Thommie0208/TURTLE/README.md

# TURTLE

The TURTLE, Transportable Universal Research Tool for Live Examination, seeks to allow imagining in the field. This will allow scientists to take it outside and immediately image a sample found there.
