Thommie0208/TURTLE/TURTLE Defense.pdf

# TURTLE

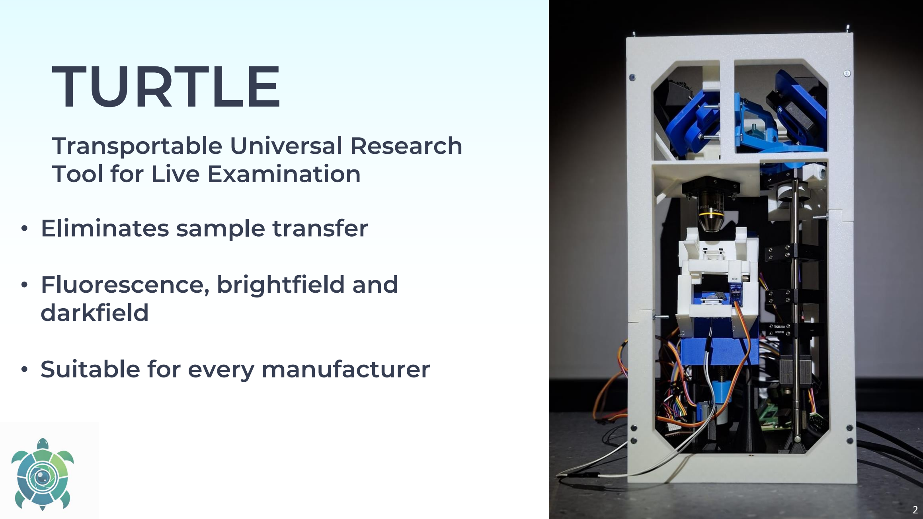
[picture p1: page 1]

# Transportable Universal Research Tool for Live Examination

# - Eliminates sample transfer

# - Fluorescence, brightfield and darkfield

# - Suitable for every manufacturer

# General Information

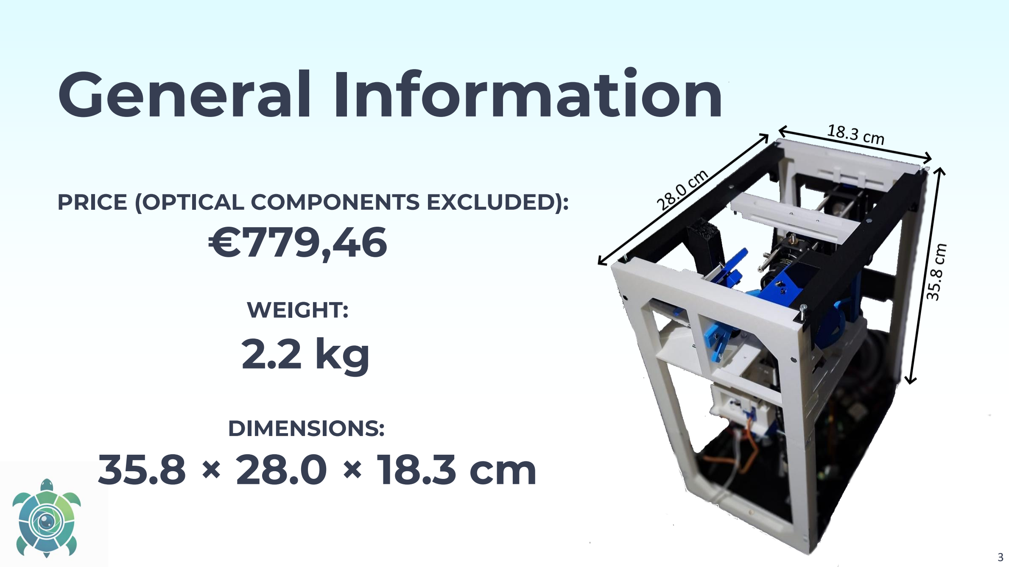
[picture p2: page 2]

## WEIGHT:

# 2.2 kg

## DIMENSIONS:

## PRICE (OPTICAL COMPONENTS EXCLUDED):

35.8 × 28.0 × 18.3 cm

€779,46

# Optical path

## THEORETHICAL MAGNIFICATION:

## RAYLEIGH’S CRITERION:

8.33x

1.057 μm

## CAMERA RESOLUTION:

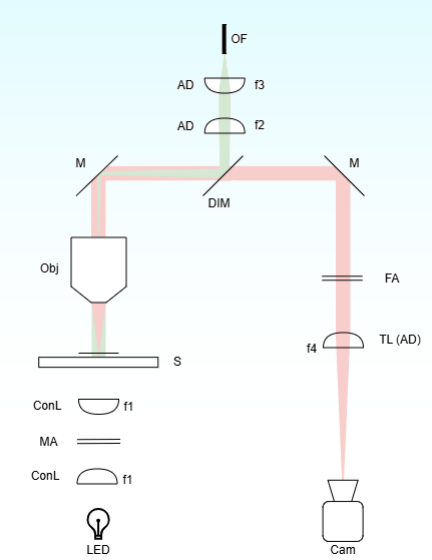
[picture p3: figure]

0.414 μm | Legend: OF = optical fiber, M = mirror, DIM = dichroic mirror,

Obj = objective lens, S = sample, ConL = condensor lens, MA = mask array, FA = filter array, TL = tube lens, AD = achromatic doublet, Cam = camera

f1 = 12 mm, f2 = 150 mm, f3 = 75 mm, f4 = 150 mm | 4

# Optical path

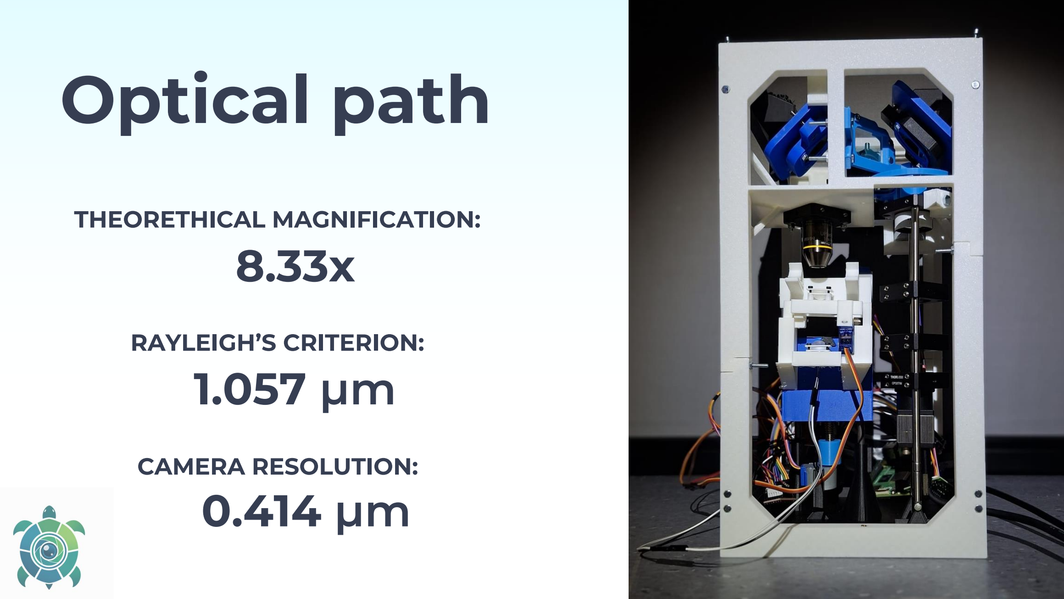
[picture p4: page 4]

## THEORETHICAL MAGNIFICATION:

## RAYLEIGH’S CRITERION:

8.33x

1.057 μm

## CAMERA RESOLUTION:

0.414 μm

# 0.37°/rev

±5°

## ADJUSTEMENT RESOLUTION:

## RANGE:

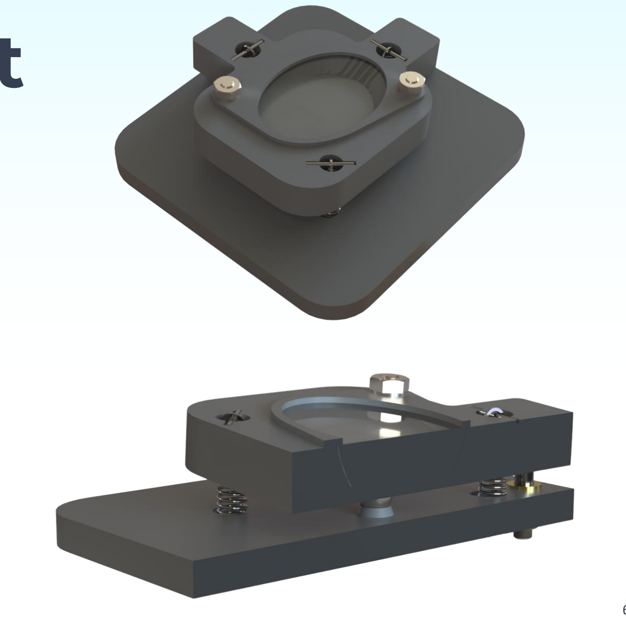
[picture p5: figure]

# Mirror Mount

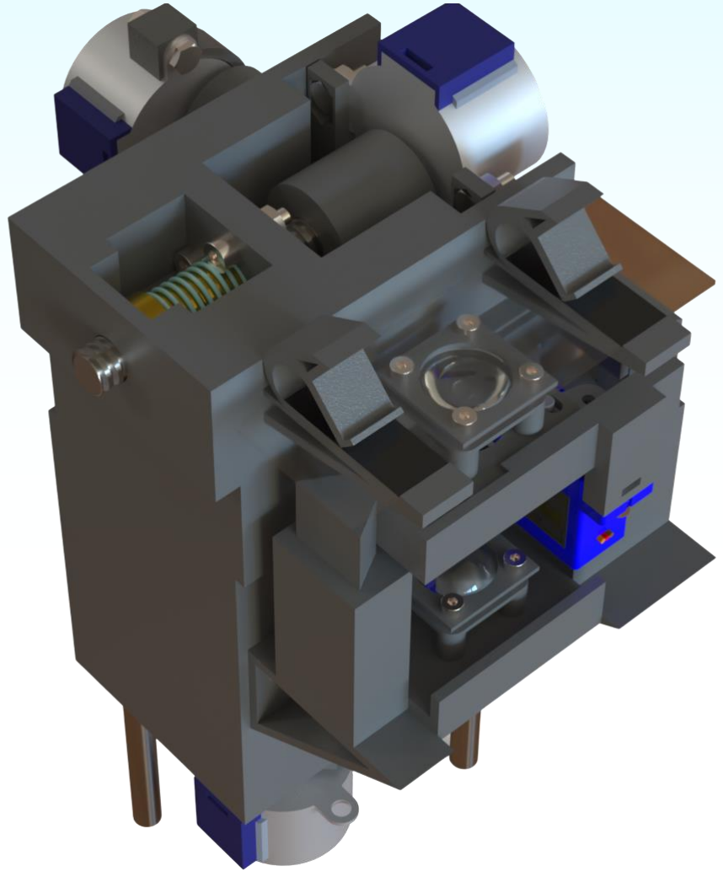
[picture p6: figure]

# Stage

# - Adjustment accuracy: 0.48 μm/step • Range of: • Y: 10mm • X: 8mm • Z: 35mm • Vibrations

# USAF PS75P

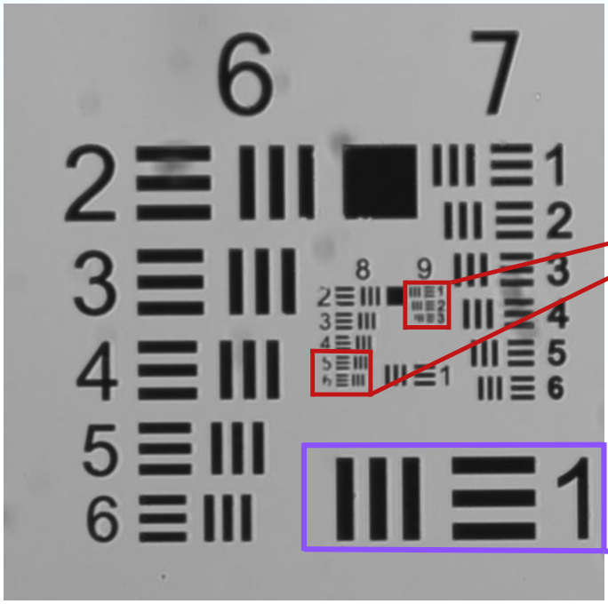
[picture p7: figure]

# Estimated Magnification

# Resolution

# USAF Resolution

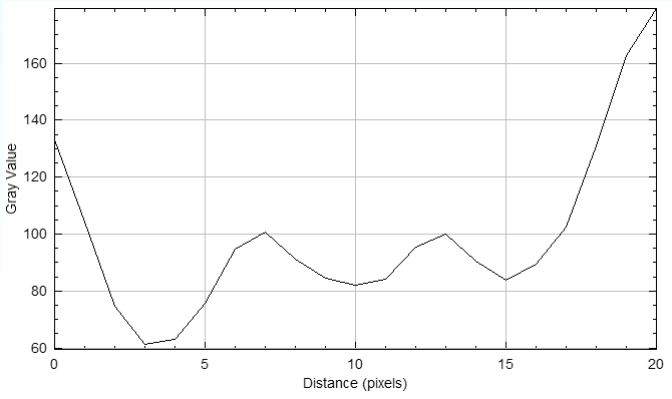
[picture p8: figure]
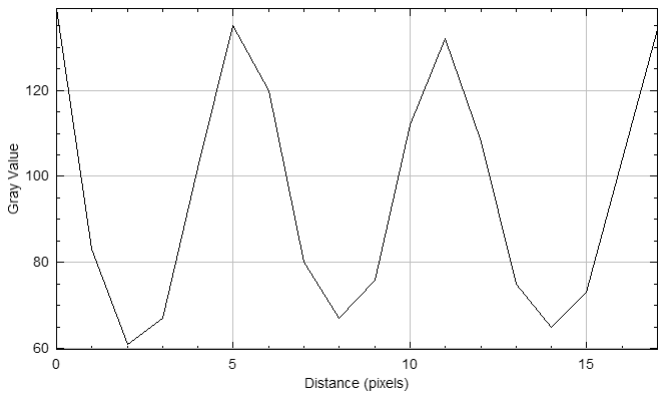
[picture p9: figure]

The intensity curve of group 8 element 5 of sample 4 (measured horizontally)

# - Theoretical values: 1.057 μm - 5 Samples - Required dip of 26.3% - Analysed interspacings: 1.2 μm to 0.78 μm

# 1.2 μm

# Result:

The intensity curve of group 8 element 5 of sample 4 (measured vertically)

# Estimated Magnification

# - Theoretical values: 8.33 - 5 Samples - USAF PS75P: Group 6, element 1 - Full width at half maximum

8.45 ± 0.08

# Result:

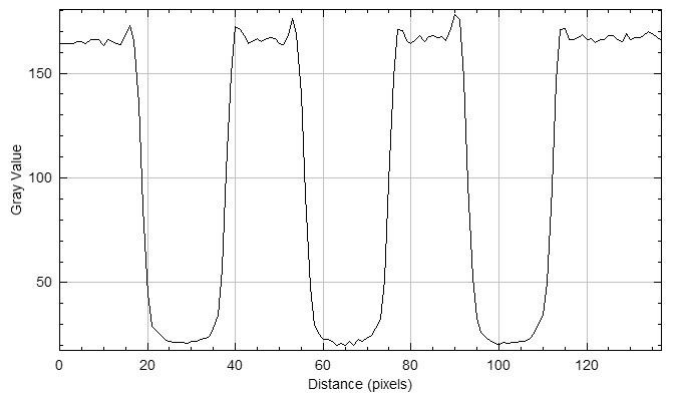
[picture p10: figure]

The intensity curve of group 6 element 1 of sample 1 (measured horizontally)

# Point Spread Function

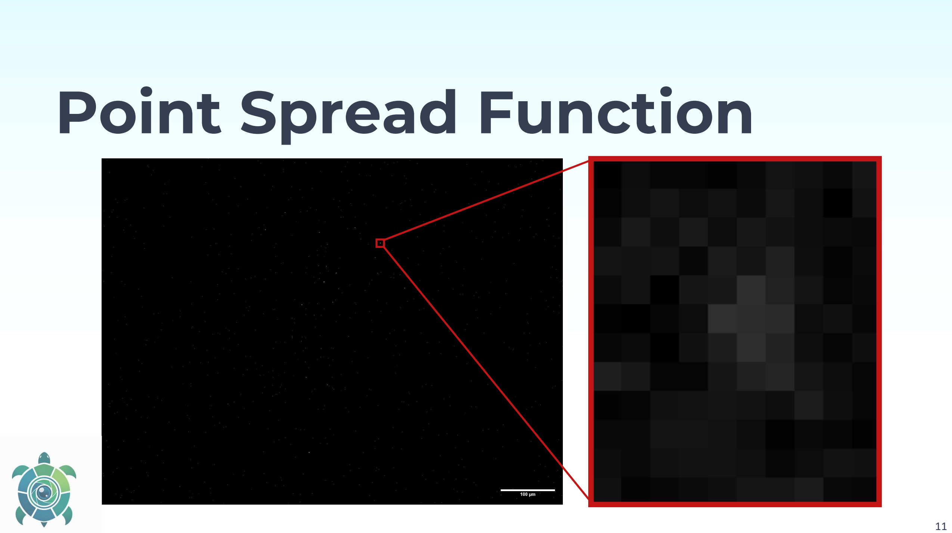
[picture p11: page 10]

# Point Spread Function

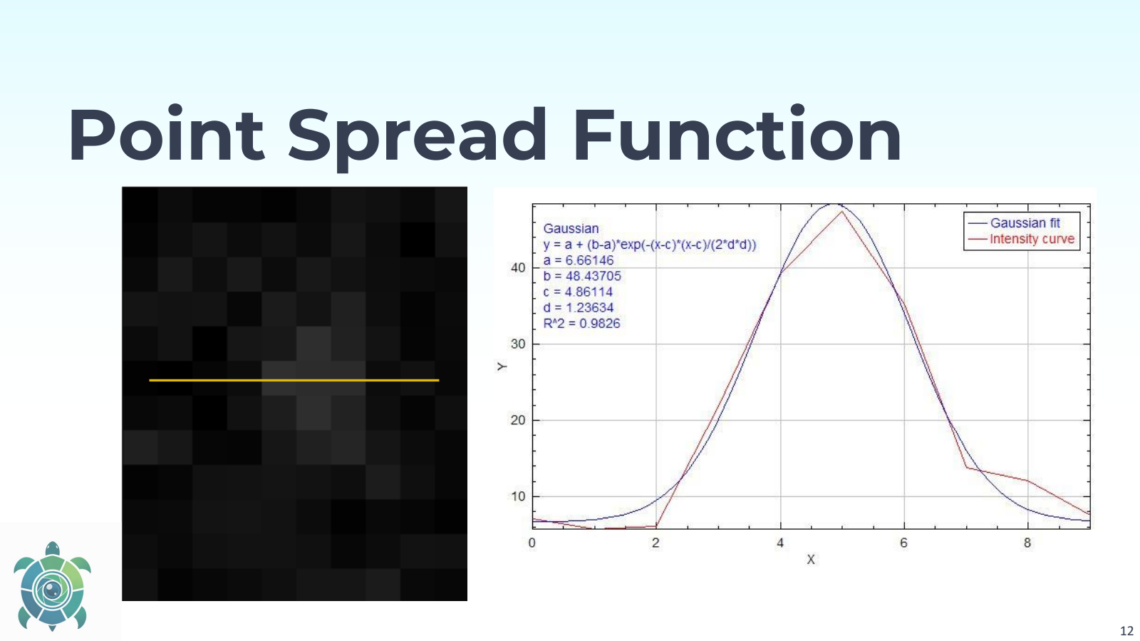
[picture p12: page 11]

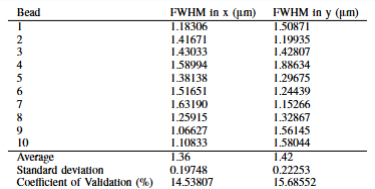
[picture p13: figure]

# 1 μm

## SIMULATED FWHM:

## MEASURED FWHM:

1.39 ± 0.01 μm

# Point Spread Function

# Images

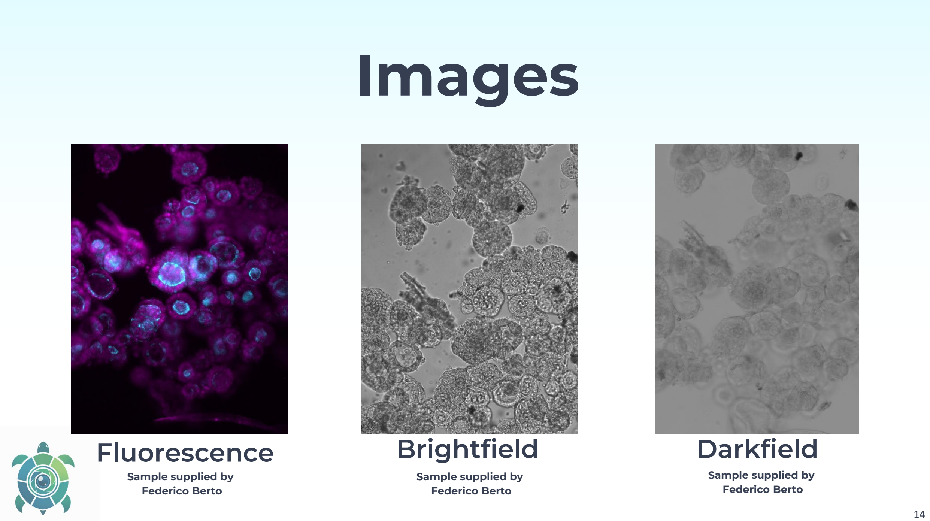
[picture p14: page 13]

Fluorescence | Brightfield | Darkfield
Sample supplied by Federico Berto | Sample supplied by Federico Berto | Sample supplied by Federico Berto

# TURTLE

## To eliminate sample transfer

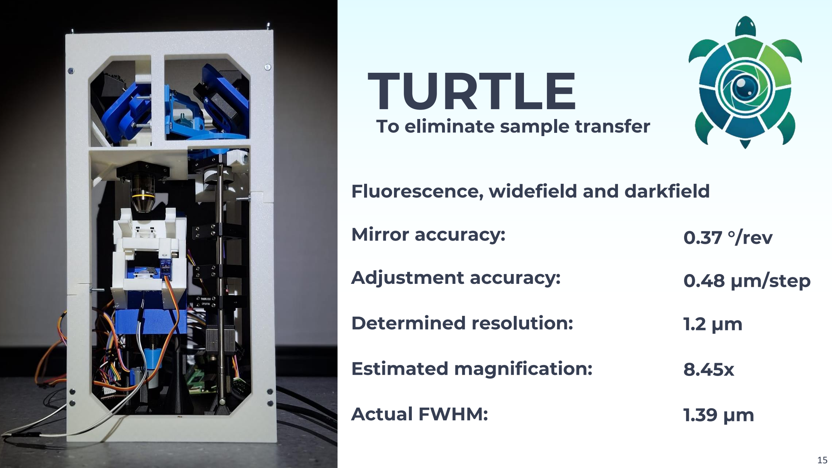
[picture p15: page 14]

## 0.37 °/rev

Determined resolution: | 1.2 μm

## Mirror accuracy:

## Fluorescence, widefield and darkfield

Estimated magnification: | 8.45x
Adjustment accuracy: | 0.48 μm/step
Actual FWHM: | 1.39 μm

# Questions Table of Content

## - TURTLE BILL OF MATERIAL - BALL JOINT BILL OF MATERIAL - GIMBAL BILL OF MATERIAL - 1'' MIRRORS COMPARISON - ELLIPTICAL MIRRORS COMPARISON - Stage - MIRROR DRIFT TEST - LASER MODULE - IMAGE STITCHING - Z-STACK - ELECTRONICS LAYOUT

## - INTERFACE - General Formulas - PSF Formulas - Estimated Magnification - Uncertainty Formulas - OpenUC2 - OpenFlexure - USAF PS75P - PSF Measurements - MORE IMAGES

# TURTLE Bill of Material

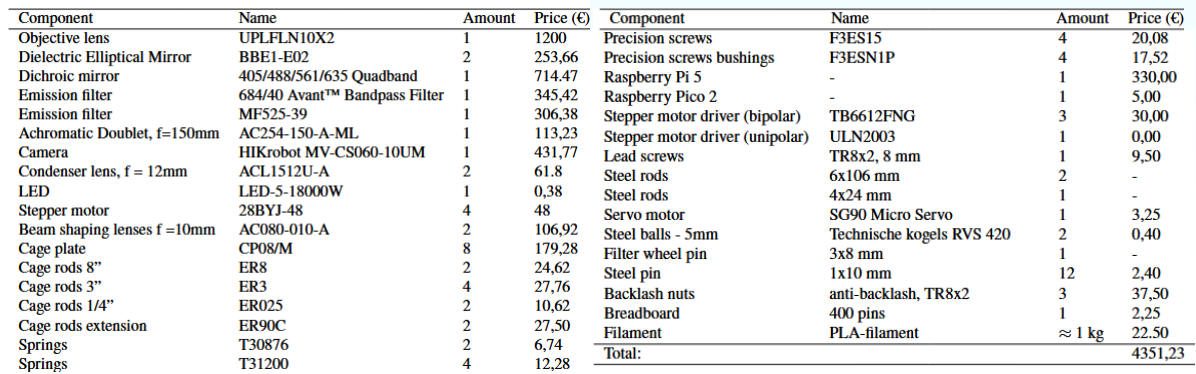
[picture p16: figure]

# Ball Joint Bill of Material

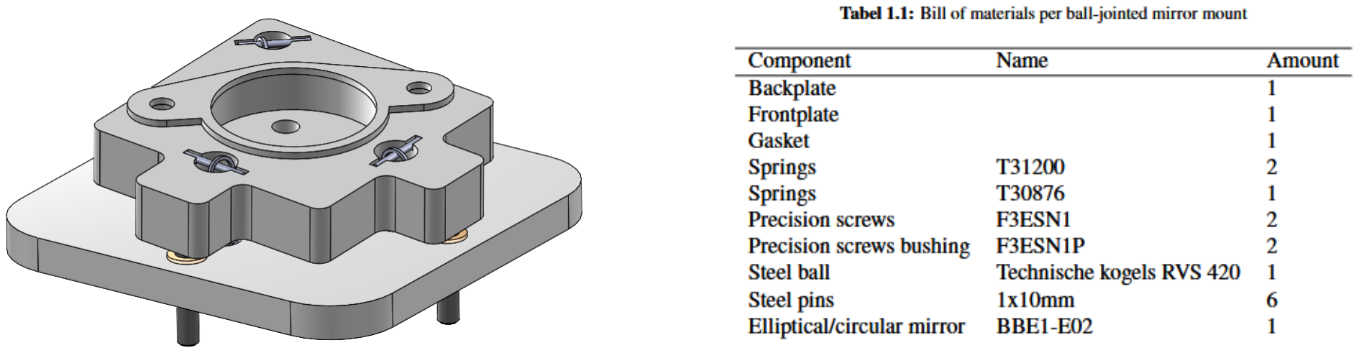
[picture p17: figure]

# Gimbal Bill of Material

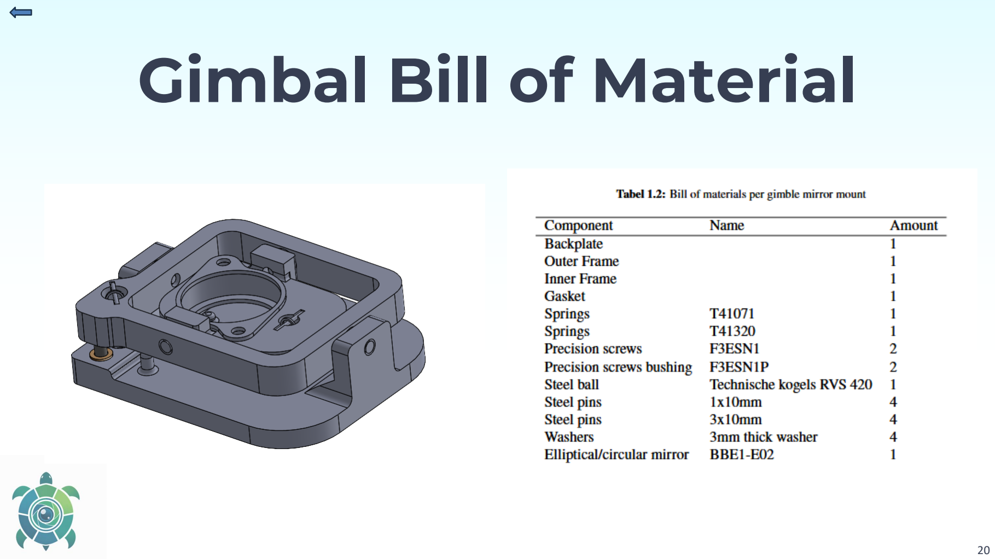
[picture p18: page 19]

# 1" mirrors comparison

| Ball-joint | Gimbal | Thor stand | Thor Gimbal
Resolution (°/rev) | 0.47 | 0.47 | 0.46 | 1.00
Range (°) | ±5 | ±5 | ±4 | ±15
Induced Translation (Dist: Surf – Cen (mm)) | Yes (9.5) | No (0) | Yes (26.6) | No (0)
Dimension (mm) | 53 × 53 × 22 | 70 × 57 × 23 | 50 x 50 x 25 | 54 x 54 x 28
Price (€) | 32.17 | 32.00 | 40.71 | 316.58

# Elliptical mirrors comparison

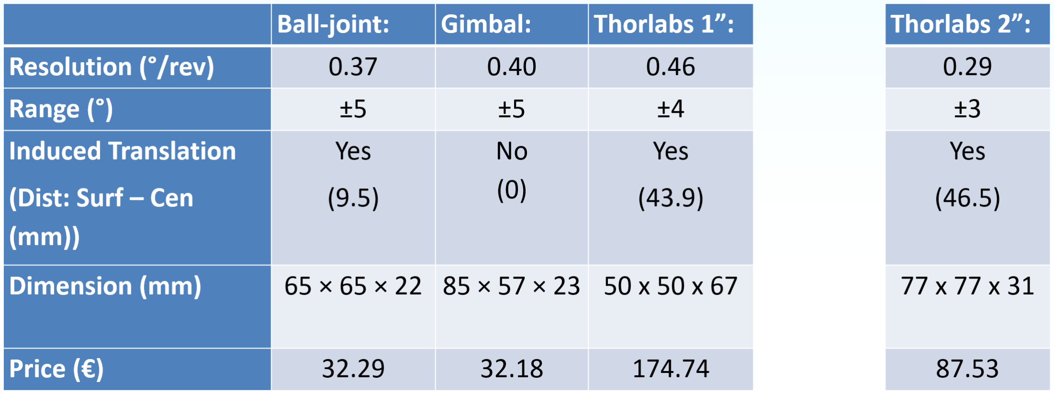
[picture p19: figure]

# Mirror Drift Test

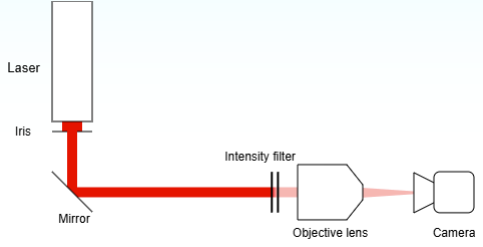
[picture p20: figure]

# Laser module

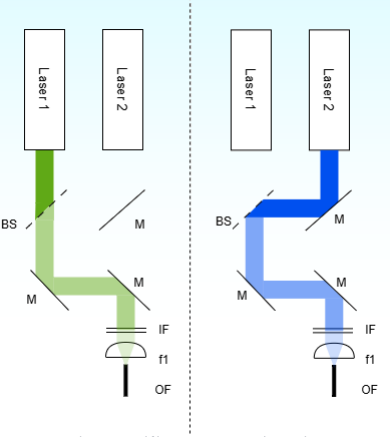
[picture p21: figure]

Legend: OF = optical fiber, M = mirror, BS = beamsplitter, IF = intensity filter

f1 = 10 mm

# - Extendable design

# - Beamsplitter instead of dichroic

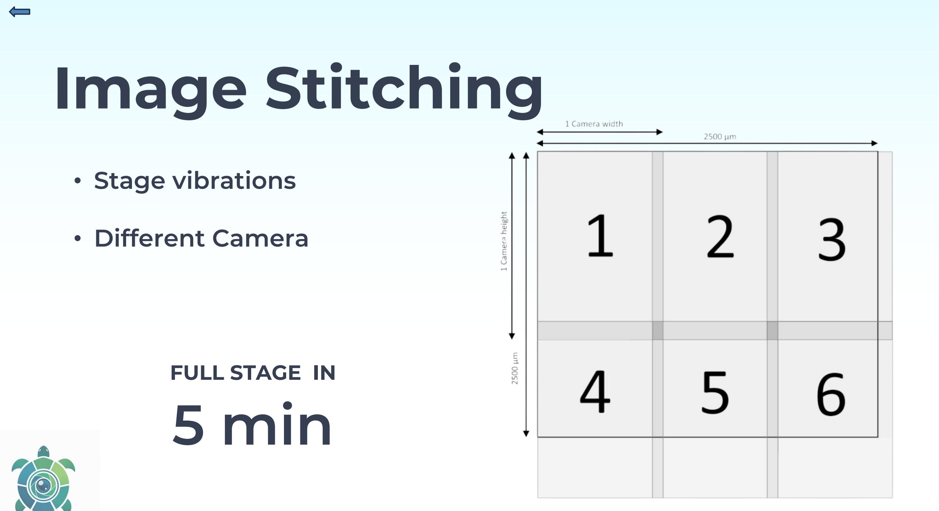
[picture p22: figure]
Image Stitching; 5 min; FULL STAGE IN; • Stage vibrations; • Different Camera

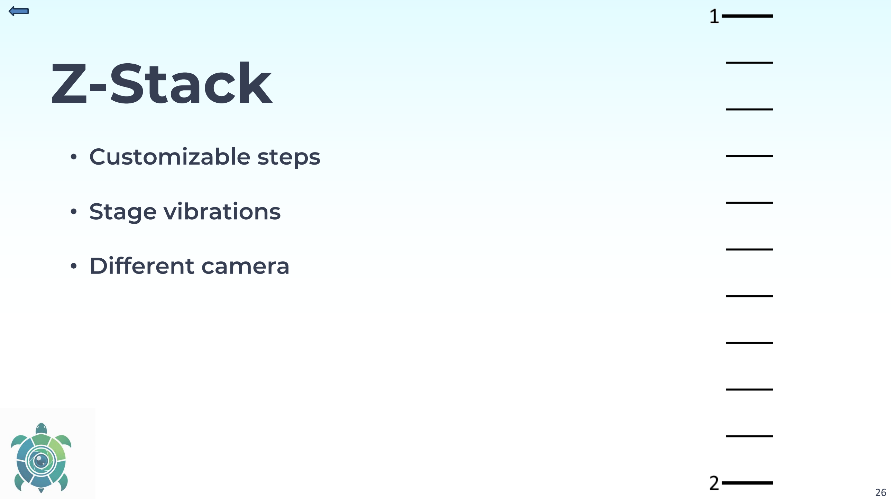
[picture p23: figure]
Z-Stack; • Customizable steps; • Stage vibrations; • Different camera

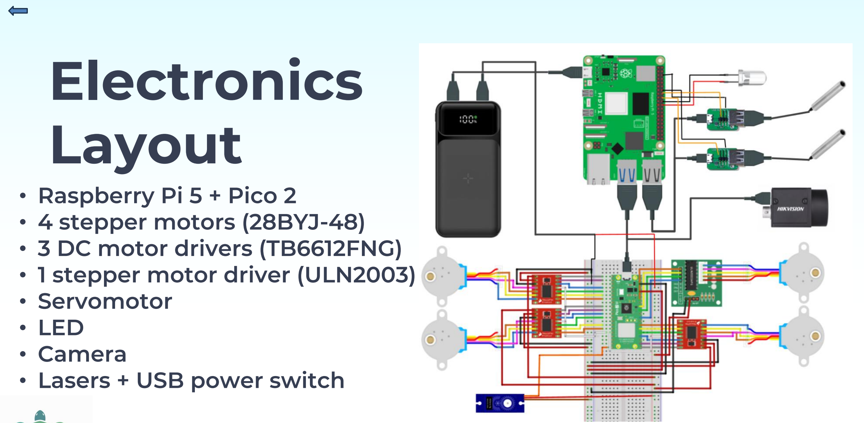
[picture p24: figure]
Electronics Layout

# - Raspberry Pi 5 + Pico 2 • 4 stepper motors (28BYJ

- 3 DC motor drivers (TB6612FNG) • 1 stepper motor driver (ULN2003) • Servomotor • LED • Camera • Lasers + USB power switch

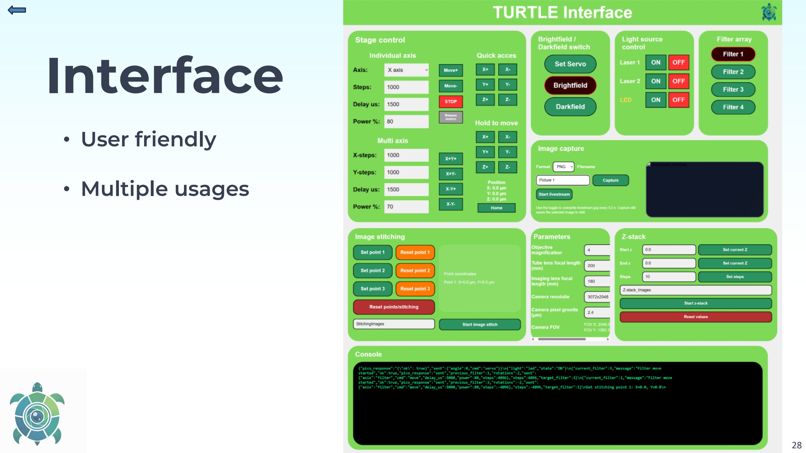
[picture p25: figure]
Interface; • User friendly; • Multiple usages

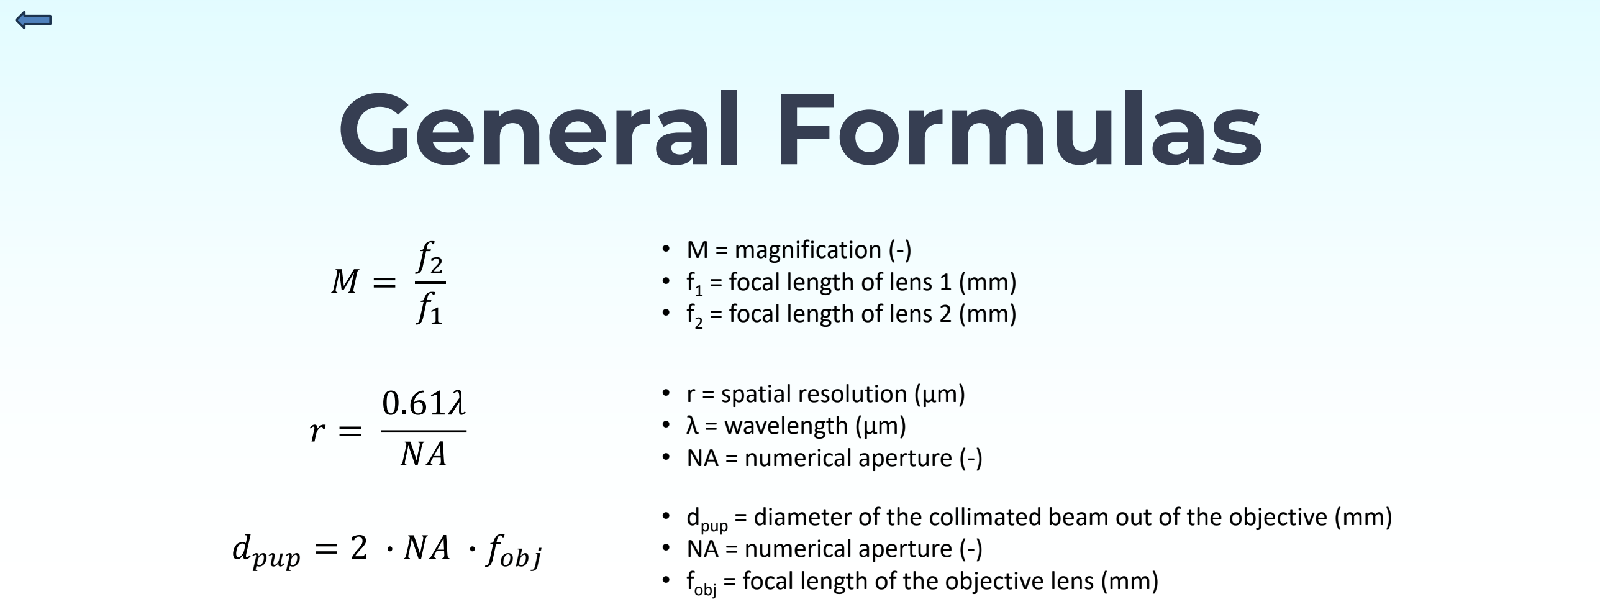
[picture p26: figure]
General Formulas; dpup = 2 ∙ NA ∙ fobj; • M = magnification (-) • f1 = focal length of lens 1 (mm) • f2 = focal length of lens 2 (mm); • r = spatial resolution (μm) • λ = wavelength (μm) • NA = numerical aperture (-); • NA = numerical aperture (-)

Lmax =

ftube(dtube − dpup)

dimage sensor

- dpup = diameter of the collimated beam out of the objective (mm)
- fobj = focal length of the objective lens (mm)
- Lmax = maximum length between the objective and tube lens (mm)
- f

tube = focal length of the tube lens (mm)
- dtube = diameter of the tube lens (mm)
- dpup = diameter of the collimated beam out of the objective (mm)
- dimage sensor = diameter of the image sensor (mm)

# PSF Formulas

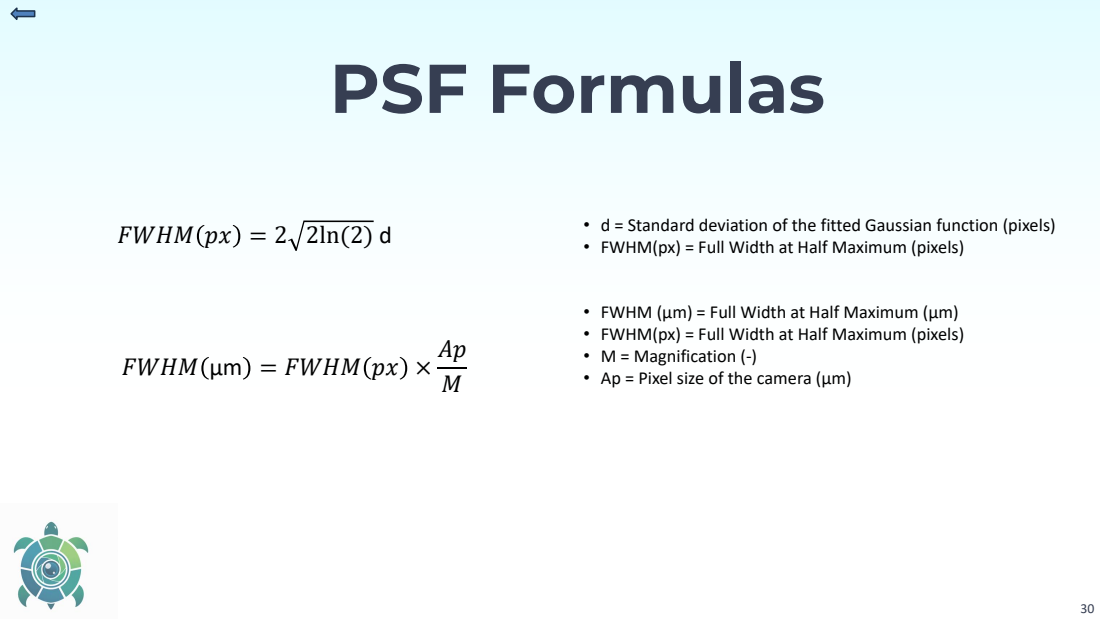
[picture p27: page 29]
FWHM px = 2 2ln(2) d

• d = Standard deviation of the fitted Gaussian function (pixels)
• FWHM(px) = Full Width at Half Maximum (pixels)

• FWHM (μm) = Full Width at Half Maximum (μm)
• M = Magnification (-)
• Ap = Pixel size of the camera (μm)

FWHM μm = FWHM px ×

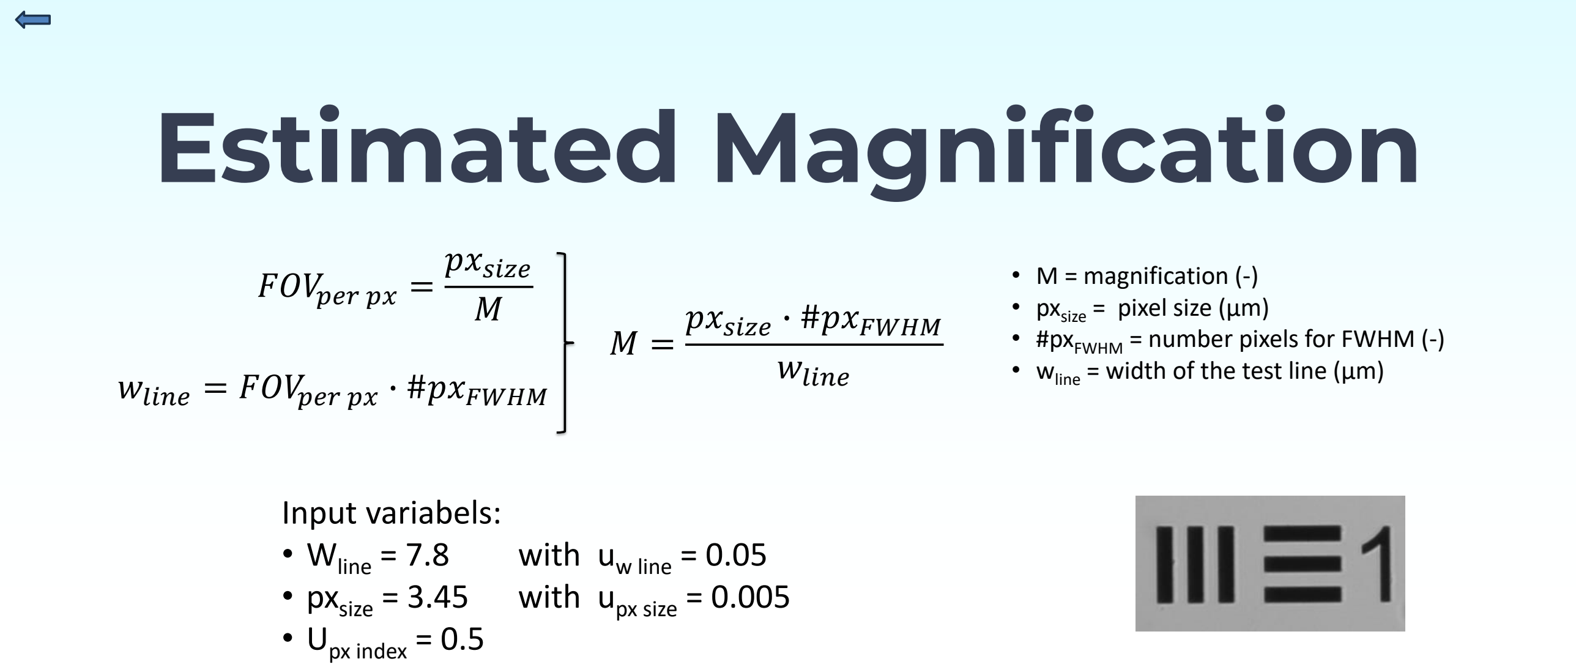
[picture p28: figure]
Estimated Magnification; FOVper px =; pxsize M; wline = FOVper px; ∙ #pxFWHM; pxsize ∙ #pxFWHM; wline; • M = magnification (-) • pxsize = pixel size (μm) • #pxFWHM = number pixels for FWHM (-) • wline = width of the test line (μm); Input variabels:; • Wline = 7.8; with uw line = 0.05; • pxsize = 3.45; with upx size = 0.005; • Upx index = 0.5

## Magnification vertical:

8,4 ± 0,1

## Magnification horizontal:

8,5 ± 0,1

## Magnification estimate:

8,45 ± 0,08

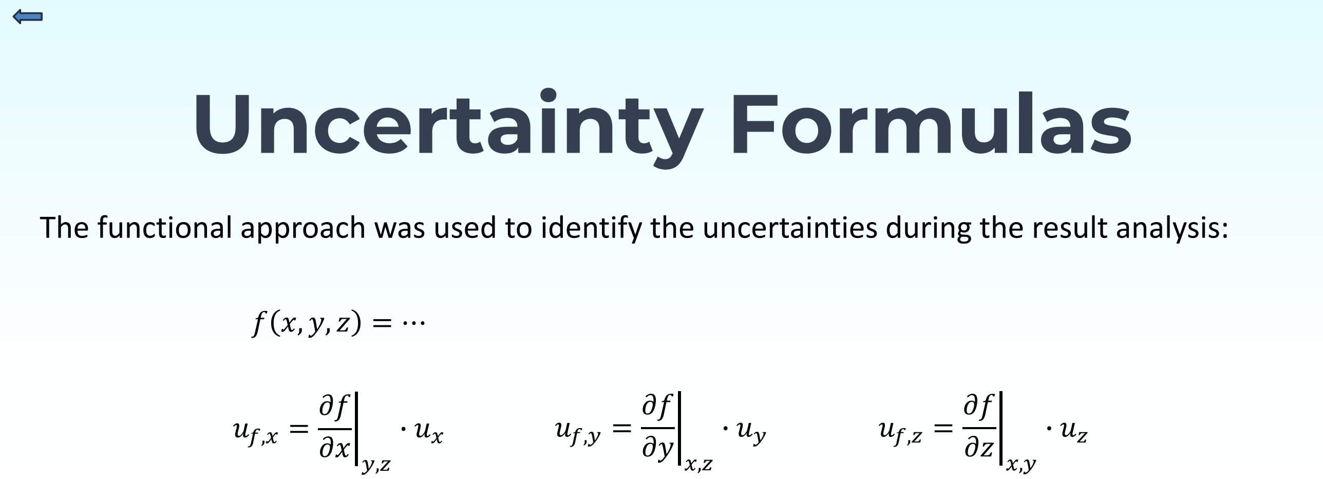
[picture p29: figure]
Uncertainty Formulas

The functional approach was used to identify the uncertainties during the result analysis:

uf = uf,x

2 + uf,y

2 + uf,z

2

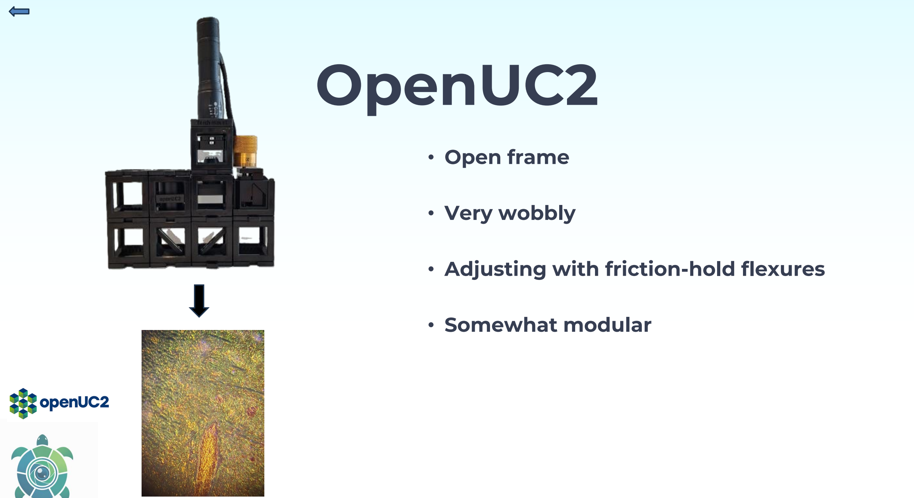
[picture p30: figure]
OpenUC2; • Open frame; • Very wobbly; • Adjusting with friction-hold flexures; • Somewhat modular

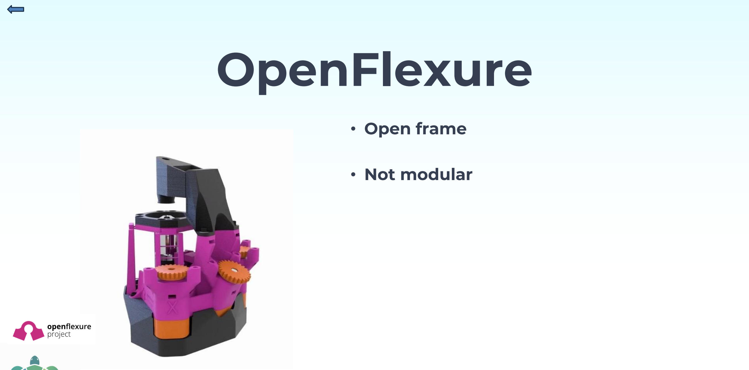
[picture p31: figure]
OpenFlexure; • Open frame; • Not modular

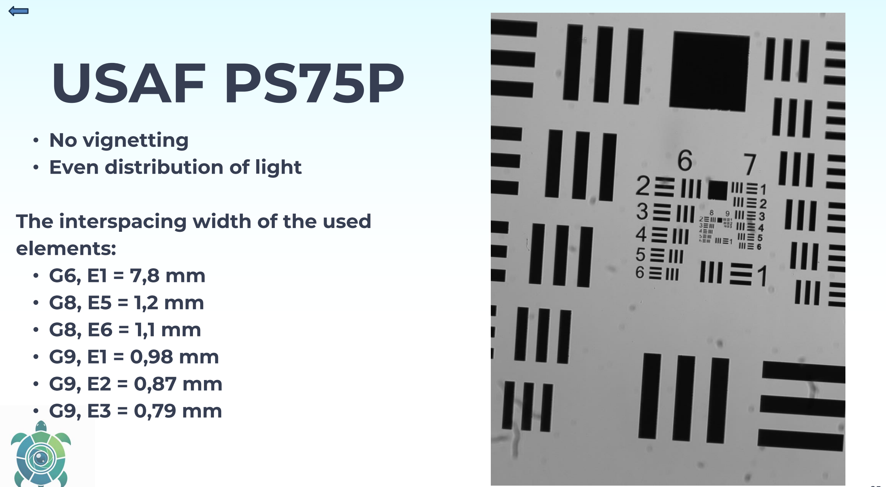
[picture p32: figure]
USAF PS75P; The interspacing width of the used

## - No vignetting • Even distribution of light

elements: • G6, E1 = 7,8 mm • G8, E5 = 1,2 mm • G8, E6 = 1,1 mm • G9, E1 = 0,98 mm • G9, E2 = 0,87 mm • G9, E3 = 0,79 mm

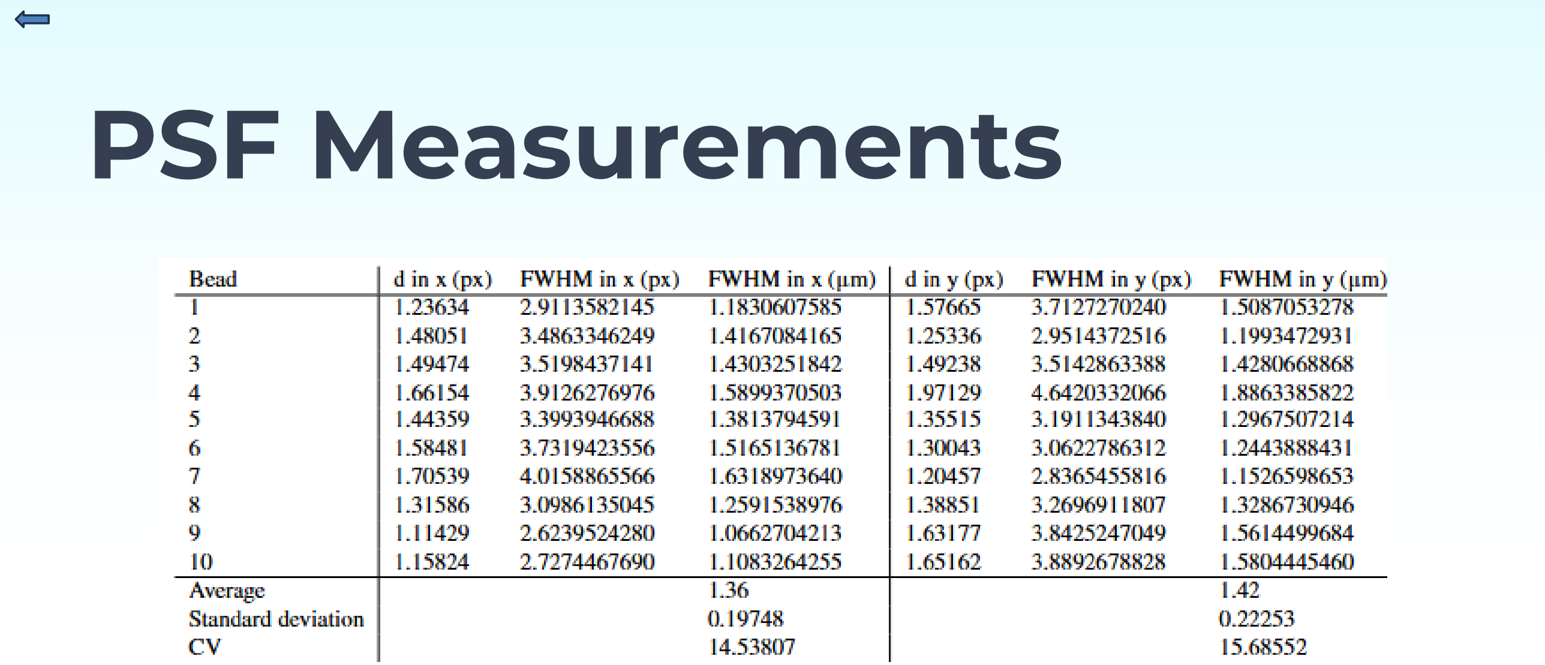
[picture p33: figure]
PSF Measurements

# More images

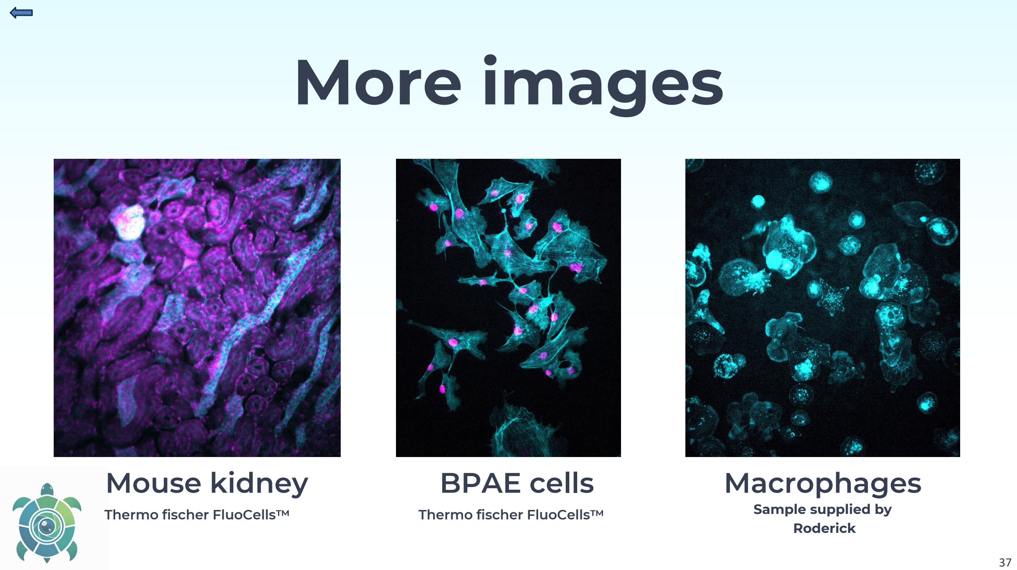
[picture p34: page 36]

Mouse kidney | BPAE cells | Macrophages
Thermo fischer FluoCells | Thermo fischer FluoCells | Sample supplied by Roderick

# More images

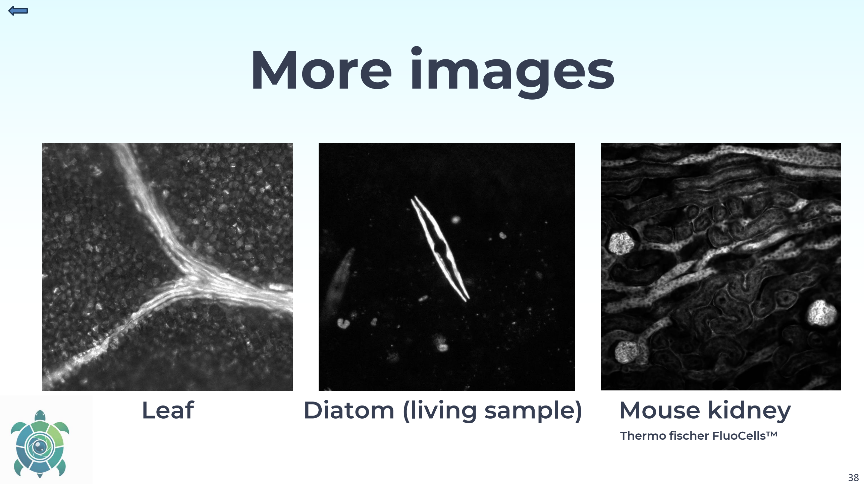
[picture p35: page 37]

Leaf | Diatom (living sample) | Mouse kidney Thermo fischer FluoCells

# Stage

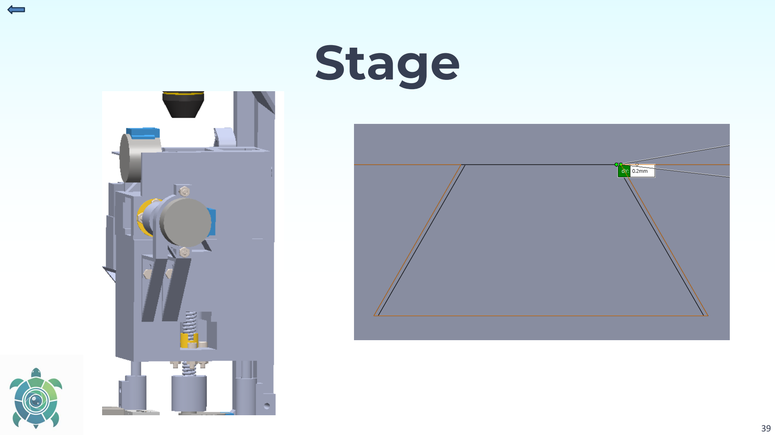
[picture p36: page 38]
