Thommie0208/TURTLE/Calculations/Calculations for TURTLE design/Diagram_Ball-Joint_Mirror_Mount_.png

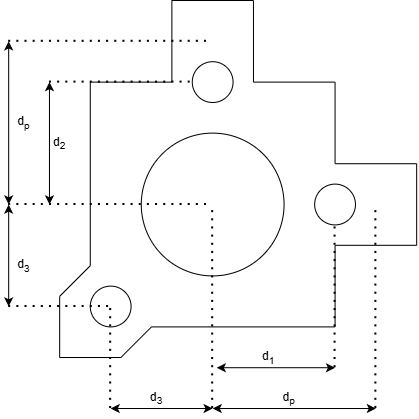
Calculations/Calculations for TURTLE design/Diagram_Ball-Joint_Mirror_Mount_.png
