Thommie0208/TURTLE/Calculations/Calculations for TURTLE design/Diagram_Optical_Axis_Shift.png

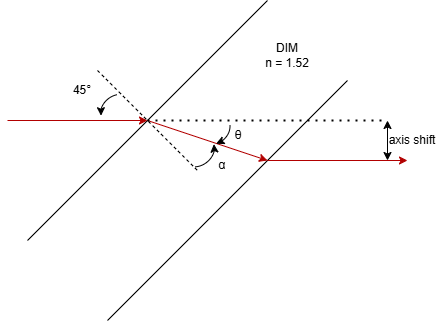
Calculations/Calculations for TURTLE design/Diagram_Optical_Axis_Shift.png
