Thommie0208/TURTLE/Calculations/Calculations for TURTLE design/Length_overview_code.png

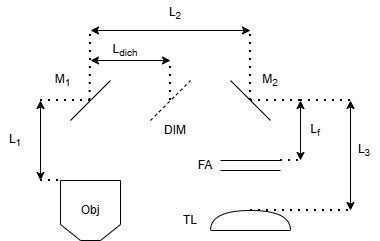
Calculations/Calculations for TURTLE design/Length_overview_code.png
