Thommie0208/TURTLE/TURTLE Software/Images/capture.jpg

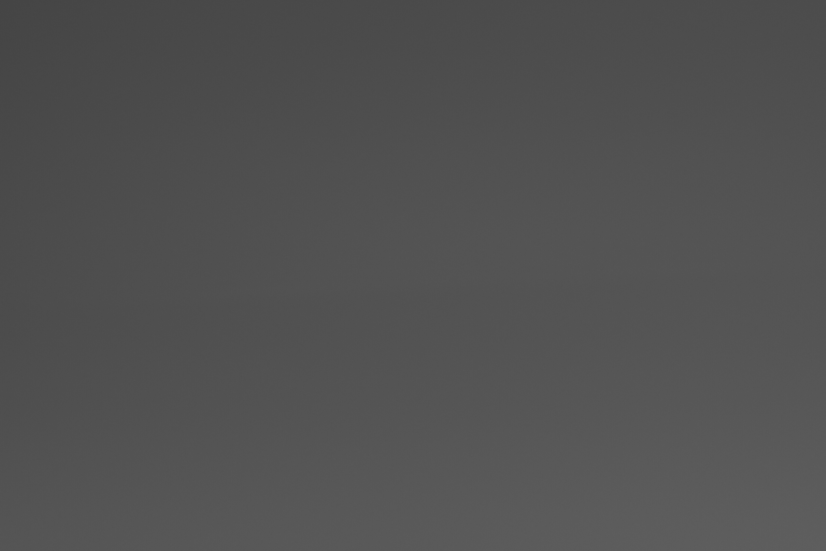
TURTLE Software/Images/capture.jpg
