Thommie0208/TURTLE/CAD/Turtle/Full Sampleholder/Servo/SG90 - Micro Servo 9g - Tower Pro.SLDASM

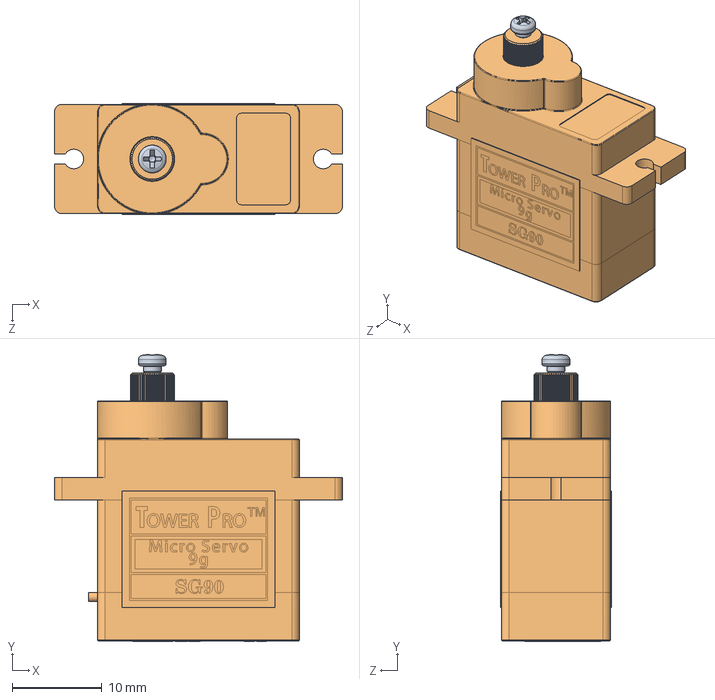
[picture p41: CAD file, 2026-06-19]
CAD/Turtle/Full Sampleholder/Servo/SG90 - Micro Servo 9g - Tower Pro.SLDASM
32.1 x 32.0 x 12.4 mm
SG90 - Micro Servo 9g - Tower Pro.1
SG90 - Micro Servo 9g - Tower Pro.6
