Thommie0208/TURTLE/CAD/Turtle/Eliptical Mirror Mount - Ball Joint 2.SLDASM

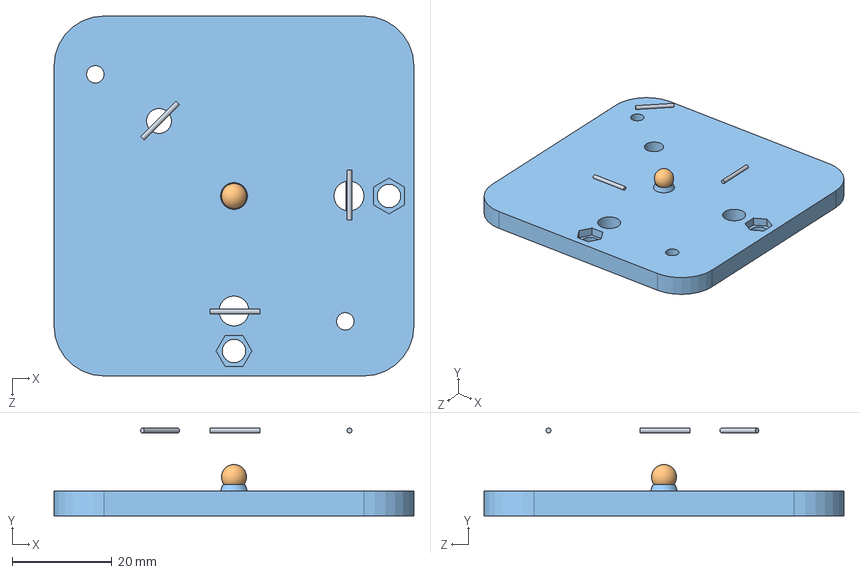
[picture p43: CAD file, 2026-06-19]
CAD/Turtle/Eliptical Mirror Mount - Ball Joint 2.SLDASM
72.0 x 17.6 x 72.0 mm
Back Plate - Eliptical Mirror Mount
5mm Steel Ball
1x10mm Steel Pin x 6
