Thommie0208/TURTLE/CAD/Assemblies not used in TURTLE but useful/1 Inch Backplate - Gimbal Mount - Thor Adapted.SLDPRT

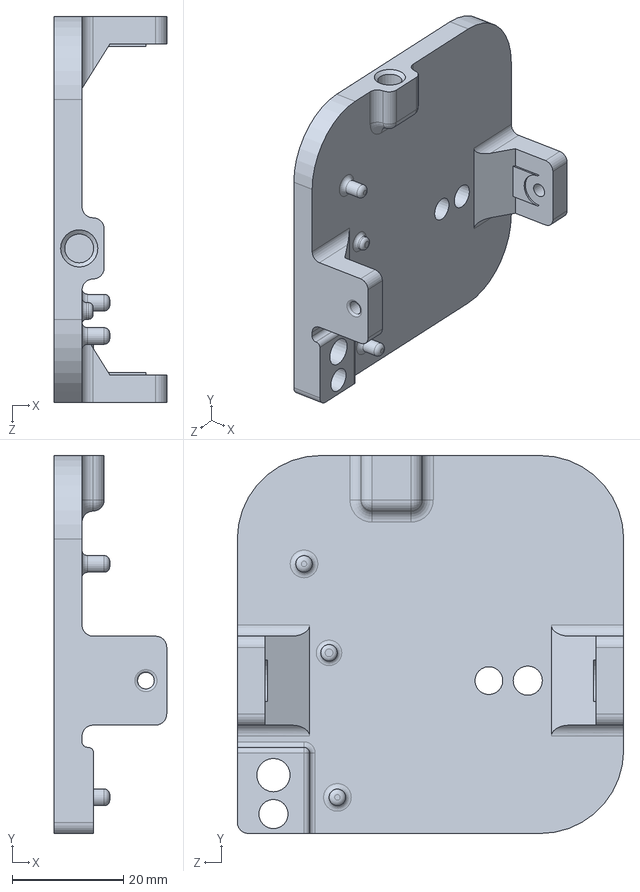
[picture p44: CAD file, 2026-06-19]
CAD/Assemblies not used in TURTLE but useful/1 Inch Backplate - Gimbal Mount - Thor Adapted.SLDPRT
20.2 x 68.0 x 69.5 mm
