Thommie0208/TURTLE/CAD/Turtle/Eliptical Mirror Mount - Ball Joint/1x10mm Steel Pin.SLDPRT

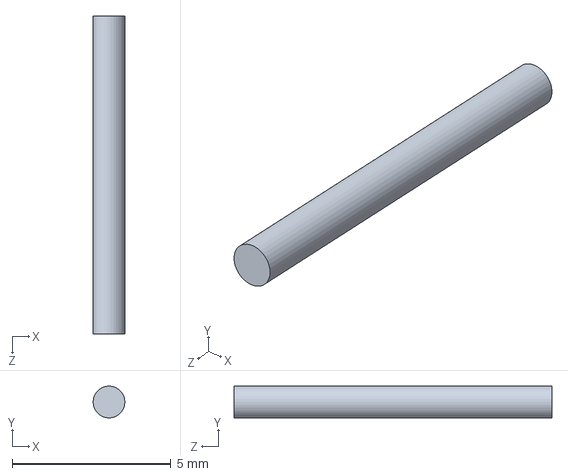
[picture p45: CAD file, 2026-06-15]
CAD/Turtle/Eliptical Mirror Mount - Ball Joint/1x10mm Steel Pin.SLDPRT
1.00 x 0.996 x 10.0 mm
