Thommie0208/TURTLE/CAD/Turtle/Full Sampleholder/Sampleholder Top.SLDPRT

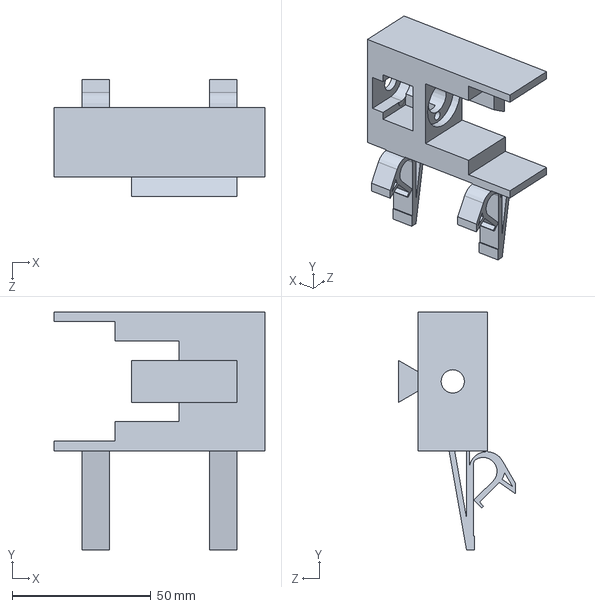
[picture p46: CAD file, 2026-06-19]
CAD/Turtle/Full Sampleholder/Sampleholder Top.SLDPRT
76.0 x 85.7 x 42.0 mm
