Thommie0208/TURTLE/CAD/Turtle/Solidworks etc/R1_24-006-005.SLDPRT

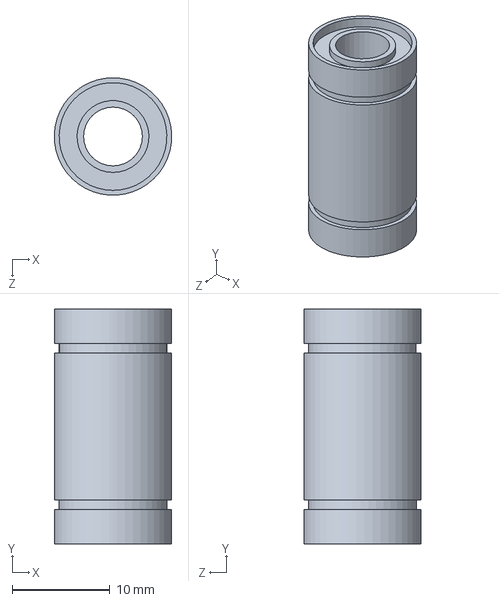
[picture p47: CAD file, 2026-06-19]
CAD/Turtle/Solidworks etc/R1_24-006-005.SLDPRT
12.0 x 24.0 x 12.0 mm
