Thommie0208/TURTLE/CAD/Assemblies not used in TURTLE but useful/Back Plate - 1 Inch Mirror Mount - Thor adapt.SLDPRT

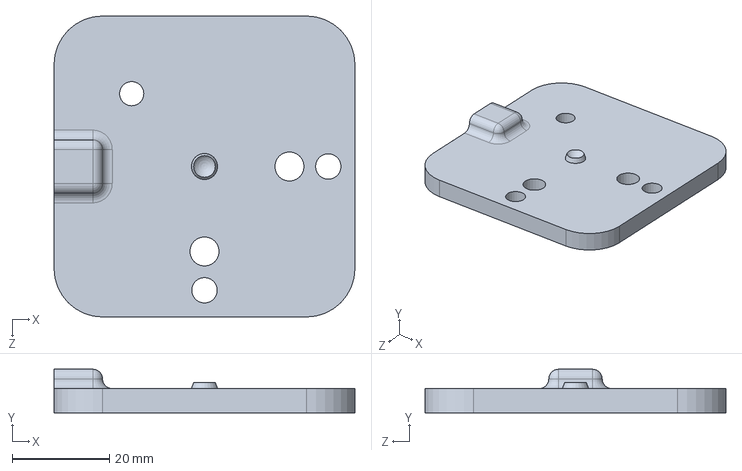
[picture p48: CAD file, 2026-06-19]
CAD/Assemblies not used in TURTLE but useful/Back Plate - 1 Inch Mirror Mount - Thor adapt.SLDPRT
62.0 x 9.00 x 62.0 mm
