Thommie0208/TURTLE/CAD/Turtle/Eliptical Mirror Mount - Ball Joint/Back Plate - Eliptical Mirror Mount.SLDPRT

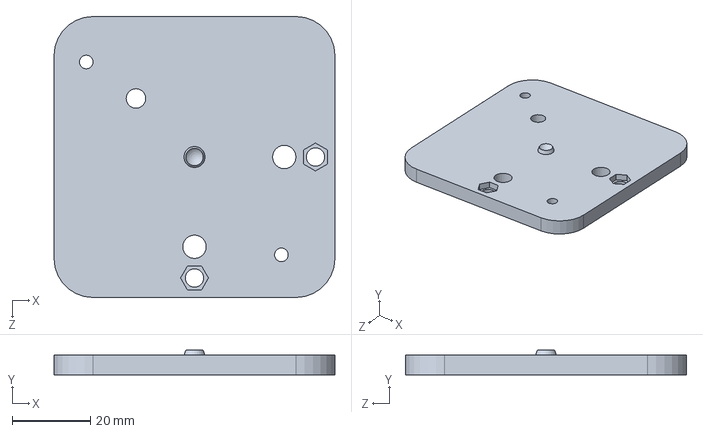
[picture p49: CAD file, 2026-06-15]
CAD/Turtle/Eliptical Mirror Mount - Ball Joint/Back Plate - Eliptical Mirror Mount.SLDPRT
72.0 x 6.28 x 72.0 mm
