Thommie0208/TURTLE/CAD/Turtle/Full Sampleholder/DarkfieldHolder.SLDPRT

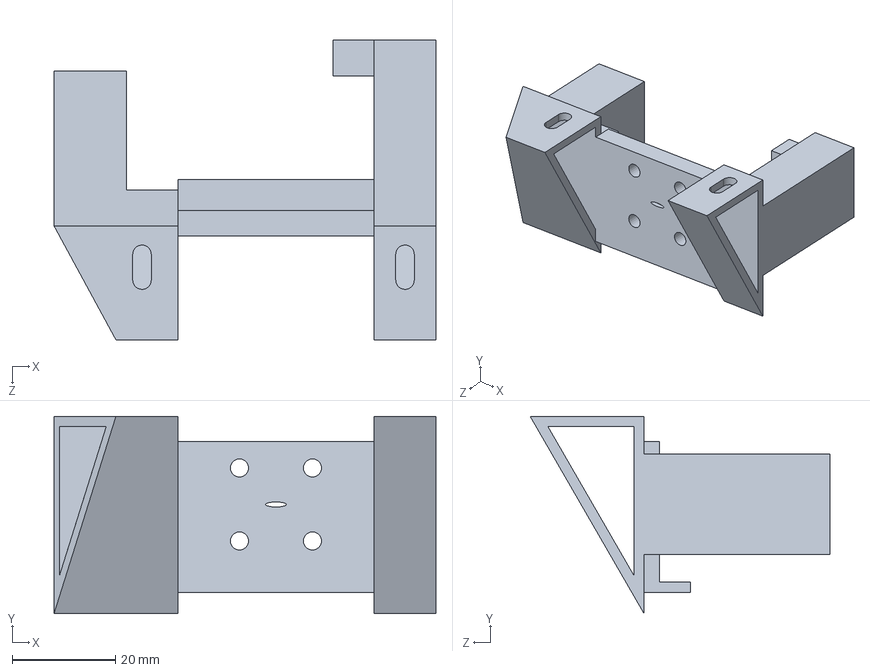
[picture p50: CAD file, 2026-06-19]
CAD/Turtle/Full Sampleholder/DarkfieldHolder.SLDPRT
74.0 x 38.2 x 58.1 mm
