Thommie0208/TURTLE/CAD/Turtle/Full Sampleholder/Servo/SG90 - Micro Servo 9g - Tower Pro.1.SLDPRT

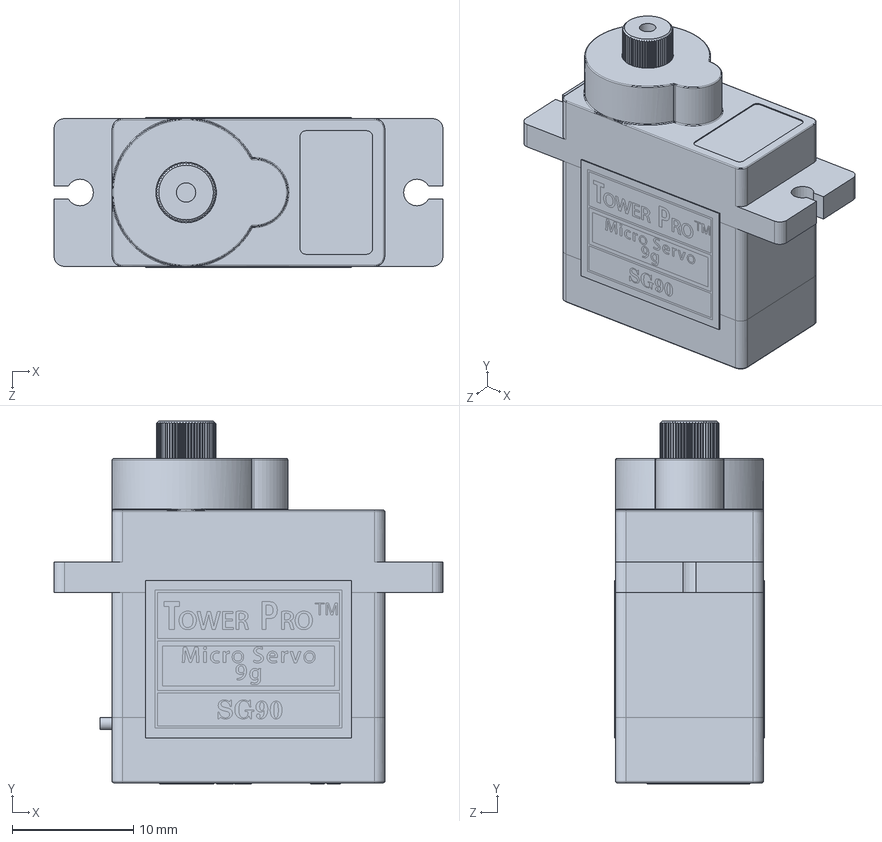
[picture p51: CAD file, 2026-06-15]
CAD/Turtle/Full Sampleholder/Servo/SG90 - Micro Servo 9g - Tower Pro.1.SLDPRT
32.1 x 30.0 x 12.4 mm
