Thommie0208/TURTLE/CAD/Turtle/Solidworks etc/F3ES15-Solidworks.sldprt

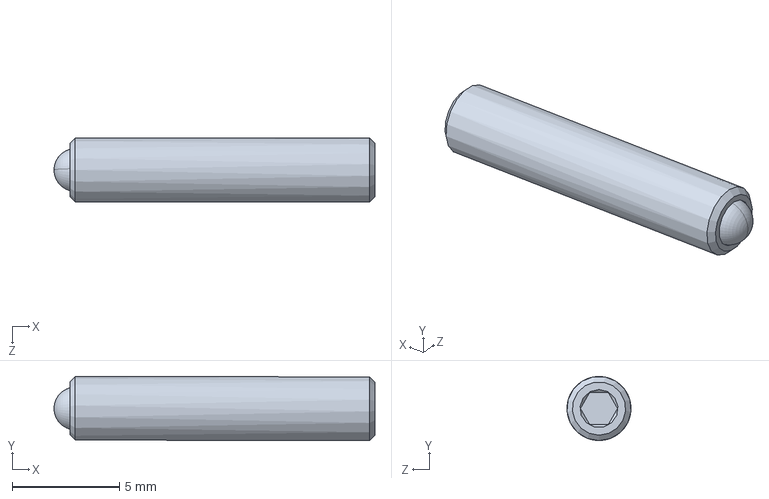
[picture p52: CAD file, 2026-06-19]
CAD/Turtle/Solidworks etc/F3ES15-Solidworks.sldprt
15.0 x 3.00 x 2.99 mm
