Thommie0208/TURTLE/CAD/Turtle/Eliptical Mirror Mount - Ball Joint/5mm Steel Ball.SLDPRT

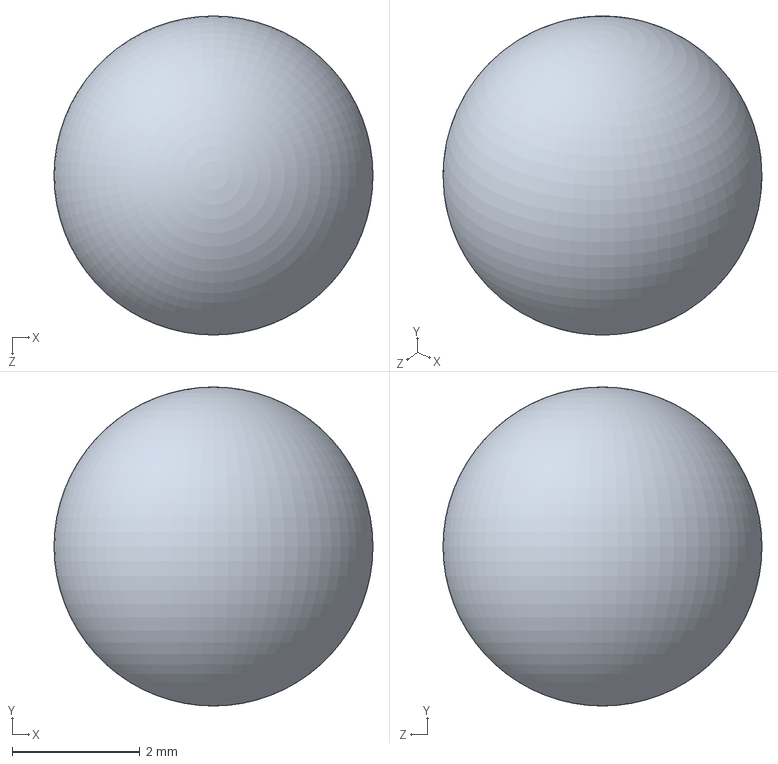
[picture p53: CAD file, 2026-06-15]
CAD/Turtle/Eliptical Mirror Mount - Ball Joint/5mm Steel Ball.SLDPRT
5.00 x 5.00 x 5.00 mm
