Thommie0208/TURTLE/CAD/Turtle/Full Sampleholder/Glass slide.SLDPRT

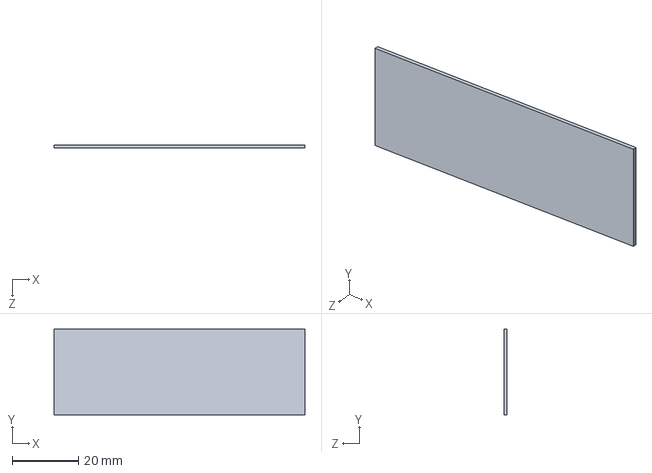
[picture p54: CAD file, 2026-06-19]
CAD/Turtle/Full Sampleholder/Glass slide.SLDPRT
76.0 x 26.0 x 1.00 mm
