Thommie0208/TURTLE/CAD/Turtle/Full Sampleholder/Servo/SG90 - Micro Servo 9g - Tower Pro.5.SLDPRT

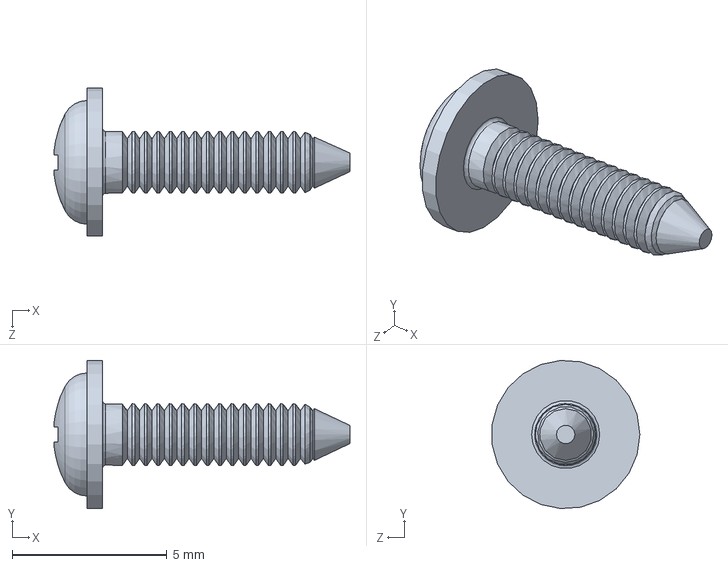
[picture p55: CAD file, 2026-06-15]
CAD/Turtle/Full Sampleholder/Servo/SG90 - Micro Servo 9g - Tower Pro.5.SLDPRT
9.57 x 4.79 x 4.78 mm
