Thommie0208/TURTLE/CAD/Turtle/Solidworks etc/Spring D10.8.SLDPRT

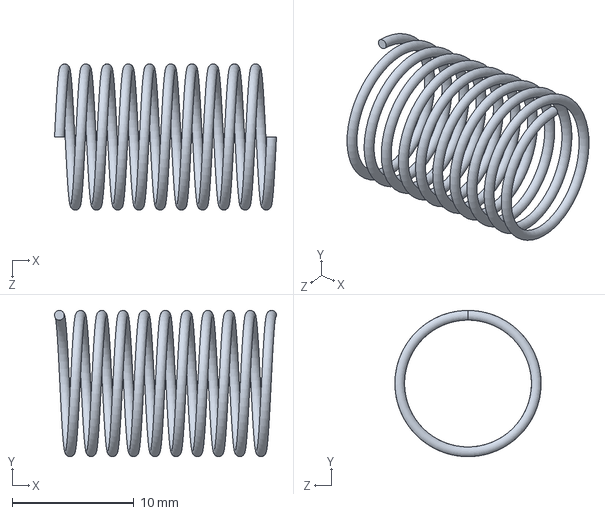
[picture p56: CAD file, 2026-06-19]
CAD/Turtle/Solidworks etc/Spring D10.8.SLDPRT
18.2 x 12.0 x 12.0 mm
