Thommie0208/TURTLE/CAD/Turtle/Spring MM.SLDPRT

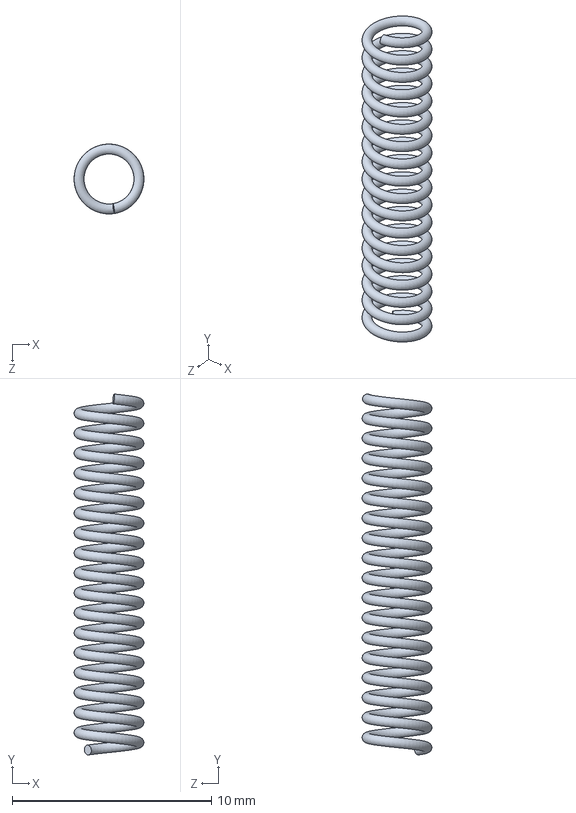
[picture p57: CAD file, 2026-06-19]
CAD/Turtle/Spring MM.SLDPRT
3.50 x 18.1 x 3.50 mm
