Thommie0208/TURTLE/CAD/Turtle/Eliptical Mirror Mount - Ball Joint/Eliptical gasket.SLDPRT

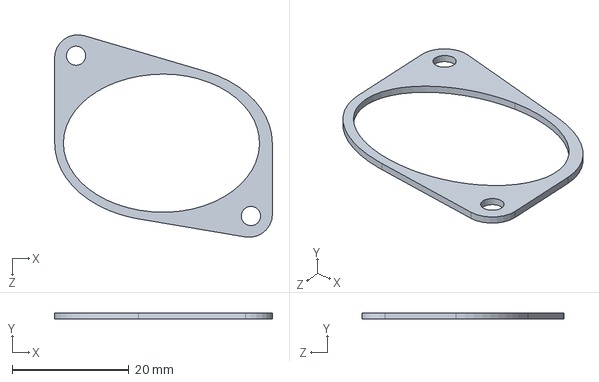
[picture p58: CAD file, 2026-06-15]
CAD/Turtle/Eliptical Mirror Mount - Ball Joint/Eliptical gasket.SLDPRT
37.4 x 1.00 x 34.7 mm
