Thommie0208/TURTLE/CAD/Turtle/Frame 2.2.SLDPRT

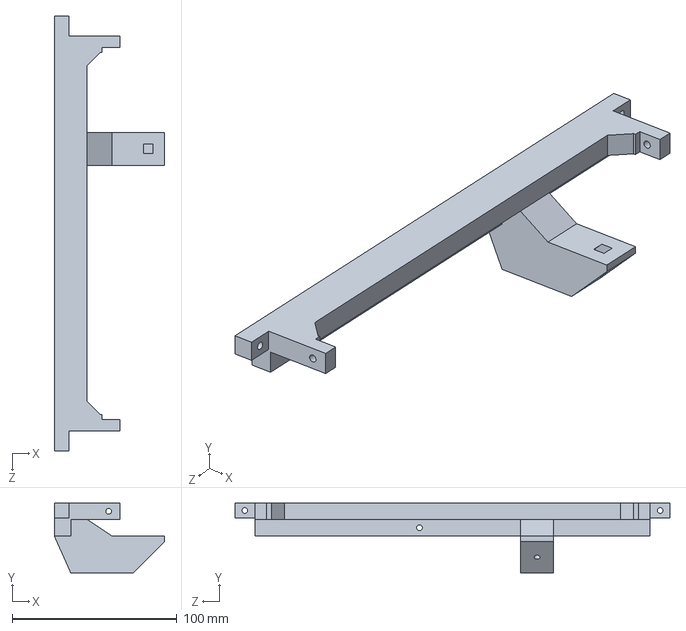
[picture p59: CAD file, 2026-06-19]
CAD/Turtle/Frame 2.2.SLDPRT
67.0 x 42.4 x 264.0 mm
