Thommie0208/TURTLE/CAD/Turtle/Full Sampleholder/Servo/SG90 - Micro Servo 9g - Tower Pro.4.SLDPRT

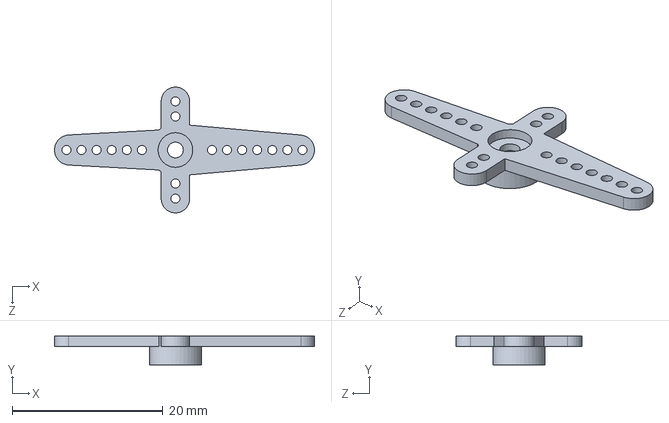
[picture p60: CAD file, 2026-06-15]
CAD/Turtle/Full Sampleholder/Servo/SG90 - Micro Servo 9g - Tower Pro.4.SLDPRT
34.5 x 3.80 x 16.7 mm
