Thommie0208/TURTLE/CAD/Turtle/Frame 3 male 2.SLDPRT

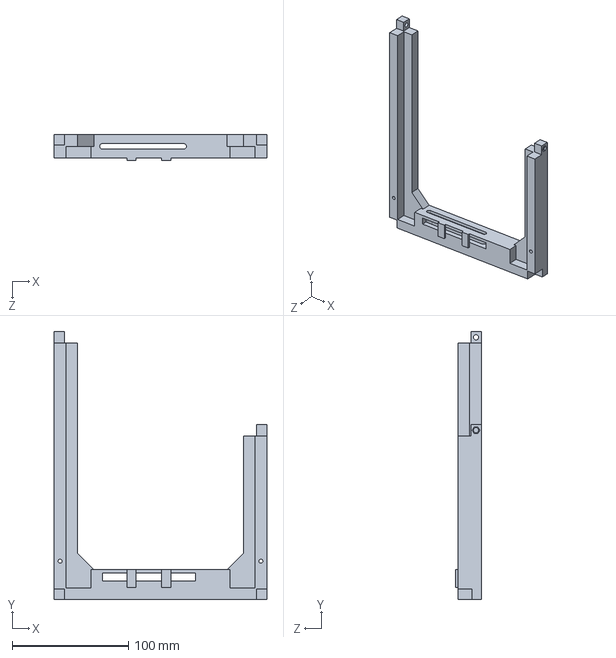
[picture p61: CAD file, 2026-06-19]
CAD/Turtle/Frame 3 male 2.SLDPRT
183.0 x 230.8 x 22.0 mm
