Thommie0208/TURTLE/CAD/Turtle/Full Sampleholder/Sampleholder Middle.SLDPRT

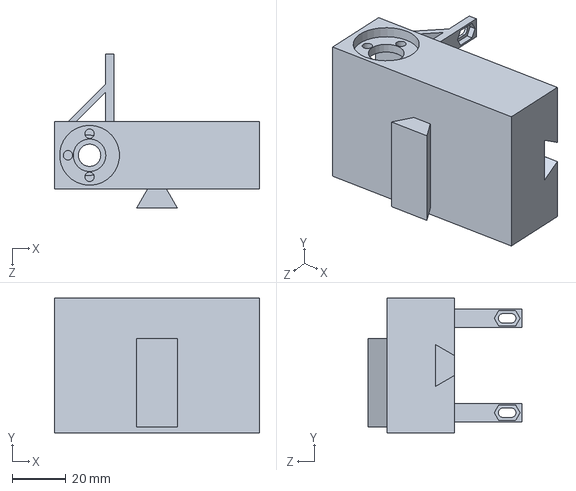
[picture p62: CAD file, 2026-06-19]
CAD/Turtle/Full Sampleholder/Sampleholder Middle.SLDPRT
76.0 x 50.0 x 57.0 mm
