Thommie0208/TURTLE/CAD/Turtle/Full Sampleholder/Servo/SG90 - Micro Servo 9g - Tower Pro.3.SLDPRT

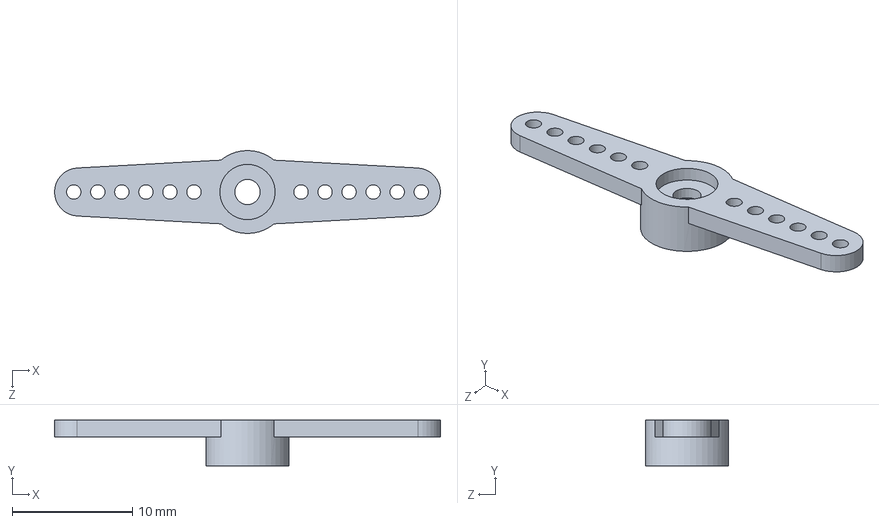
[picture p63: CAD file, 2026-06-15]
CAD/Turtle/Full Sampleholder/Servo/SG90 - Micro Servo 9g - Tower Pro.3.SLDPRT
32.1 x 3.80 x 6.90 mm
