Thommie0208/TURTLE/CAD/Turtle/Solidworks etc/N250L3P-Solidworks.SLDPRT

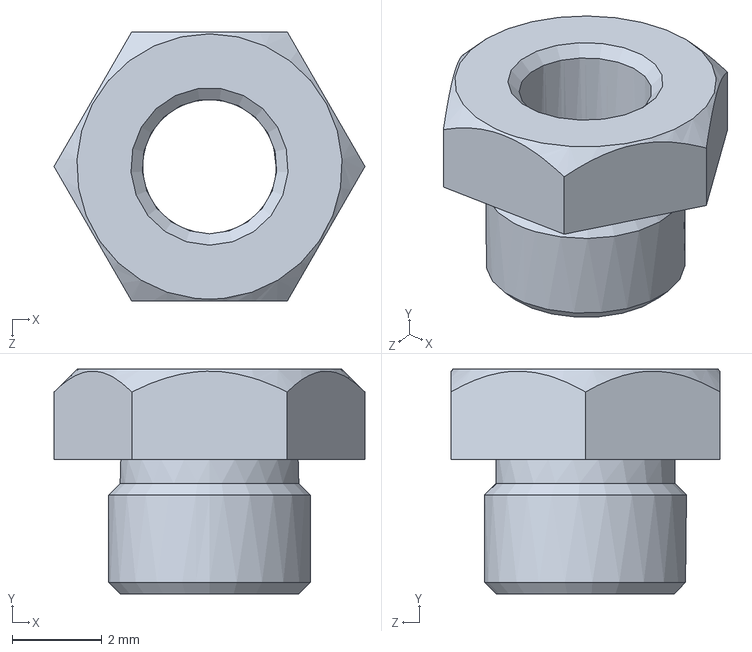
[picture p64: CAD file, 2026-06-19]
CAD/Turtle/Solidworks etc/N250L3P-Solidworks.SLDPRT
6.93 x 5.00 x 6.00 mm
