Thommie0208/TURTLE/CAD/Turtle/Full Sampleholder/MotorHolder.SLDPRT

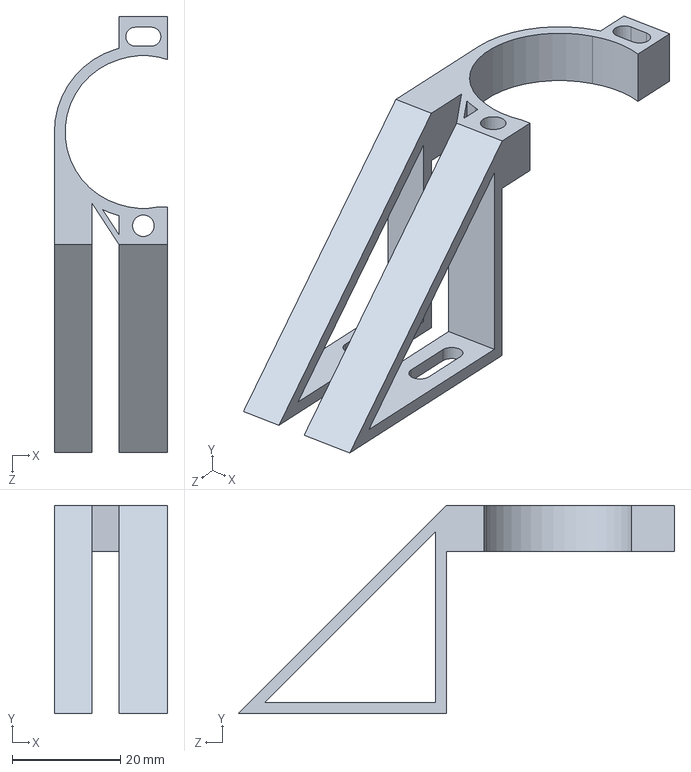
[picture p65: CAD file, 2026-06-19]
CAD/Turtle/Full Sampleholder/MotorHolder.SLDPRT
21.0 x 38.5 x 80.8 mm
