Thommie0208/TURTLE/CAD/Turtle/Solidworks etc/Glijlager.SLDPRT

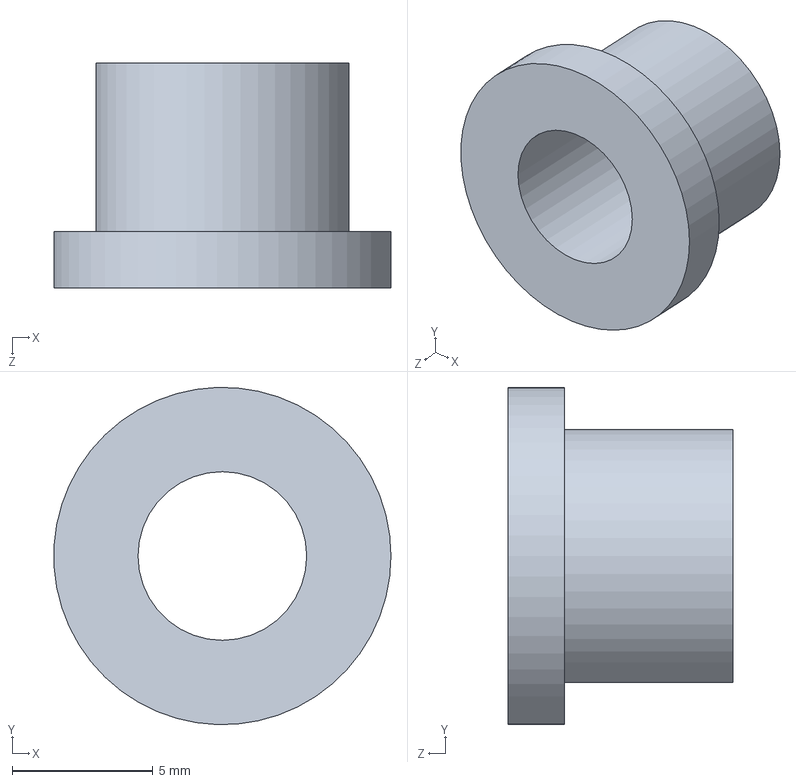
[picture p67: CAD file, 2026-06-19]
CAD/Turtle/Solidworks etc/Glijlager.SLDPRT
12.0 x 12.0 x 8.00 mm
