Thommie0208/TURTLE/CAD/Turtle/Frame 2.4.SLDPRT

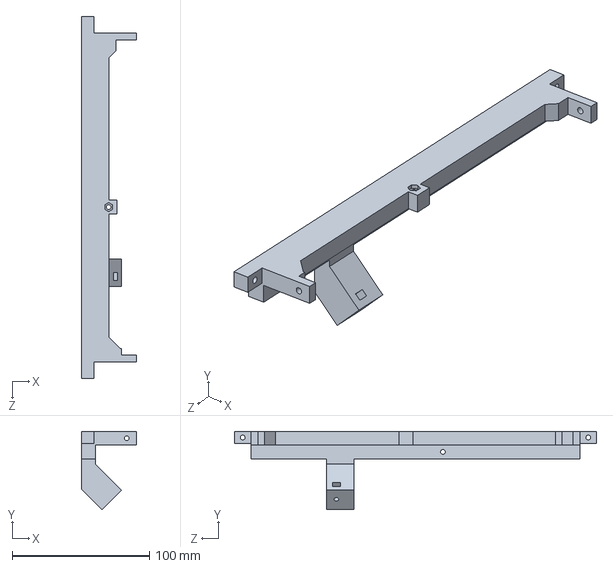
[picture p68: CAD file, 2026-06-19]
CAD/Turtle/Frame 2.4.SLDPRT
40.0 x 57.1 x 264.0 mm
