Thommie0208/TURTLE/CAD/Turtle/Full Sampleholder/Sampleholder Bottom 2.SLDPRT

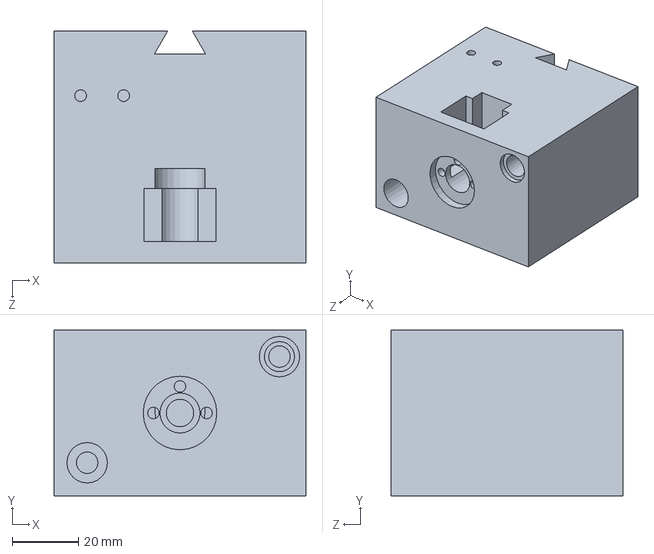
[picture p69: CAD file, 2026-06-19]
CAD/Turtle/Full Sampleholder/Sampleholder Bottom 2.SLDPRT
76.0 x 50.0 x 70.0 mm
