Thommie0208/TURTLE/CAD/Turtle/DIM testfile.SLDPRT

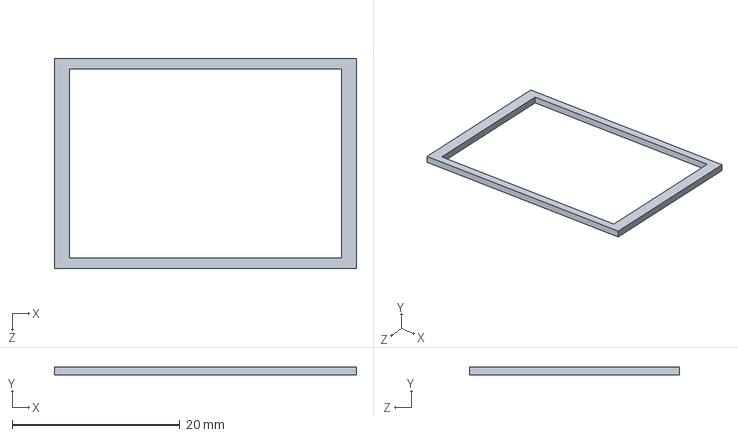
[picture p71: CAD file, 2026-06-19]
CAD/Turtle/DIM testfile.SLDPRT
36.0 x 1.00 x 25.0 mm
