Thommie0208/TURTLE/CAD/Turtle/Full Sampleholder/Collumator cover.SLDPRT

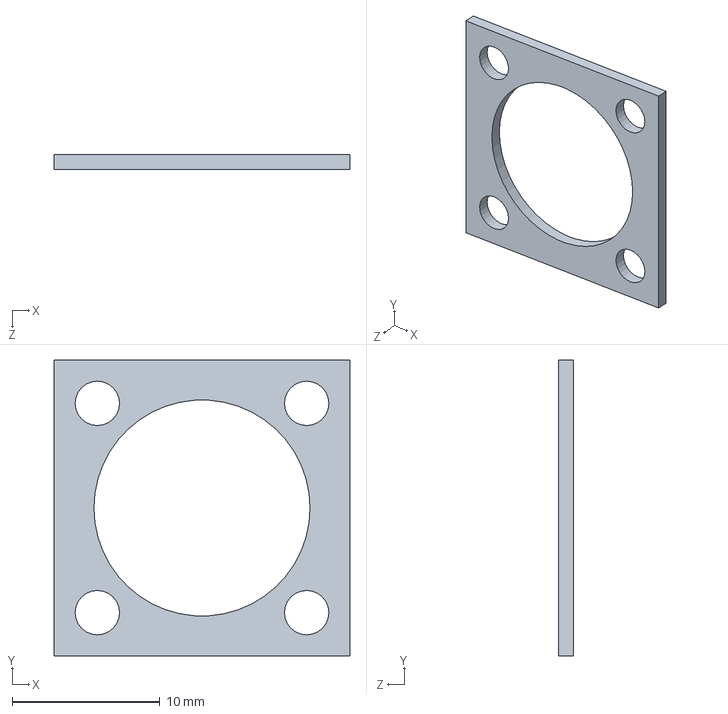
[picture p72: CAD file, 2026-06-15]
CAD/Turtle/Full Sampleholder/Collumator cover.SLDPRT
20.0 x 20.0 x 1.00 mm
