Thommie0208/TURTLE/CAD/Turtle/Full Sampleholder/Servoconnection.SLDPRT

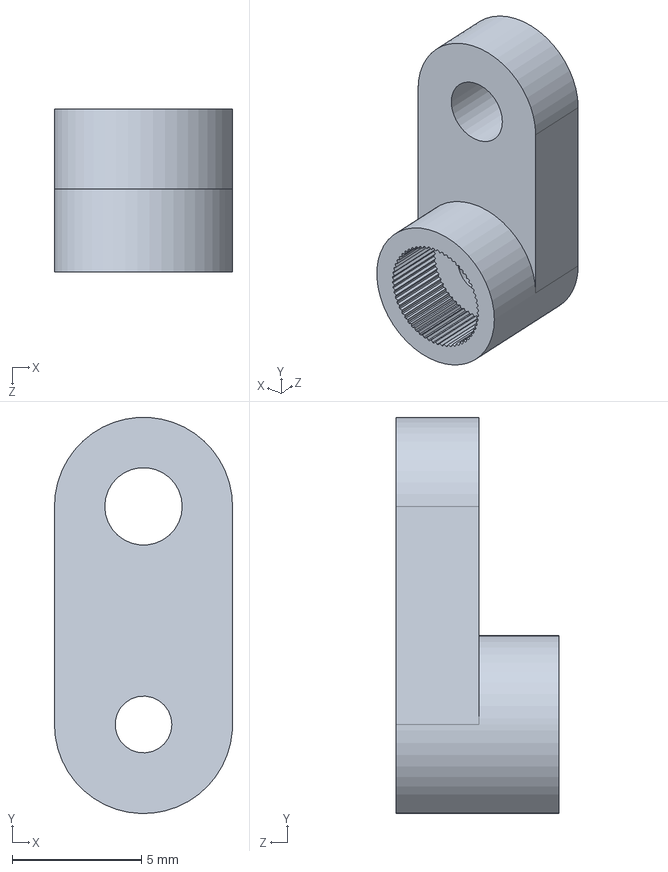
[picture p73: CAD file, 2026-06-15]
CAD/Turtle/Full Sampleholder/Servoconnection.SLDPRT
6.90 x 15.3 x 6.30 mm
