Thommie0208/TURTLE/CAD/Turtle/Full Sampleholder/SpindleBottom.SLDPRT

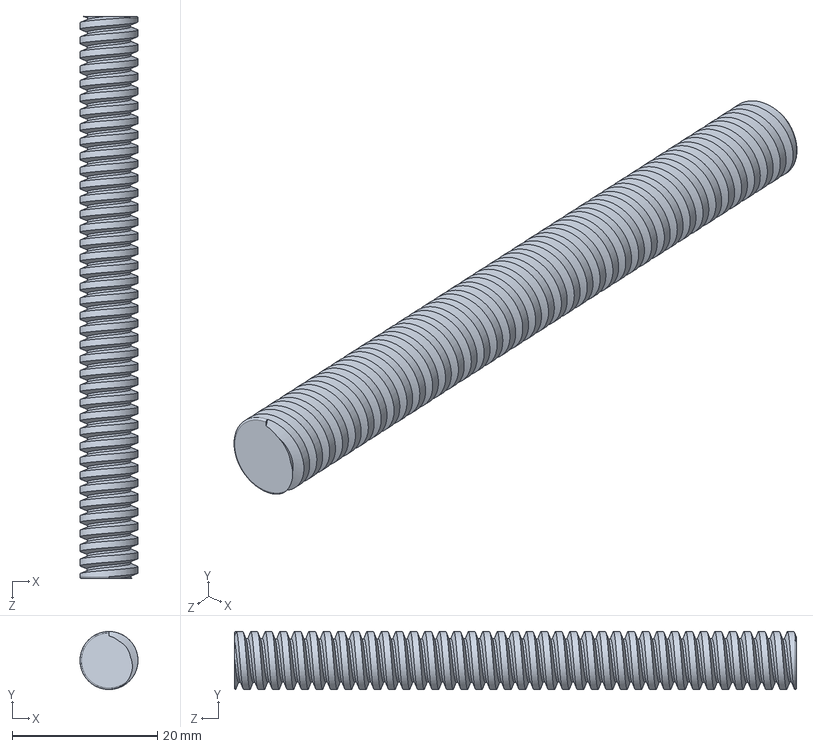
[picture p74: CAD file, 2026-06-15]
CAD/Turtle/Full Sampleholder/SpindleBottom.SLDPRT
8.00 x 8.00 x 77.5 mm
