Thommie0208/TURTLE/CAD/Turtle/Full Sampleholder/Darkfield mask switcher.SLDPRT

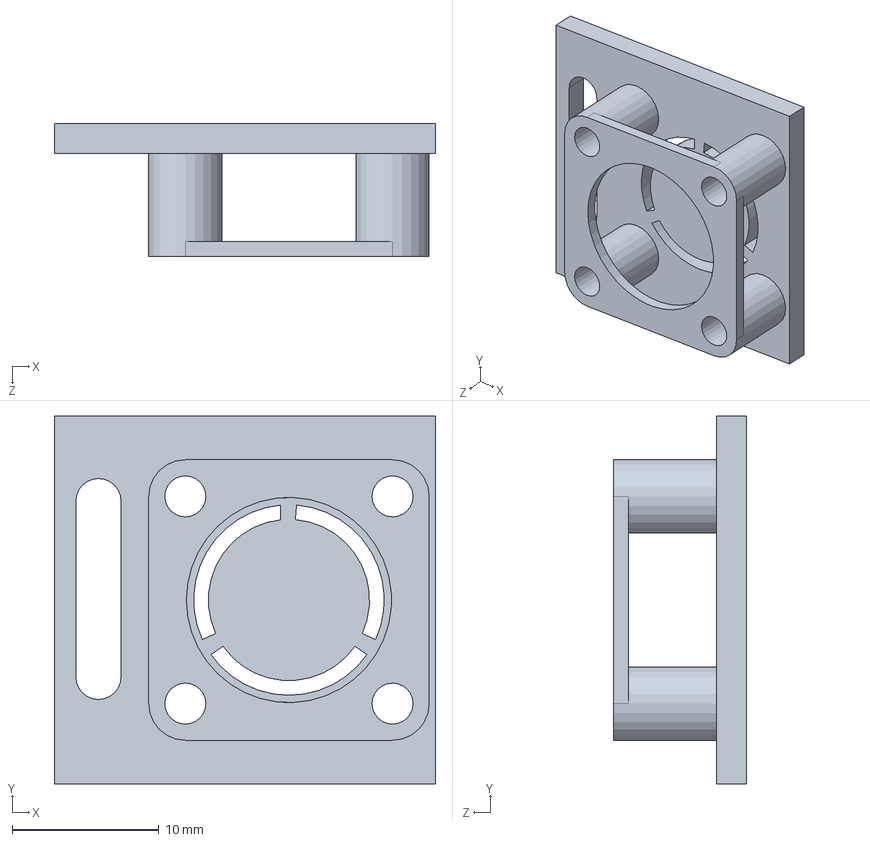
[picture p75: CAD file, 2026-06-15]
CAD/Turtle/Full Sampleholder/Darkfield mask switcher.SLDPRT
26.0 x 25.1 x 9.05 mm
