Thommie0208/TURTLE/CAD/Turtle/Extensions Thorlag Cage Plates.SLDPRT

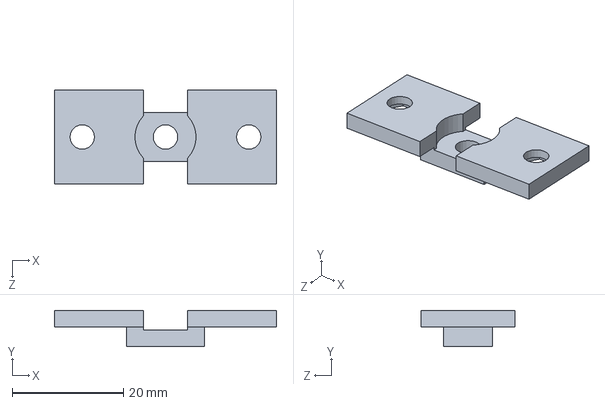
[picture p76: CAD file, 2026-06-19]
CAD/Turtle/Extensions Thorlag Cage Plates.SLDPRT
40.0 x 6.50 x 16.9 mm
