Thommie0208/TURTLE/CAD/Turtle/Full Sampleholder/6mm-as.SLDPRT

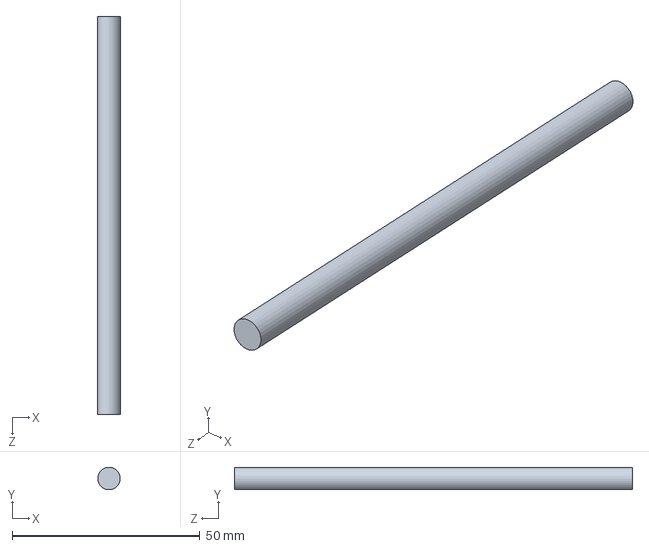
[picture p77: CAD file, 2026-06-15]
CAD/Turtle/Full Sampleholder/6mm-as.SLDPRT
6.00 x 5.97 x 106.0 mm
