Thommie0208/TURTLE/CAD/Turtle/Full Sampleholder/ACL1512U-A-Solidworks.sldprt

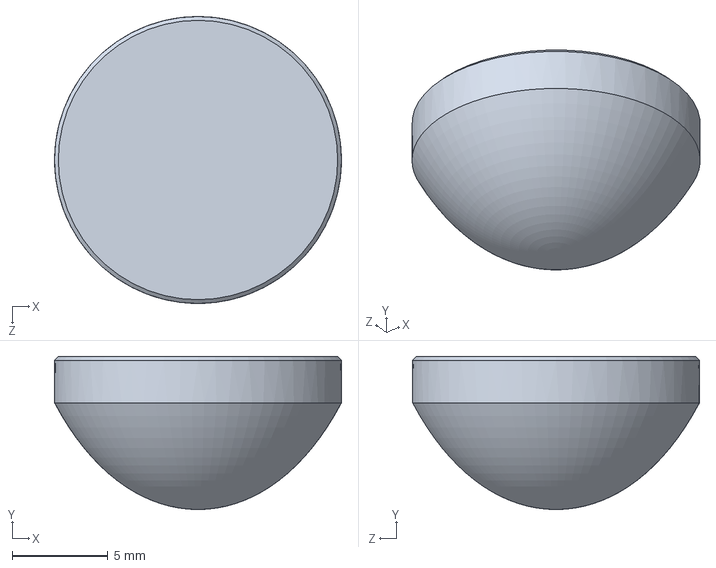
[picture p78: CAD file, 2026-06-15]
CAD/Turtle/Full Sampleholder/ACL1512U-A-Solidworks.sldprt
15.0 x 8.00 x 15.0 mm
