Thommie0208/TURTLE/CAD/Turtle/Rpi components/raspberry_pi_B_(RJ45).SLDPRT

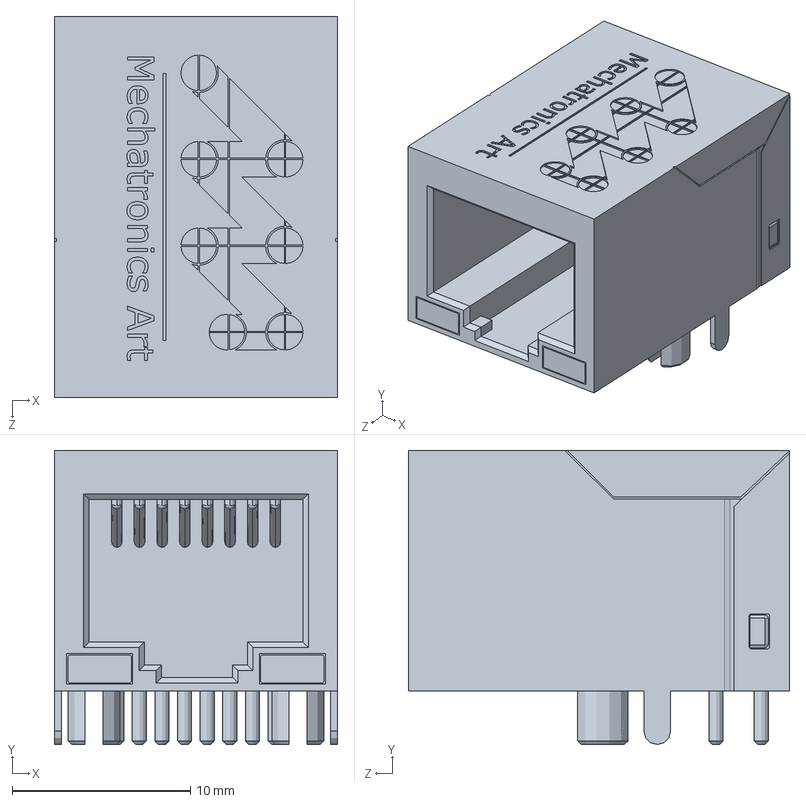
[picture p79: CAD file, 2026-06-15]
CAD/Turtle/Rpi components/raspberry_pi_B_(RJ45).SLDPRT
15.9 x 16.5 x 21.4 mm
