Thommie0208/TURTLE/CAD/Turtle/Full Sampleholder/Led Lens holder.SLDPRT

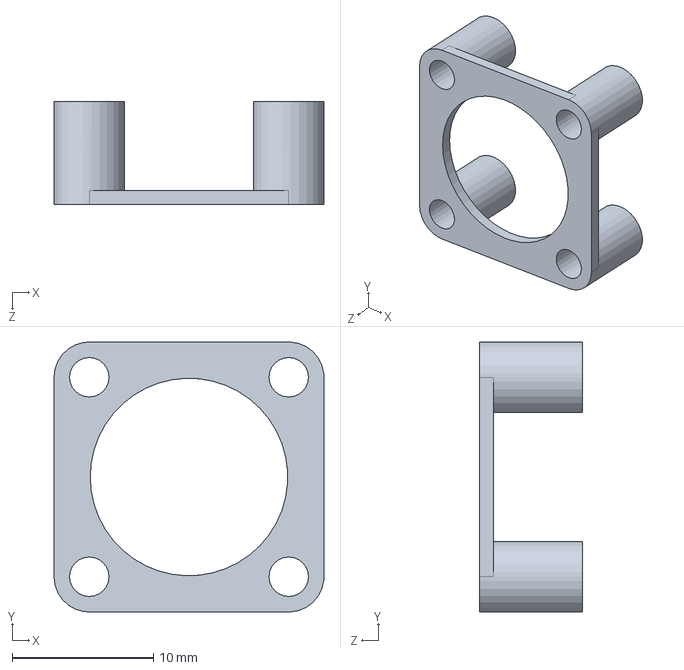
[picture p80: CAD file, 2026-06-15]
CAD/Turtle/Full Sampleholder/Led Lens holder.SLDPRT
19.1 x 19.1 x 7.30 mm
