Thommie0208/TURTLE/CAD/Turtle/Full Sampleholder/SpindleMiddle.SLDPRT

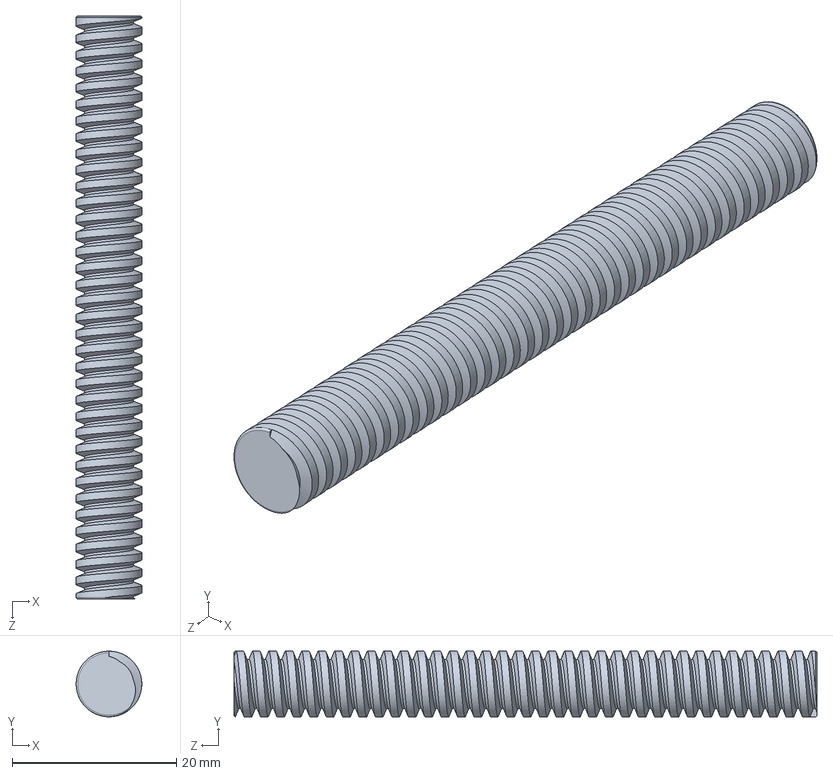
[picture p81: CAD file, 2026-06-15]
CAD/Turtle/Full Sampleholder/SpindleMiddle.SLDPRT
8.00 x 8.00 x 71.0 mm
