Thommie0208/TURTLE/CAD/Turtle/Full Sampleholder/Mask geleider.SLDPRT

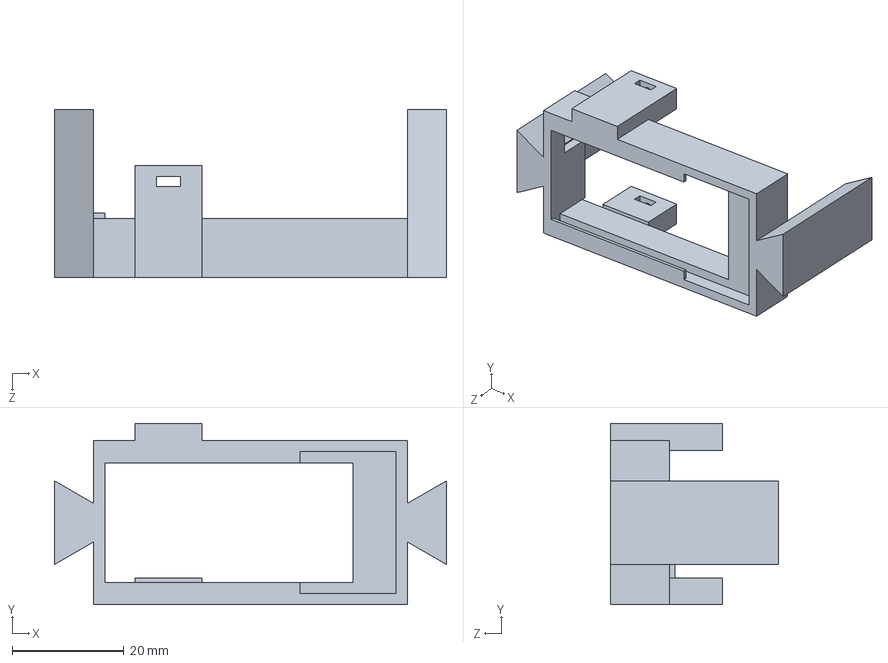
[picture p82: CAD file, 2026-06-15]
CAD/Turtle/Full Sampleholder/Mask geleider.SLDPRT
70.2 x 32.5 x 30.0 mm
