Thommie0208/TURTLE/CAD/Turtle/DIM Flexure Test6.1 stationary.SLDPRT

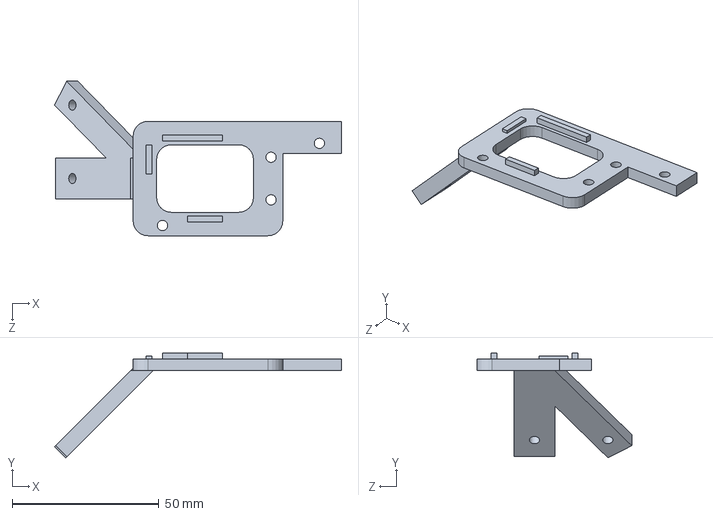
[picture p83: CAD file, 2026-06-19]
CAD/Turtle/DIM Flexure Test6.1 stationary.SLDPRT
97.8 x 35.7 x 52.7 mm
