Thommie0208/TURTLE/CAD/Turtle/Full Sampleholder/3d-printed motor-spindle.SLDPRT

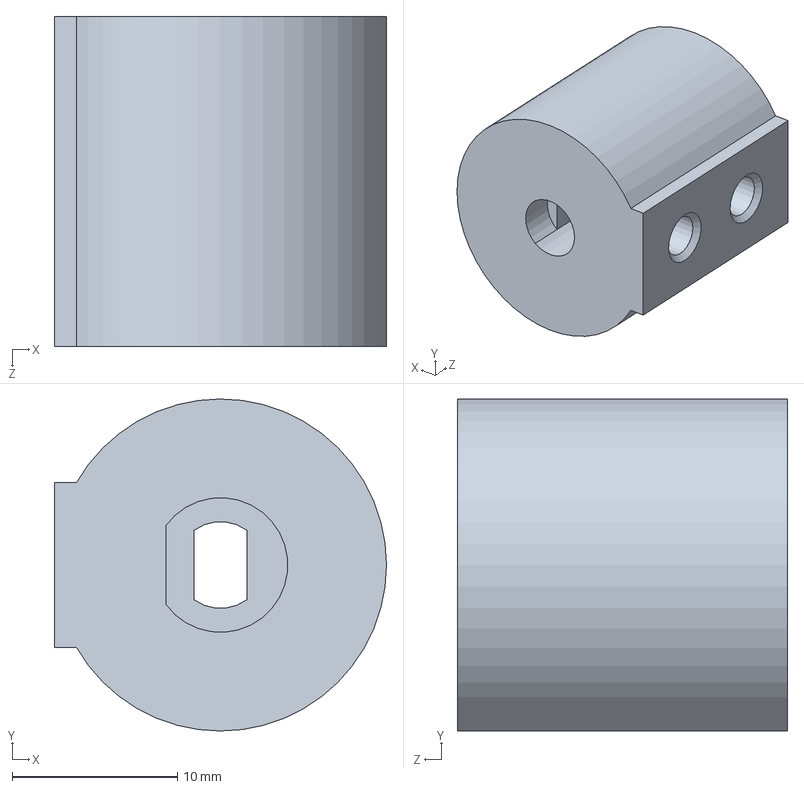
[picture p84: CAD file, 2026-06-15]
CAD/Turtle/Full Sampleholder/3d-printed motor-spindle.SLDPRT
20.1 x 20.1 x 20.0 mm
