Thommie0208/TURTLE/CAD/Turtle/Frame 3 female.SLDPRT

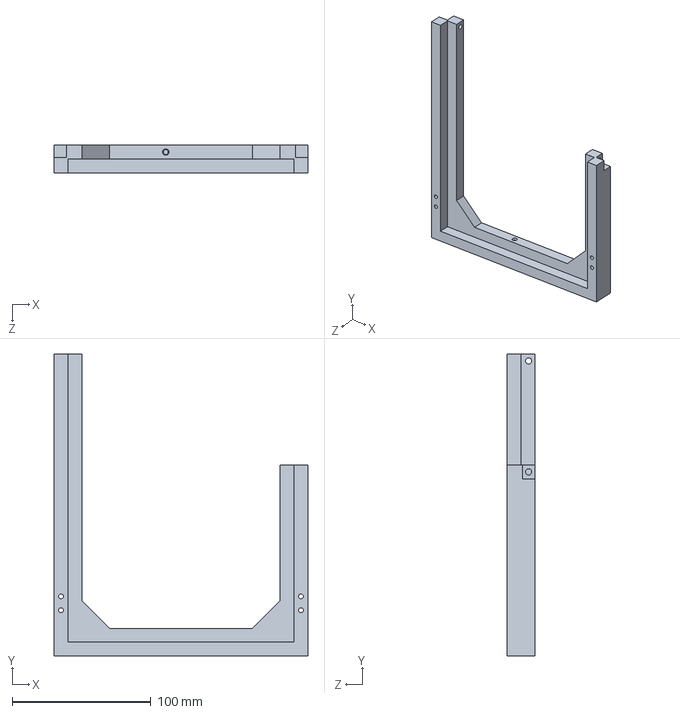
[picture p85: CAD file, 2026-06-19]
CAD/Turtle/Frame 3 female.SLDPRT
183.0 x 217.8 x 20.0 mm
