Thommie0208/TURTLE/CAD/Turtle/Full Sampleholder/SpindleTop.SLDPRT

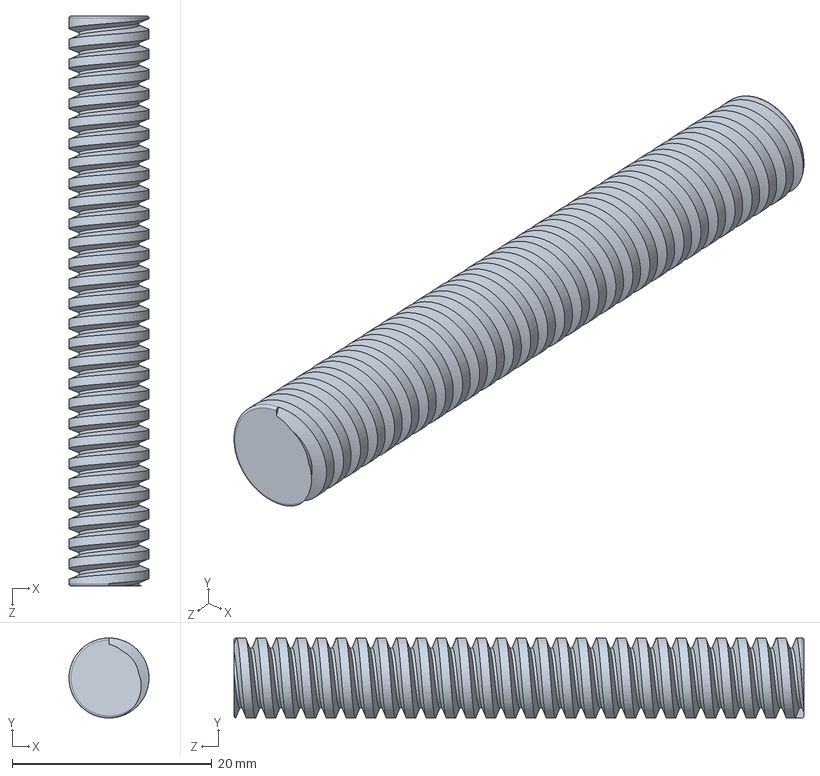
[picture p86: CAD file, 2026-06-15]
CAD/Turtle/Full Sampleholder/SpindleTop.SLDPRT
8.00 x 8.00 x 57.0 mm
