Thommie0208/TURTLE/CAD/Turtle/Frame 2.1.SLDPRT

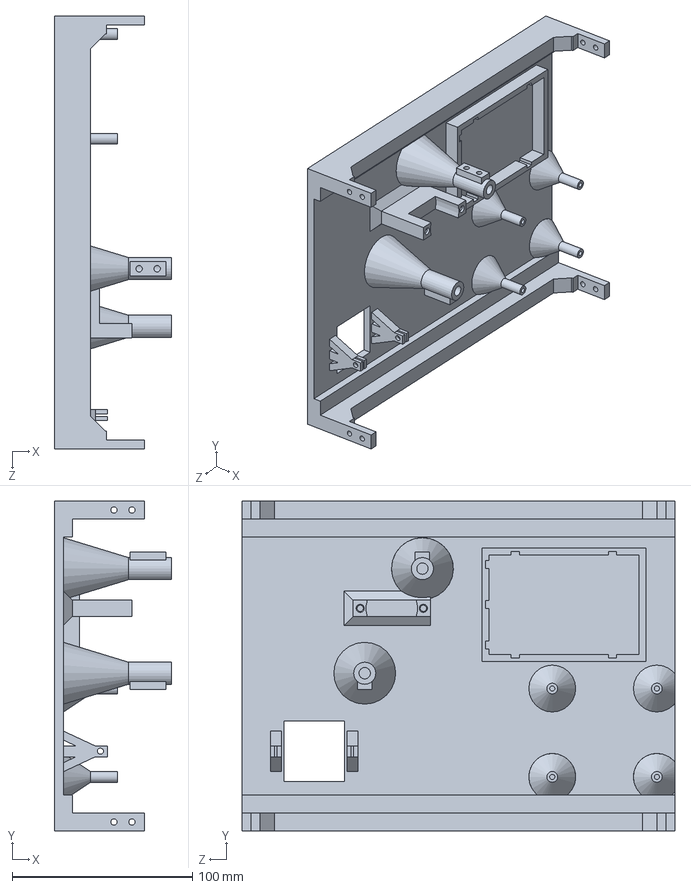
[picture p87: CAD file, 2026-06-19]
CAD/Turtle/Frame 2.1.SLDPRT
65.0 x 183.0 x 240.0 mm
