Thommie0208/TURTLE/CAD/Turtle/Full Sampleholder/3mmx6 pin.SLDPRT

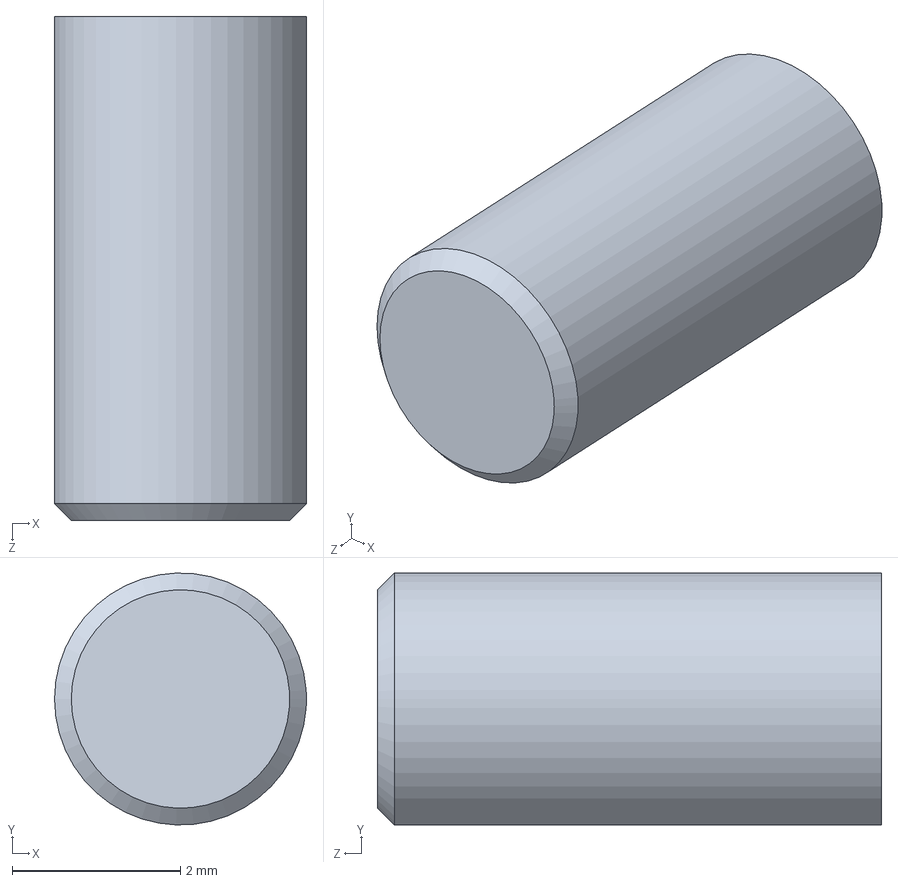
[picture p88: CAD file, 2026-06-15]
CAD/Turtle/Full Sampleholder/3mmx6 pin.SLDPRT
3.00 x 3.00 x 6.00 mm
