Thommie0208/TURTLE/CAD/Turtle/Frame 3 male 1.SLDPRT

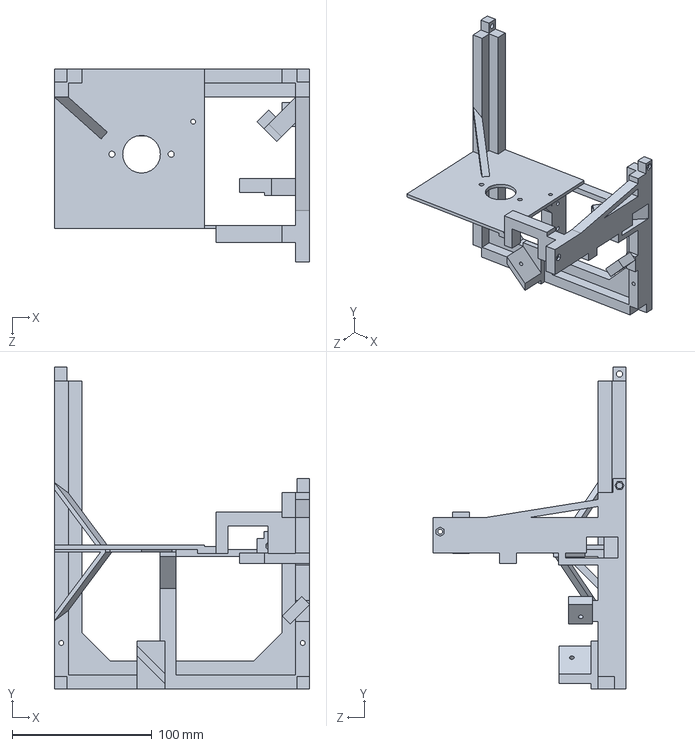
[picture p89: CAD file, 2026-06-19]
CAD/Turtle/Frame 3 male 1.SLDPRT
183.0 x 230.8 x 138.0 mm
