Thommie0208/TURTLE/CAD/Turtle/Frame to Filter Extension.SLDPRT

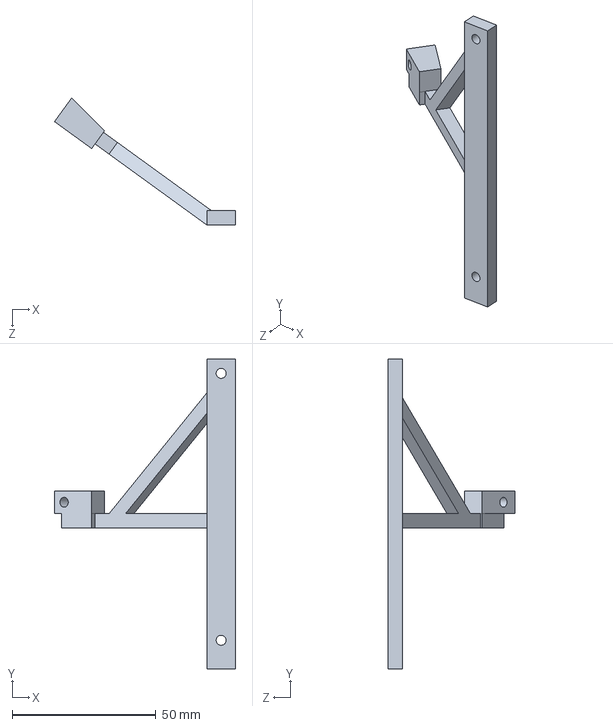
[picture p90: CAD file, 2026-06-19]
CAD/Turtle/Frame to Filter Extension.SLDPRT
63.1 x 108.0 x 44.2 mm
