Thommie0208/TURTLE/CAD/Turtle/BEP Frame 2.3.SLDPRT

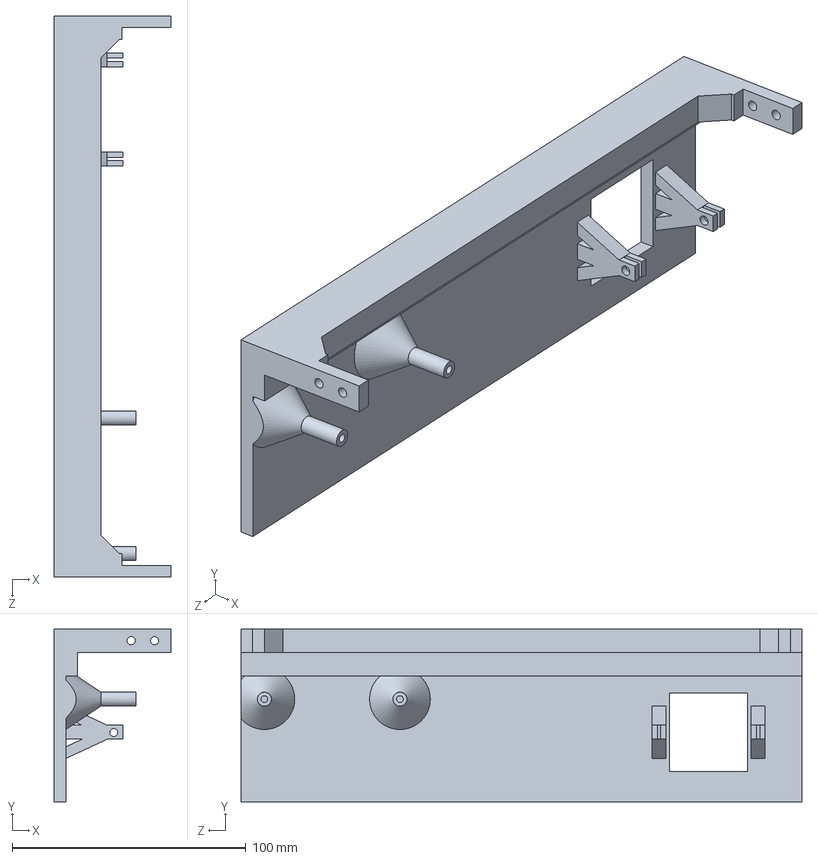
[picture p91: CAD file, 2026-06-15]
CAD/Turtle/BEP Frame 2.3.SLDPRT
50.0 x 74.0 x 240.0 mm
