Thommie0208/TURTLE/CAD/Turtle/28BYJ-48.SLDPRT

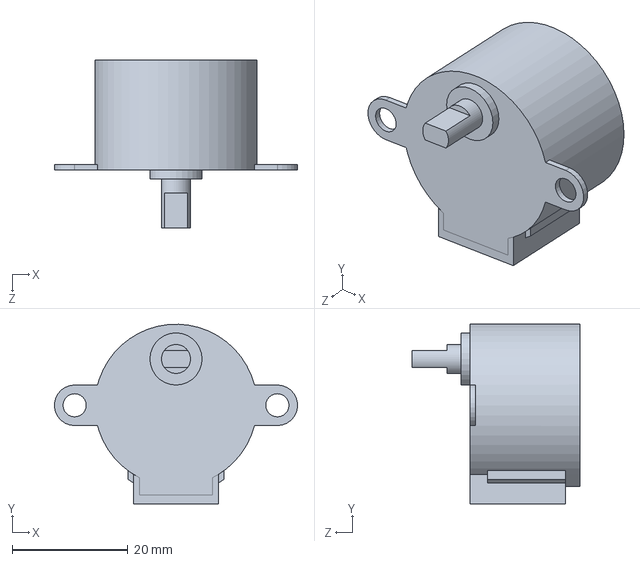
[picture p92: CAD file, 2026-06-15]
CAD/Turtle/28BYJ-48.SLDPRT
41.9 x 31.0 x 29.0 mm
