Thommie0208/TURTLE/CAD/Turtle/Rpi components/Raspberry Pi 349.sldprt

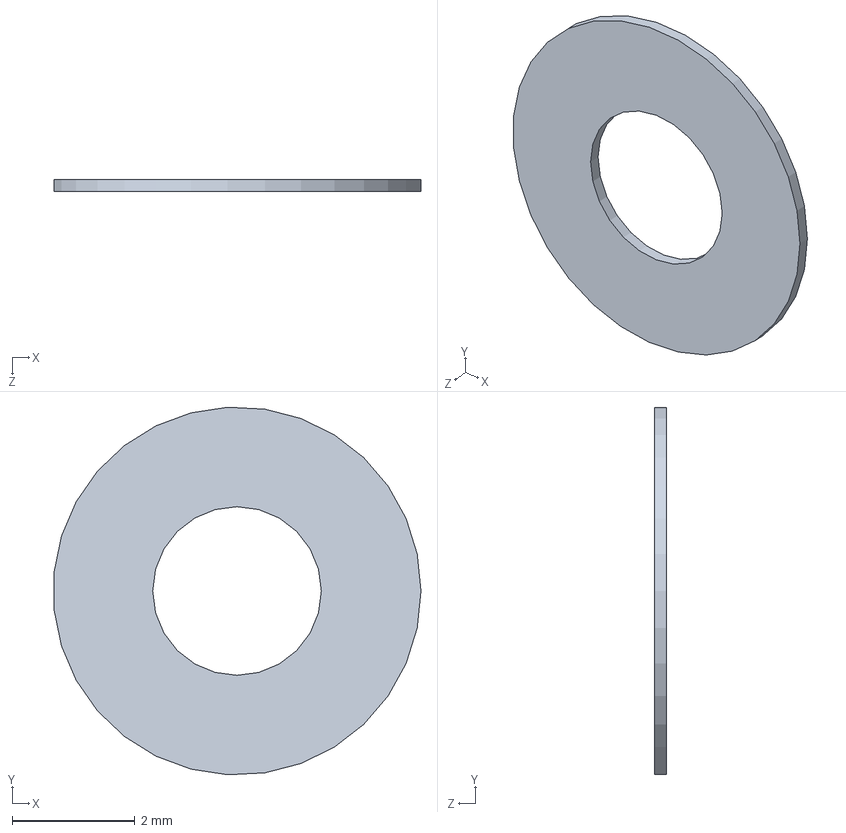
[picture p93: CAD file, 2026-06-15]
CAD/Turtle/Rpi components/Raspberry Pi 349.sldprt
5.98 x 5.99 x 0.2 mm
