Thommie0208/TURTLE/CAD/Turtle/Rpi components/Raspberry Pi 3141.SLDPRT

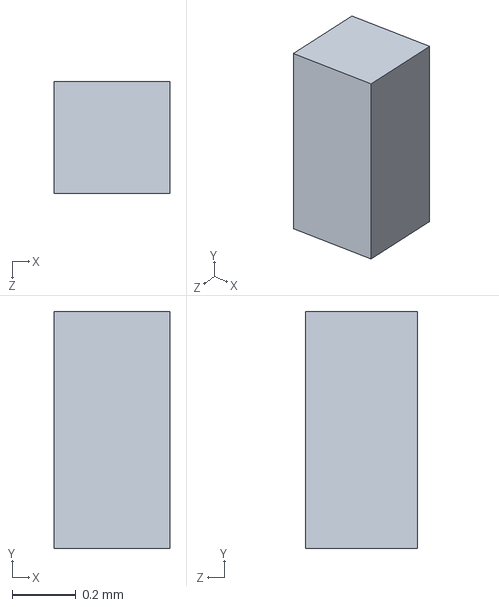
[picture p94: CAD file, 2026-06-15]
CAD/Turtle/Rpi components/Raspberry Pi 3141.SLDPRT
0.363 x 0.743 x 0.35 mm
