Thommie0208/TURTLE/CAD/Turtle/BEP Optical Path UC2 Cam.SLDPRT

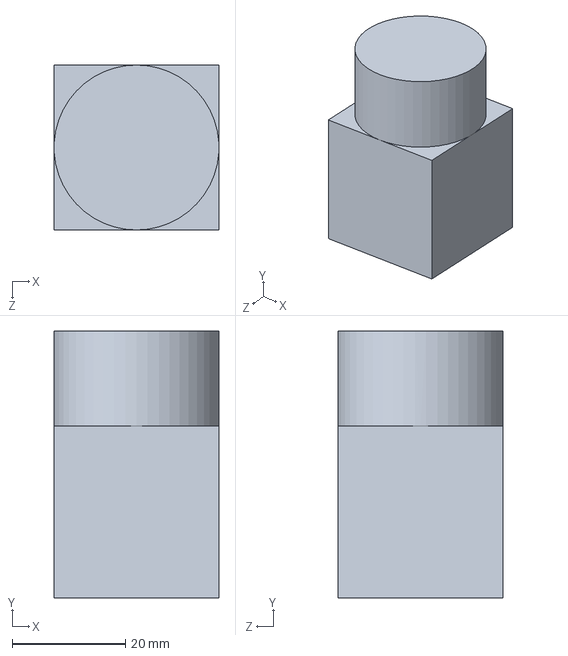
[picture p95: CAD file, 2026-06-15]
CAD/Turtle/BEP Optical Path UC2 Cam.SLDPRT
29.1 x 47.1 x 29.1 mm
