Thommie0208/TURTLE/CAD/Turtle/Breadboard 400.SLDPRT

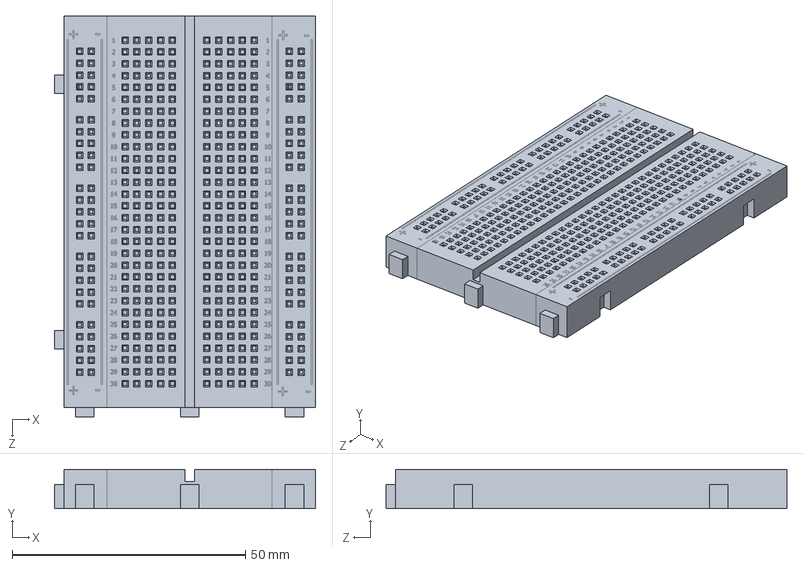
[picture p96: CAD file, 2026-06-15]
CAD/Turtle/Breadboard 400.SLDPRT
56.0 x 8.41 x 86.0 mm
