Thommie0208/TURTLE/CAD/Turtle/Front Face -  Press Pinn - Filter Mount.SLDPRT

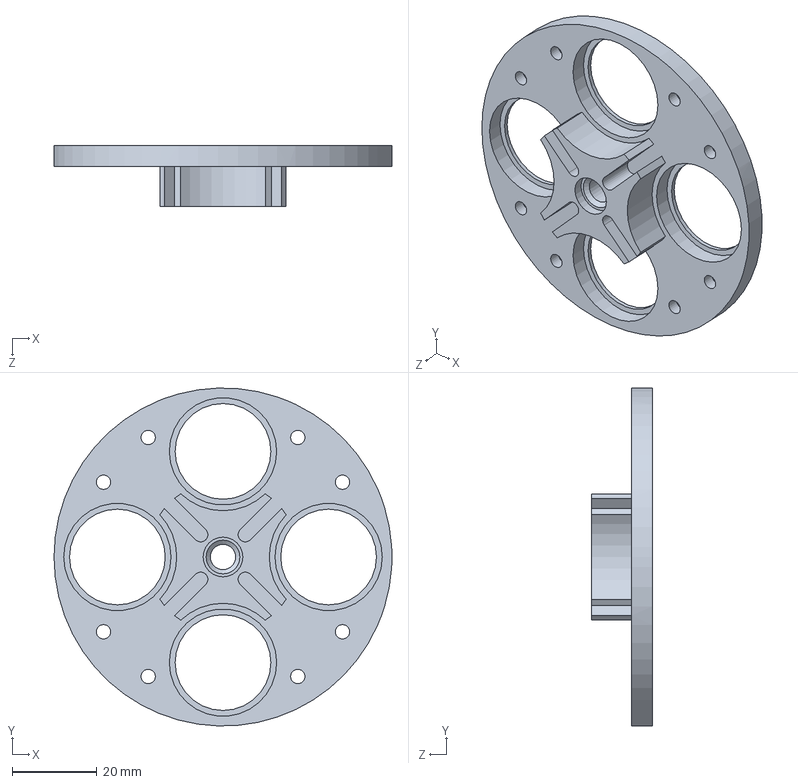
[picture p97: CAD file, 2026-06-15]
CAD/Turtle/Front Face - Press Pinn - Filter Mount.SLDPRT
80.0 x 80.0 x 14.5 mm
