Thommie0208/TURTLE/CAD/Turtle/Face Plate - Eliptical Mirror Mount - G.SLDPRT

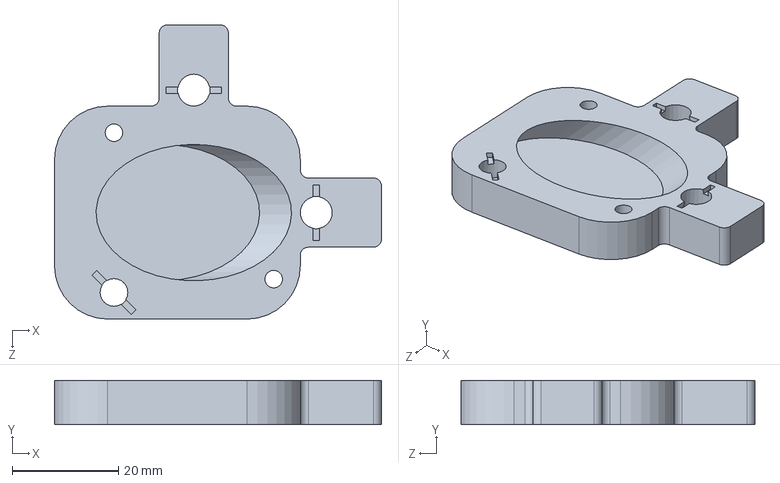
[picture p98: CAD file, 2026-06-15]
CAD/Turtle/Face Plate - Eliptical Mirror Mount - G.SLDPRT
61.4 x 8.30 x 55.2 mm
