Thommie0208/TURTLE/CAD/Turtle/Driving Wheel pressed pin- Filter Mount.SLDPRT

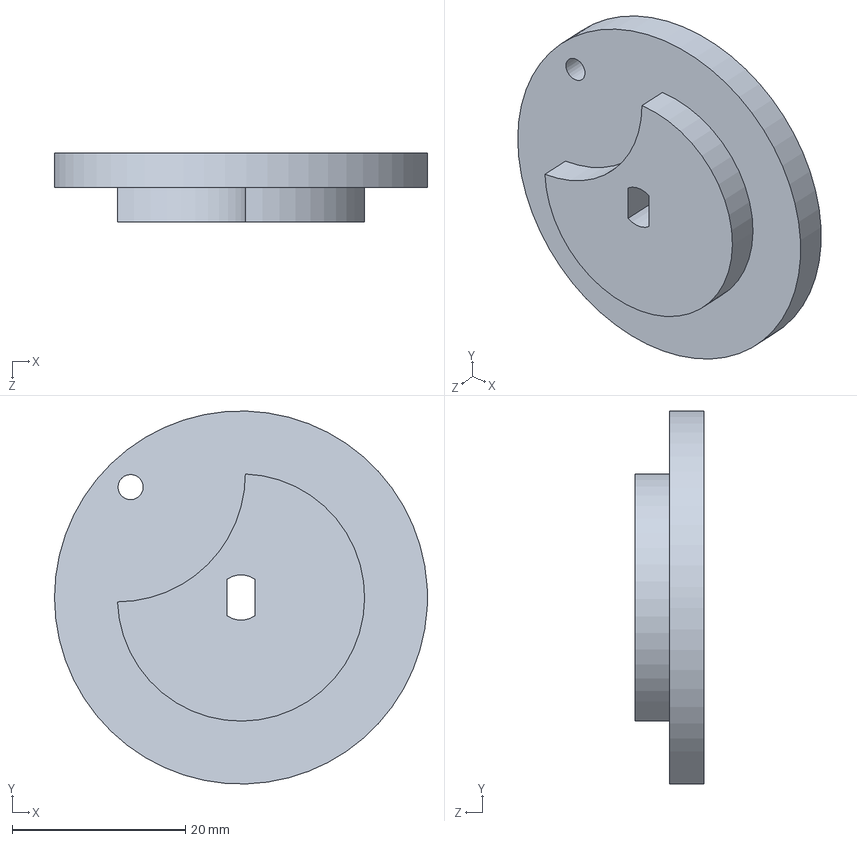
[picture p99: CAD file, 2026-06-15]
CAD/Turtle/Driving Wheel pressed pin- Filter Mount.SLDPRT
43.0 x 43.0 x 8.00 mm
