Thommie0208/TURTLE/CAD/Turtle/Rpi components/Raspberry Pi 3355.SLDPRT

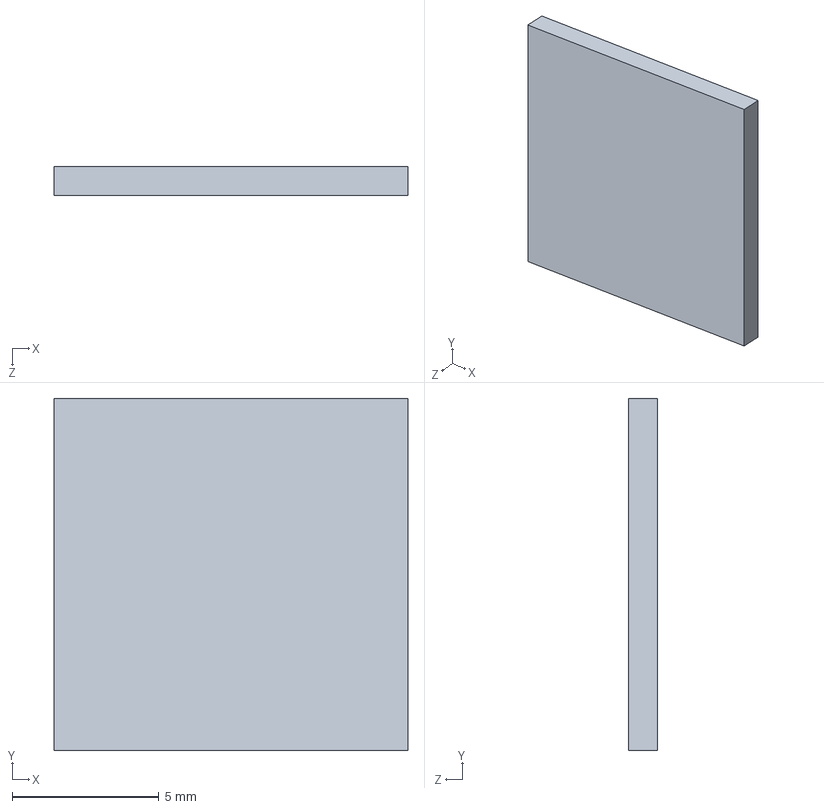
[picture p100: CAD file, 2026-06-15]
CAD/Turtle/Rpi components/Raspberry Pi 3355.SLDPRT
12.0 x 12.0 x 1.00 mm
