Thommie0208/TURTLE/CAD/Turtle/Rpi components/Raspberry Pi 312.SLDPRT

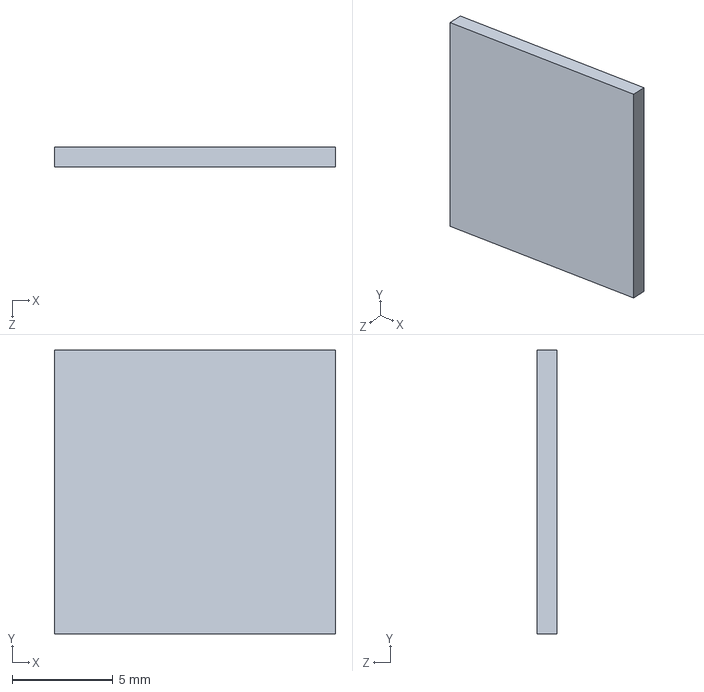
[picture p101: CAD file, 2026-06-15]
CAD/Turtle/Rpi components/Raspberry Pi 312.SLDPRT
14.0 x 14.1 x 1.00 mm
