Thommie0208/TURTLE/CAD/Turtle/Rpi components/molex_0473460001.sldprt

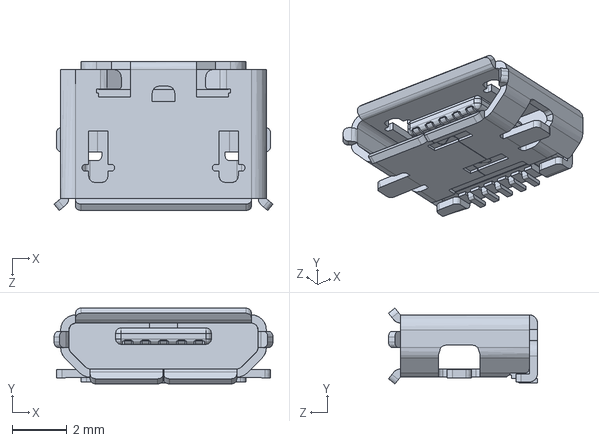
[picture p102: CAD file, 2026-06-15]
CAD/Turtle/Rpi components/molex_0473460001.sldprt
7.98 x 2.76 x 5.43 mm
