Thommie0208/TURTLE/CAD/Turtle/Full Sampleholder/Stage assembly.SLDASM

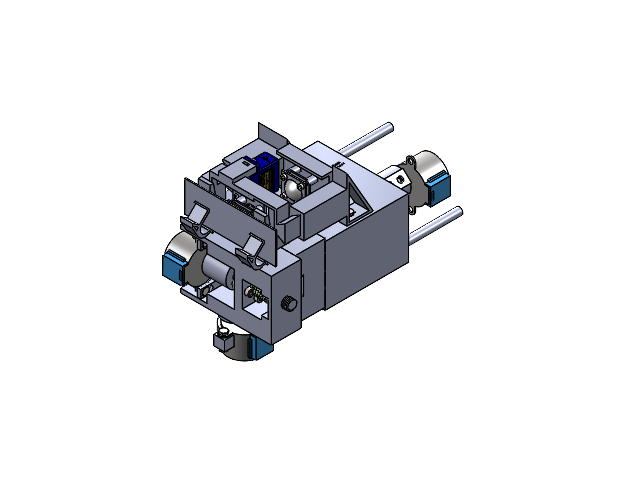
[picture p103: CAD file, 2026-06-19]
CAD/Turtle/Full Sampleholder/Stage assembly.SLDASM
Sampleholder Middle
Sampleholder Top
Darkfield mask switcher
Mask geleider
ACL1512U-A-Solidworks
Collumator cover x 2
28BYJ-48 x 3
3d-printed motor-spindle x 3
SpindleBottom
SpindleMiddle
SpindleTop
6mm-as x 2
SG90 - Micro Servo 9g - Tower Pro.1
SG90 - Micro Servo 9g - Tower Pro.6
Servoconnection
3mmx6 pin
BEP Thorlabs Condenser Lens ACL1512U
Sampleholder Bottom 2
MotorHolder
Led Lens holder
DarkfieldHolder
hex screw gradeab_iso1 x 8
socket set screw cup point_iso x 4
socket head cap screw_iso x 19
N250L3P-Solidworks
F3ES15-Solidworks
Glass slide
T8 Lead screw brass nut 1 x 3
T8 Lead screw brass nut 2 x 2
Spring D10.8 x 2
R1_24-006-005
Glijlager
hex nut style 1 gradeab_iso x 13
LED D5 - White
