Thommie0208/TURTLE/CAD/Turtle/Turtle.SLDASM

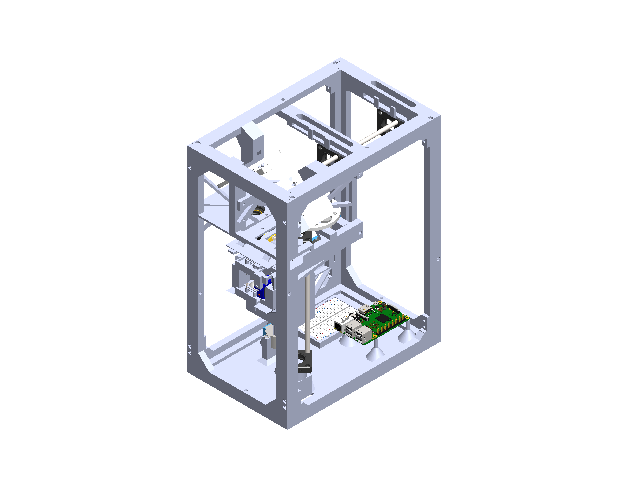
[picture p104: CAD file, 2026-06-19]
CAD/Turtle/Turtle.SLDASM
Frame 2.2
Frame 3 female x 2
Frame 3 male 1
Frame 3 male 2
Back Plate - Eliptical Mirror Mount x 2
5mm Steel Ball x 2
Face Plate - Eliptical Mirror Mount - G x 2
1x10mm Steel Pin x 12
BEP MM Precision screw x 4
Front Face - Press Pinn - Filter Mount
Thorlabs Cage Plate 30mm 0.35in x 5
Driving Wheel pressed pin- Filter Mount
28BYJ-48 x 4
Frame to Filter Extension
Thorlabs Rod 8in x 4
Thorlabs Rod 0.25in x 2
Thorlabs Rod Extension x 2
DIM Flexure Test6.1 stationary
DIM testfile
Frame 2.4
Dwarsbalk Thorlabs Nieuw
Thorlabs adapter SM1A3
Thorlabs Objective 10xPF
BEP Optical Path UC2 Cam
Extensions Thorlag Cage Plates x 2
Spring MM x 6
Sampleholder Middle
Sampleholder Top
Darkfield mask switcher
Mask geleider
ACL1512U-A-Solidworks
Collumator cover x 2
3d-printed motor-spindle x 3
SpindleBottom
SpindleMiddle
SpindleTop
6mm-as x 2
SG90 - Micro Servo 9g - Tower Pro.1
SG90 - Micro Servo 9g - Tower Pro.6
Servoconnection
3mmx6 pin
BEP Thorlabs Condenser Lens ACL1512U
Sampleholder Bottom 2
MotorHolder
Led Lens holder
DarkfieldHolder
hex screw gradeab_iso1 x 8
socket set screw cup point_iso x 4
socket head cap screw_iso x 19
N250L3P-Solidworks
F3ES15-Solidworks
Glass slide
T8 Lead screw brass nut 1 x 3
T8 Lead screw brass nut 2 x 2
Spring D10.8 x 2
R1_24-006-005
Glijlager
hex nut style 1 gradeab_iso x 13
LED D5 - White
Frame 2.1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
