Thommie0208/TURTLE/(list of files, cad)

Other CAD files:
CAD/Turtle/Hele assembly/Assem1.SLDASM
CAD/Turtle/Eliptical Mirror Mount - Ball Joint 1.SLDASM
CAD/Turtle/Hele assembly/Part4.SLDPRT
CAD/Turtle/Rpi components/Raspberry Pi 333.SLDPRT
CAD/Turtle/Hele assembly/Part2.SLDPRT
CAD/Turtle/Rpi components/Raspberry Pi 317.SLDPRT
CAD/Turtle/Rpi components/Raspberry Pi 3325.SLDPRT
CAD/Turtle/Solidworks etc/LED D5 - White.SLDPRT
CAD/Turtle/Rpi components/Raspberry Pi 3128.SLDPRT
CAD/Turtle/Rpi components/Raspberry Pi 394.SLDPRT
CAD/Turtle/Rpi components/Raspberry Pi 3292.SLDPRT
CAD/Turtle/Rpi components/Raspberry Pi 3354.SLDPRT
CAD/Turtle/Rpi components/Raspberry Pi 320.SLDPRT
CAD/Turtle/Rpi components/Raspberry Pi 3349.SLDPRT
CAD/Turtle/Rpi components/Raspberry Pi 3279.SLDPRT
CAD/Turtle/Rpi components/Raspberry Pi 3297.SLDPRT
CAD/Turtle/Rpi components/Raspberry Pi 3359.SLDPRT
CAD/Turtle/Rpi components/Raspberry Pi 3124.SLDPRT
CAD/Turtle/Rpi components/Raspberry Pi 36.SLDPRT
CAD/Turtle/Rpi components/Raspberry Pi 397.SLDPRT
CAD/Turtle/Rpi components/Raspberry Pi 3100.SLDPRT
CAD/Turtle/Rpi components/Raspberry Pi 3144.SLDPRT
CAD/Turtle/Rpi components/Raspberry Pi 3224.SLDPRT
CAD/Turtle/Rpi components/Raspberry Pi 3319.SLDPRT
CAD/Turtle/Rpi components/Raspberry Pi 3225.SLDPRT
CAD/Turtle/BEP Frame 2.1.SLDPRT
CAD/Turtle/Rpi components/Raspberry Pi 3277.SLDPRT
CAD/Turtle/Rpi components/Raspberry Pi 395.SLDPRT
CAD/Turtle/Rpi components/MOLEX_1040310811.sldprt
CAD/Turtle/Rpi components/Raspberry Pi 3174.SLDPRT
CAD/Turtle/Rpi components/PJ-322.sldprt
CAD/Turtle/Rpi components/Raspberry Pi 369.SLDPRT
CAD/Turtle/BEP Frame 3 male 1.SLDPRT
CAD/Turtle/Rpi components/Raspberry Pi 3342.SLDPRT
CAD/Turtle/BEP Frame 2.4.SLDPRT
CAD/Turtle/Rpi components/Raspberry Pi 337.SLDPRT
CAD/Turtle/BEP Frame 2.2.SLDPRT
CAD/Turtle/Rpi components/Raspberry Pi 3231.SLDPRT
CAD/Turtle/BEP Spring MM.SLDPRT
CAD/Turtle/BEP Frame 3 female.SLDPRT
CAD/Turtle/Rpi components/Raspberry Pi 3103.SLDPRT
CAD/Turtle/BEP Extensions Thorlag Cage Plates.SLDPRT
CAD/Turtle/Rpi components/Raspberry Pi 344.SLDPRT
CAD/Turtle/Rpi components/Raspberry Pi 3184.SLDPRT
CAD/Turtle/Rpi components/Raspberry Pi 3132.SLDPRT
CAD/Turtle/Rpi components/Raspberry Pi 365.SLDPRT
CAD/Turtle/BEP Frame to Filter Extension.SLDPRT
CAD/Turtle/Rpi components/Raspberry Pi 381.SLDPRT
CAD/Turtle/Rpi components/Raspberry Pi 3313.SLDPRT
CAD/Turtle/Rpi components/Raspberry Pi 3216.SLDPRT
CAD/Turtle/Rpi components/Raspberry Pi 378.SLDPRT
CAD/Turtle/BEP DIM testfile.SLDPRT
CAD/Turtle/Rpi components/Raspberry Pi 3175.SLDPRT
CAD/Turtle/Rpi components/Raspberry Pi 3230.SLDPRT
CAD/Turtle/BEP DIM Flexure Test6.1 stationary.SLDPRT
CAD/Turtle/Rpi components/Raspberry Pi 3135.SLDPRT
CAD/Turtle/BEP Frame 3 male 2.SLDPRT
CAD/Turtle/Rpi components/Raspberry Pi 3340.SLDPRT
CAD/Turtle/Rpi components/Raspberry Pi 3214.SLDPRT
CAD/Turtle/Rpi components/Raspberry Pi 3197.SLDPRT
CAD/Turtle/Rpi components/Raspberry Pi 318.SLDPRT
CAD/Turtle/Rpi components/Raspberry Pi 3283.SLDPRT
CAD/Turtle/Rpi components/Raspberry Pi 3168.SLDPRT
CAD/Turtle/Rpi components/Raspberry Pi 3235.SLDPRT
CAD/Turtle/Rpi components/Raspberry Pi 3203.SLDPRT
CAD/Turtle/Rpi components/Raspberry Pi 3139.SLDPRT
CAD/Turtle/Rpi components/Raspberry Pi 3289.SLDPRT
CAD/Turtle/Rpi components/Raspberry Pi 3334.SLDPRT
CAD/Turtle/Rpi components/Raspberry Pi 3105.SLDPRT
CAD/Turtle/Rpi components/Raspberry Pi 3152.SLDPRT
CAD/Turtle/Rpi components/Raspberry Pi 3209.SLDPRT
CAD/Turtle/Rpi components/Raspberry Pi 3167.SLDPRT
CAD/Turtle/Rpi components/Raspberry Pi 3315.SLDPRT
CAD/Turtle/Rpi components/Raspberry Pi 3350.SLDPRT
CAD/Turtle/Rpi components/Raspberry Pi 3169.SLDPRT
CAD/Turtle/Rpi components/Raspberry Pi 391.SLDPRT
CAD/Turtle/Rpi components/Raspberry Pi 3142.SLDPRT
CAD/Turtle/Rpi components/Raspberry Pi 34.SLDPRT
CAD/Turtle/Rpi components/Raspberry Pi 3266.SLDPRT
CAD/Turtle/Rpi components/Raspberry Pi 3220.SLDPRT
CAD/Turtle/Rpi components/Raspberry Pi 323.SLDPRT
CAD/Turtle/Rpi components/Raspberry Pi 3143.SLDPRT
CAD/Turtle/Rpi components/Raspberry Pi 3296.SLDPRT
CAD/Turtle/Rpi components/Raspberry Pi 3309.SLDPRT
CAD/Turtle/BEP Dwarsbalk Thorlabs Nieuw.SLDPRT
CAD/Turtle/BEP Solidworks/BEP MM Precision screw.SLDPRT
CAD/Turtle/BEP Solidworks/BEP Thorlabs Condenser Lens ACL1512U.SLDPRT
CAD/Turtle/BEP Thorlabs Cage Plate 30mm 0.35in.sldprt
CAD/Turtle/BEP Thorlabs Objective 10xPF.sldprt
CAD/Turtle/BEP Thorlabs Rod 0.25in.sldprt
CAD/Turtle/BEP Thorlabs Rod 8in.sldprt
CAD/Turtle/BEP Thorlabs Rod Extension.sldprt
CAD/Turtle/BEP Thorlabs adapter SM1A3.sldprt
CAD/Turtle/Dwarsbalk Thorlabs Nieuw.SLDPRT
CAD/Turtle/Rpi components/HANRUN2_HR911105A.sldprt
CAD/Turtle/Rpi components/MOLEX_672983090.sldprt
CAD/Turtle/Rpi components/Raspberry Pi 31.SLDPRT
CAD/Turtle/Rpi components/Raspberry Pi 310.SLDPRT
CAD/Turtle/Rpi components/Raspberry Pi 3101.SLDPRT
CAD/Turtle/Rpi components/Raspberry Pi 3102.SLDPRT
CAD/Turtle/Rpi components/Raspberry Pi 3104.SLDPRT
CAD/Turtle/Rpi components/Raspberry Pi 3106.SLDPRT
CAD/Turtle/Rpi components/Raspberry Pi 3107.SLDPRT
CAD/Turtle/Rpi components/Raspberry Pi 3108.SLDPRT
CAD/Turtle/Rpi components/Raspberry Pi 3109.SLDPRT
CAD/Turtle/Rpi components/Raspberry Pi 311.SLDPRT
CAD/Turtle/Rpi components/Raspberry Pi 3110.SLDPRT
CAD/Turtle/Rpi components/Raspberry Pi 3111.SLDPRT
CAD/Turtle/Rpi components/Raspberry Pi 3112.SLDPRT
CAD/Turtle/Rpi components/Raspberry Pi 3113.SLDPRT
CAD/Turtle/Rpi components/Raspberry Pi 3114.SLDPRT
CAD/Turtle/Rpi components/Raspberry Pi 3115.SLDPRT
CAD/Turtle/Rpi components/Raspberry Pi 3116.SLDPRT
CAD/Turtle/Rpi components/Raspberry Pi 3117.SLDPRT
CAD/Turtle/Rpi components/Raspberry Pi 3118.SLDPRT
CAD/Turtle/Rpi components/Raspberry Pi 3119.SLDPRT
CAD/Turtle/Rpi components/Raspberry Pi 3120.SLDPRT
CAD/Turtle/Rpi components/Raspberry Pi 3121.SLDPRT
CAD/Turtle/Rpi components/Raspberry Pi 3122.SLDPRT
CAD/Turtle/Rpi components/Raspberry Pi 3123.SLDPRT
CAD/Turtle/Rpi components/Raspberry Pi 3125.SLDPRT
CAD/Turtle/Rpi components/Raspberry Pi 3126.SLDPRT
CAD/Turtle/Rpi components/Raspberry Pi 3127.SLDPRT
CAD/Turtle/Rpi components/Raspberry Pi 3129.SLDPRT
CAD/Turtle/Rpi components/Raspberry Pi 313.SLDPRT
CAD/Turtle/Rpi components/Raspberry Pi 3130.SLDPRT
CAD/Turtle/Rpi components/Raspberry Pi 3131.SLDPRT
CAD/Turtle/Rpi components/Raspberry Pi 3133.SLDPRT
CAD/Turtle/Rpi components/Raspberry Pi 3134.SLDPRT
CAD/Turtle/Rpi components/Raspberry Pi 3137.SLDPRT
CAD/Turtle/Rpi components/Raspberry Pi 3138.SLDPRT
CAD/Turtle/Rpi components/Raspberry Pi 314.SLDPRT
CAD/Turtle/Rpi components/Raspberry Pi 3140.SLDPRT
CAD/Turtle/Rpi components/Raspberry Pi 3146.SLDPRT
CAD/Turtle/Rpi components/Raspberry Pi 3147.SLDPRT
CAD/Turtle/Rpi components/Raspberry Pi 3149.SLDPRT
CAD/Turtle/Rpi components/Raspberry Pi 315.SLDPRT
CAD/Turtle/Rpi components/Raspberry Pi 3150.SLDPRT
CAD/Turtle/Rpi components/Raspberry Pi 3151.SLDPRT
CAD/Turtle/Rpi components/Raspberry Pi 3153.SLDPRT
CAD/Turtle/Rpi components/Raspberry Pi 3154.SLDPRT
CAD/Turtle/Rpi components/Raspberry Pi 3155.SLDPRT
CAD/Turtle/Rpi components/Raspberry Pi 3156.SLDPRT
CAD/Turtle/Rpi components/Raspberry Pi 3157.SLDPRT
CAD/Turtle/Rpi components/Raspberry Pi 3158.SLDPRT
CAD/Turtle/Rpi components/Raspberry Pi 3159.SLDPRT
CAD/Turtle/Rpi components/Raspberry Pi 316.SLDPRT
CAD/Turtle/Rpi components/Raspberry Pi 3160.SLDPRT
CAD/Turtle/Rpi components/Raspberry Pi 3161.SLDPRT
CAD/Turtle/Rpi components/Raspberry Pi 3162.SLDPRT
CAD/Turtle/Rpi components/Raspberry Pi 3163.SLDPRT
CAD/Turtle/Rpi components/Raspberry Pi 3164.SLDPRT
CAD/Turtle/Rpi components/Raspberry Pi 3165.SLDPRT
CAD/Turtle/Rpi components/Raspberry Pi 3166.SLDPRT
CAD/Turtle/Rpi components/Raspberry Pi 3170.SLDPRT
CAD/Turtle/Rpi components/Raspberry Pi 3171.SLDPRT
CAD/Turtle/Rpi components/Raspberry Pi 3172.SLDPRT
CAD/Turtle/Rpi components/Raspberry Pi 3173.SLDPRT
CAD/Turtle/Rpi components/Raspberry Pi 3176.SLDPRT
CAD/Turtle/Rpi components/Raspberry Pi 3177.SLDPRT
CAD/Turtle/Rpi components/Raspberry Pi 3178.SLDPRT
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
