Thommie0208/TURTLE/Calculations/USAF test map/Sample 1/Group 8 Element 5 (hor).csv

Distance_(pixels) | Gray_Value
0 | 151
1 | 104
2 | 78
3 | 71
4 | 89
5 | 131
6 | 139
7 | 103
8 | 78
9 | 73
10 | 96
11 | 135
12 | 131
13 | 93
14 | 70
15 | 66
16 | 92
17 | 136
18 | 168
