Thommie0208/TURTLE/Calculations/USAF test map/Sample 1/Group 8 Element 5 (vert).csv

Distance_(pixels) | Gray_Value
0 | 121.7656
1 | 81.2415
2 | 59.4412
3 | 62.9511
4 | 86.5437
5 | 111.5076
6 | 111.0956
7 | 86.0547
8 | 67.6999
9 | 76.2169
10 | 101.5129
11 | 120.8773
12 | 115.0809
13 | 87.4432
14 | 71.6360
15 | 85.8419
16 | 116.2845
17 | 149.1250
