Thommie0208/TURTLE/Calculations/USAF test map/Sample 1/Group 8 Element 6 (hor).csv

Distance_(pixels) | Gray_Value
0 | 165.000
1 | 171.773
2 | 178.364
3 | 169.205
4 | 135.977
5 | 97.875
6 | 78.818
7 | 81.989
8 | 105.045
9 | 122.250
10 | 107.409
11 | 85.750
12 | 79.091
13 | 90.739
14 | 115.545
15 | 113.784
16 | 89.250
17 | 75.057
18 | 78.273
19 | 109.136
20 | 153.409
21 | 183.011
22 | 183.500
