Thommie0208/TURTLE/Calculations/USAF test map/Sample 1/Group 8 Element 6 (vert).csv

Distance_(pixels) | Gray_Value
0 | 168.1944
1 | 152.0132
2 | 123.9211
3 | 92.0336
4 | 74.4035
5 | 83.9664
6 | 108.4766
7 | 117.8947
8 | 101.3421
9 | 78.2441
10 | 77.5219
11 | 98.9298
12 | 112.5292
13 | 101.4518
14 | 80.0994
15 | 72.8772
16 | 93.0482
17 | 131.7880
18 | 162.9488
19 | 172.0000
