Thommie0208/TURTLE/Calculations/USAF test map/Sample 1/Chart 1 (rotated).tif

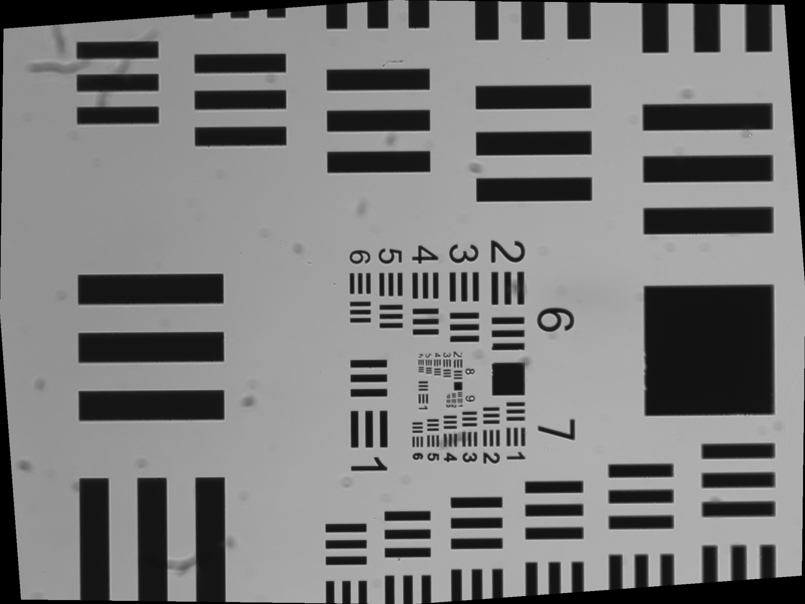
Calculations/USAF test map/Sample 1/Chart 1 (rotated).tif
