Thommie0208/TURTLE/Calculations/USAF test map/Sample 1/Group 6 Element 1 (hor).tif

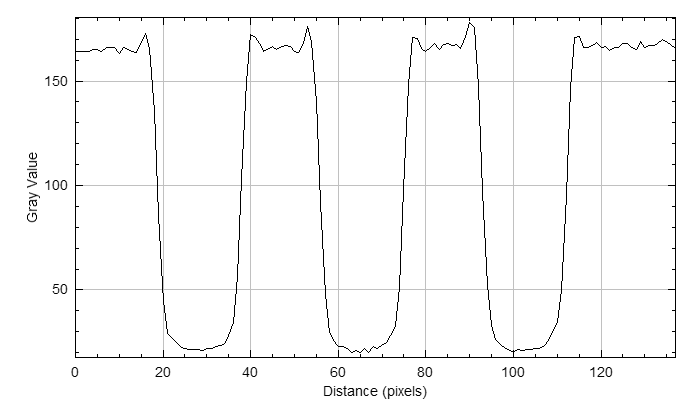
Calculations/USAF test map/Sample 1/Group 6 Element 1 (hor).tif
