Thommie0208/TURTLE/Calculations/USAF test map/Sample 1/Group 9 Element 1 (vert) - Resovable Y.tif

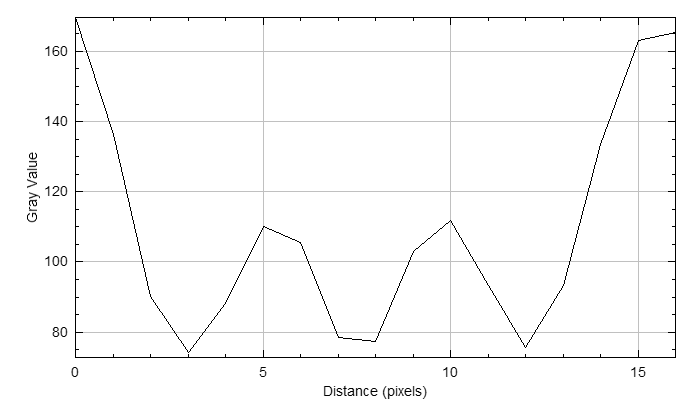
Calculations/USAF test map/Sample 1/Group 9 Element 1 (vert) - Resovable Y.tif
