Thommie0208/TURTLE/Calculations/USAF test map/Sample 2/Chart 2 (rotated).tif

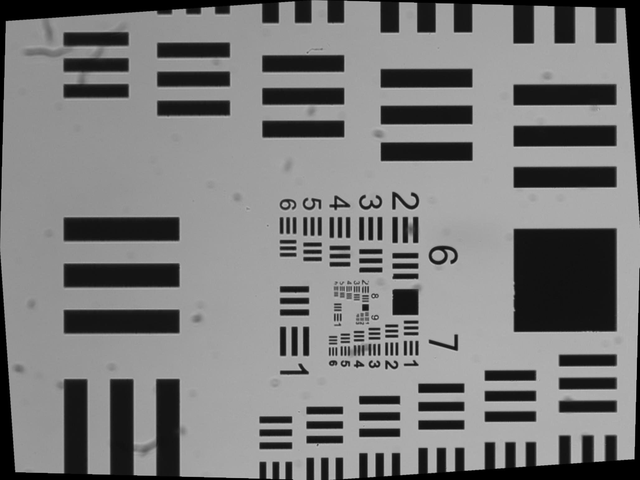
Calculations/USAF test map/Sample 2/Chart 2 (rotated).tif
