Thommie0208/TURTLE/Calculations/USAF test map/Sample 2/Group 8 Element 5 (vert).tif

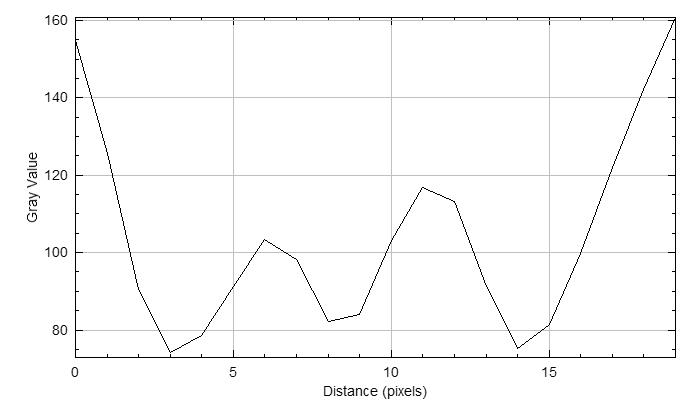
Calculations/USAF test map/Sample 2/Group 8 Element 5 (vert).tif
