Thommie0208/TURTLE/Calculations/USAF test map/Sample 3/Chart 3 (rotated).tif

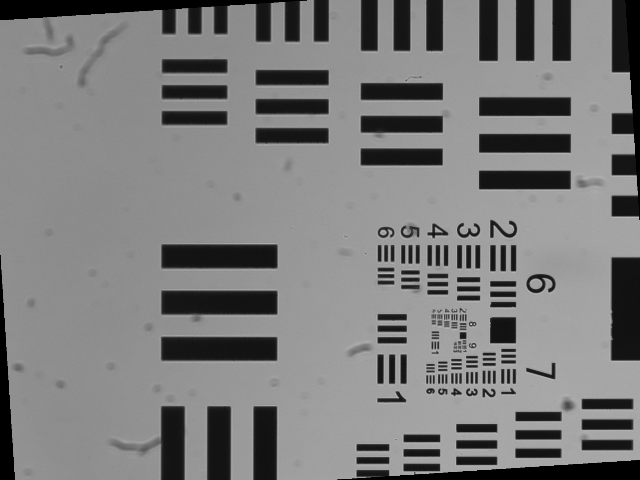
Calculations/USAF test map/Sample 3/Chart 3 (rotated).tif
