Thommie0208/TURTLE/Calculations/USAF test map/Sample 3/Chart 3.bmp

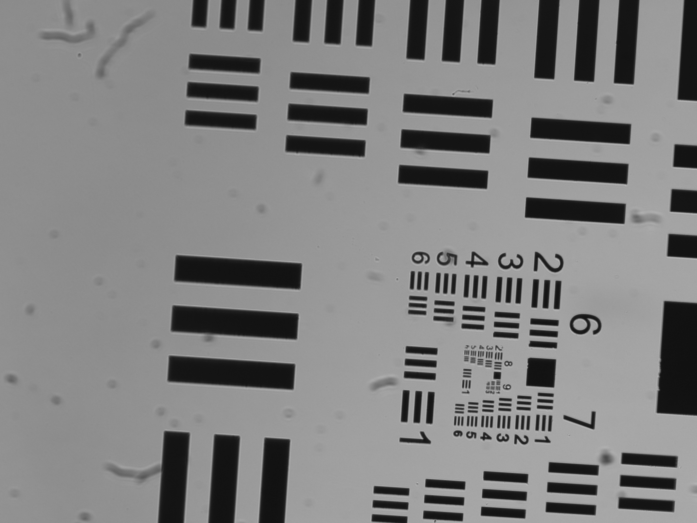
Calculations/USAF test map/Sample 3/Chart 3.bmp
