Thommie0208/TURTLE/Calculations/USAF test map/Sample 3/Group 8 Element 6 (vert) - Resovable Y.tif

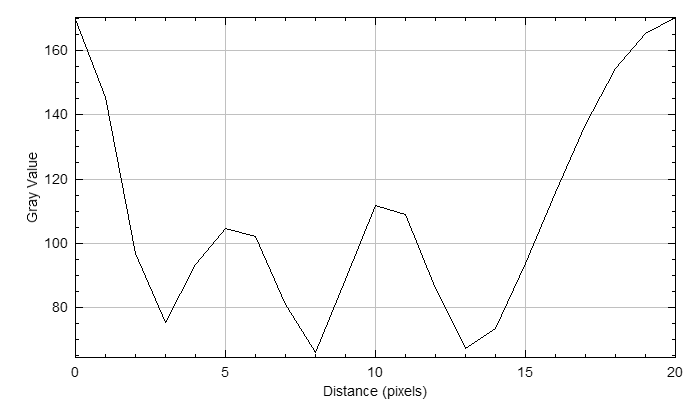
Calculations/USAF test map/Sample 3/Group 8 Element 6 (vert) - Resovable Y.tif
