Thommie0208/TURTLE/Calculations/USAF test map/Sample 3/Group 9 Element 2 (hor) - Resovable Y.tif

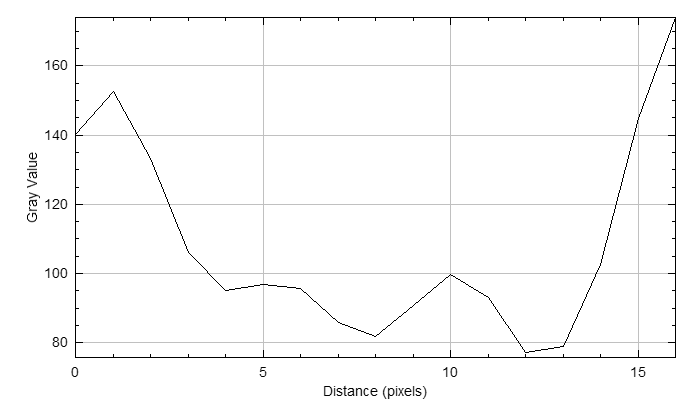
Calculations/USAF test map/Sample 3/Group 9 Element 2 (hor) - Resovable Y.tif
