Thommie0208/TURTLE/Calculations/USAF test map/Sample 3/Group 9 Element 3 (vert) - Resovable N.tif

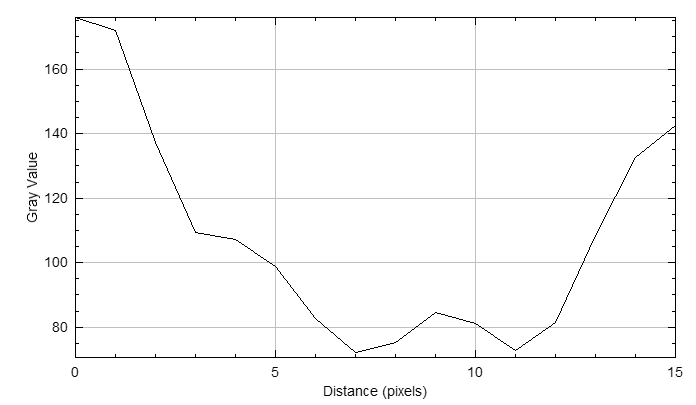
Calculations/USAF test map/Sample 3/Group 9 Element 3 (vert) - Resovable N.tif
