Thommie0208/TURTLE/Calculations/USAF test map/Sample 4/Chart 4 (rotated).tif

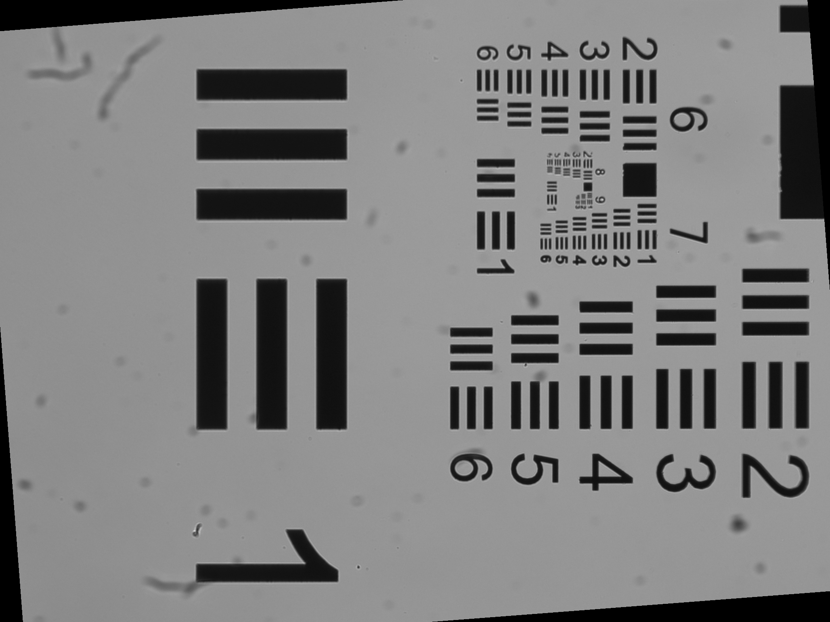
Calculations/USAF test map/Sample 4/Chart 4 (rotated).tif
