Thommie0208/TURTLE/Calculations/USAF test map/Sample 4/Chart 4.bmp

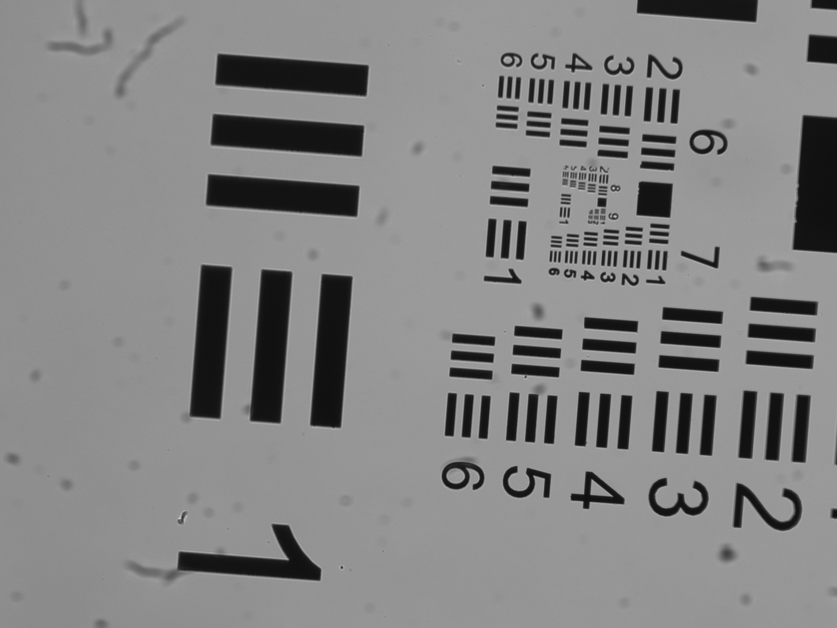
Calculations/USAF test map/Sample 4/Chart 4.bmp
