Thommie0208/TURTLE/Calculations/USAF test map/Sample 4/Group 6 Element 1 (hor).tif

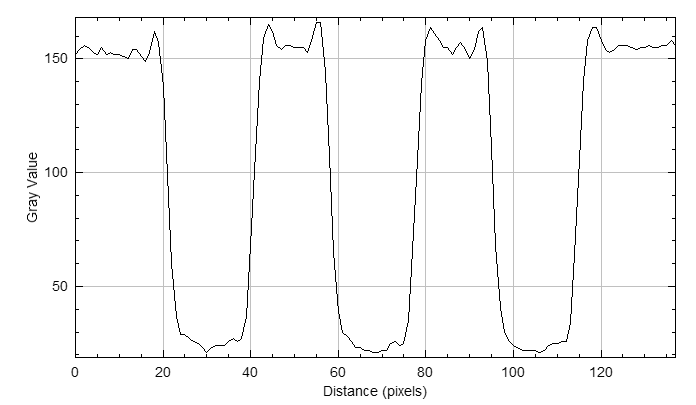
Calculations/USAF test map/Sample 4/Group 6 Element 1 (hor).tif
