Thommie0208/TURTLE/Calculations/USAF test map/Sample 4/Group 6 Element 1 (vert).tif

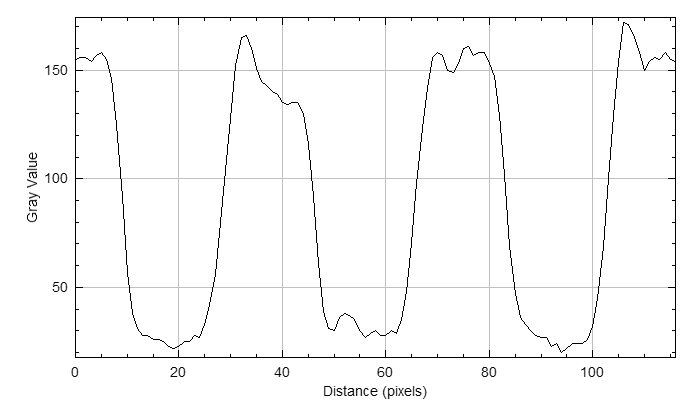
Calculations/USAF test map/Sample 4/Group 6 Element 1 (vert).tif
