Thommie0208/TURTLE/Calculations/USAF test map/Sample 4/Group 8 Element 5 (vert).png

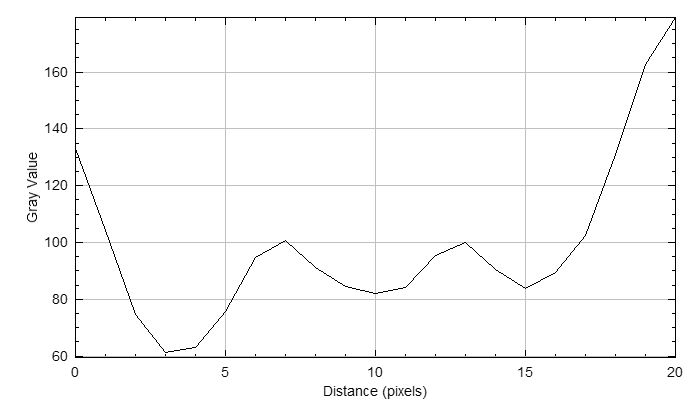
Calculations/USAF test map/Sample 4/Group 8 Element 5 (vert).png
