Thommie0208/TURTLE/Calculations/USAF test map/Sample 4/Group 8 Element 6 (vert) - Resovable N.tif

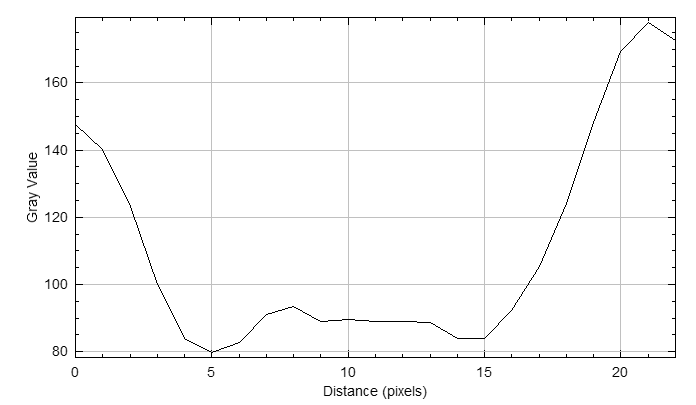
Calculations/USAF test map/Sample 4/Group 8 Element 6 (vert) - Resovable N.tif
