Thommie0208/TURTLE/Calculations/USAF test map/Sample 5/Chart 5 (rotated).tif

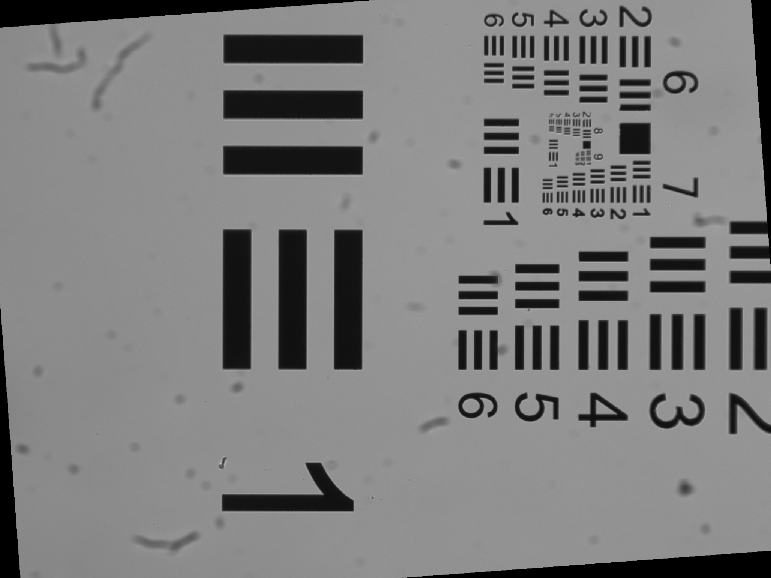
Calculations/USAF test map/Sample 5/Chart 5 (rotated).tif
