Thommie0208/TURTLE/Calculations/USAF test map/Sample 5/Chart 5.bmp

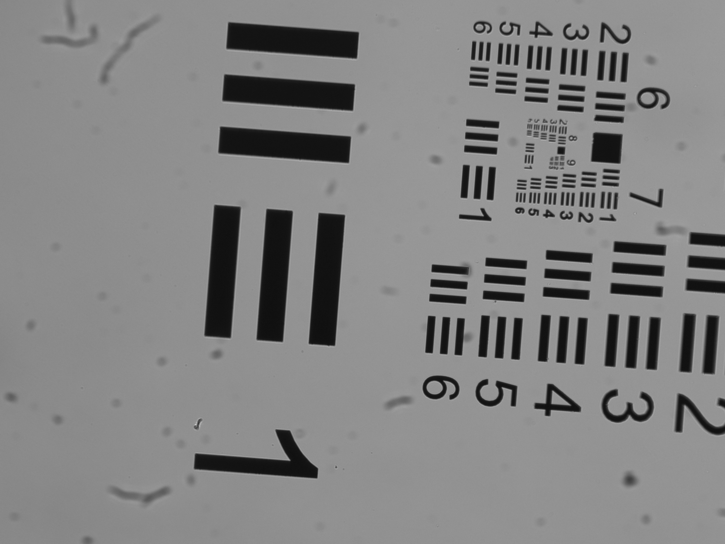
Calculations/USAF test map/Sample 5/Chart 5.bmp
