Thommie0208/TURTLE/Calculations/USAF test map/Sample 5/Group 6 Element 1 (hor).tif

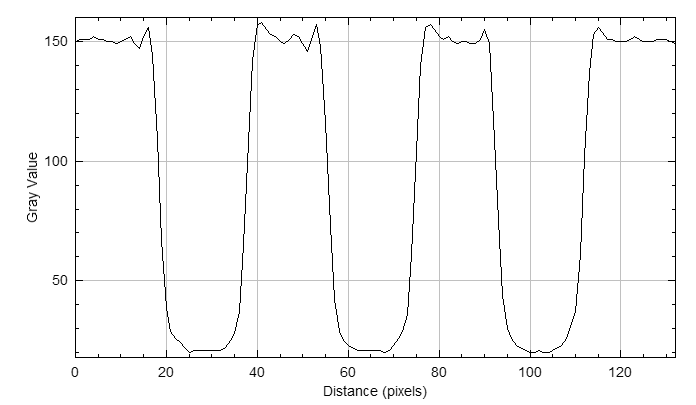
Calculations/USAF test map/Sample 5/Group 6 Element 1 (hor).tif
