Thommie0208/TURTLE/Calculations/USAF test map/Sample 5/Group 8 Element 5 (hor).tif

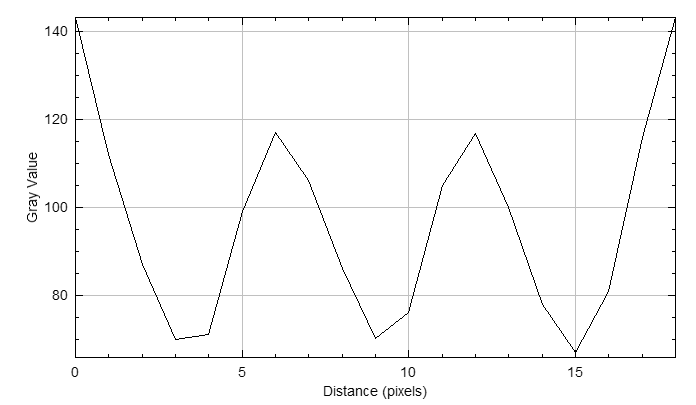
Calculations/USAF test map/Sample 5/Group 8 Element 5 (hor).tif
