Thommie0208/TURTLE/Calculations/USAF test map/Sample 5/Group 9 Element 1 (hor) - Resovable Y.tif

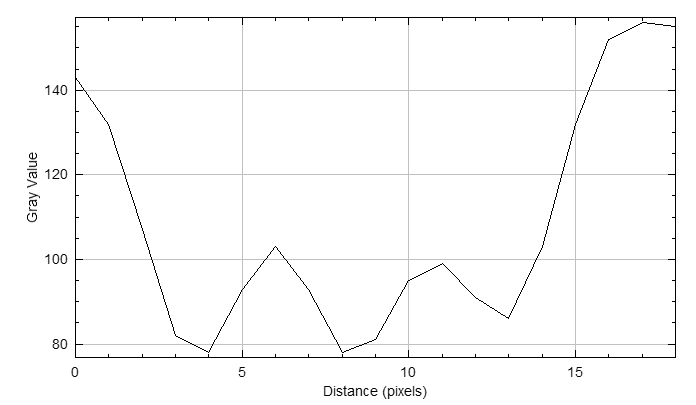
Calculations/USAF test map/Sample 5/Group 9 Element 1 (hor) - Resovable Y.tif
