Thommie0208/TURTLE/Calculations/USAF test map/Sample 5/Group 9 Element 2 (hor) - Resovable N.tif

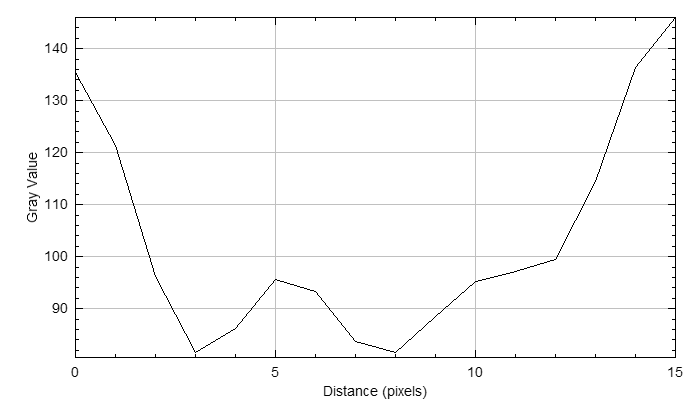
Calculations/USAF test map/Sample 5/Group 9 Element 2 (hor) - Resovable N.tif
