Thommie0208/TURTLE/Calculations/USAF test map/Sample 6/Chart 6.bmp

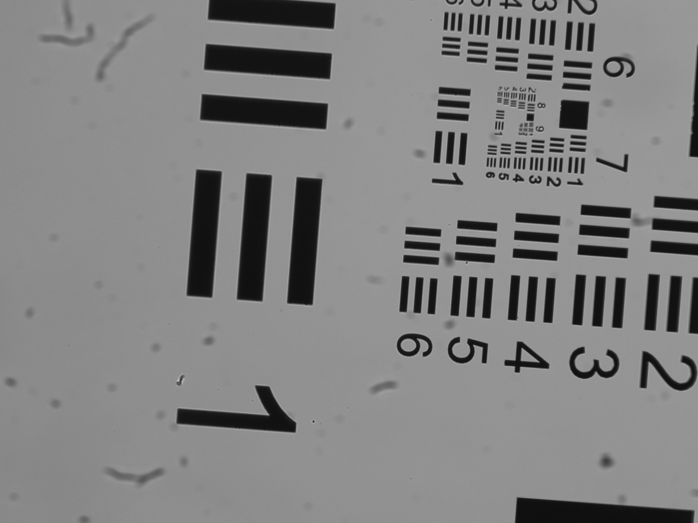
Calculations/USAF test map/Sample 6/Chart 6.bmp
