Thommie0208/TURTLE/Calculations/USAF test map/Sample 7/Chart 7.bmp

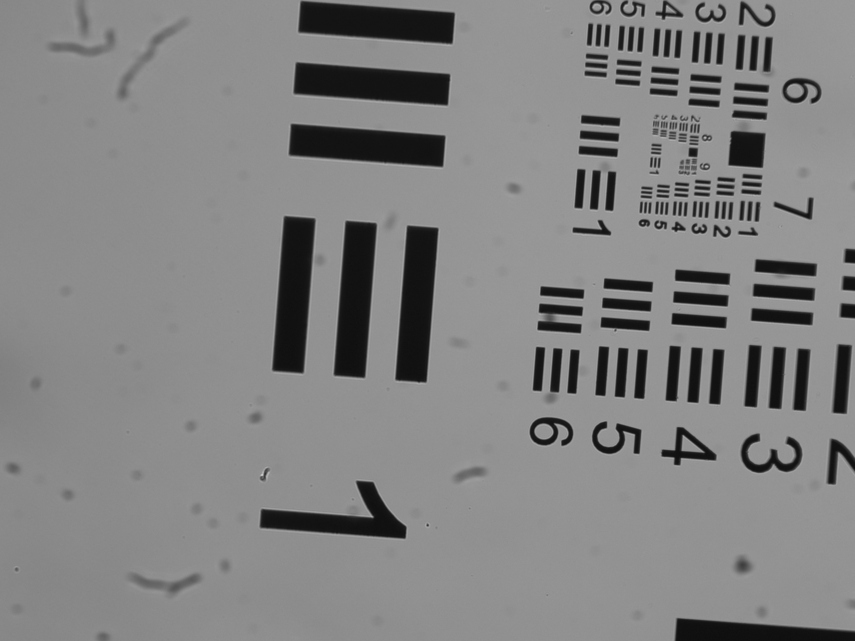
Calculations/USAF test map/Sample 7/Chart 7.bmp
