Thommie0208/TURTLE/Calculations/USAF test map/Sample 8/Chart 8.bmp

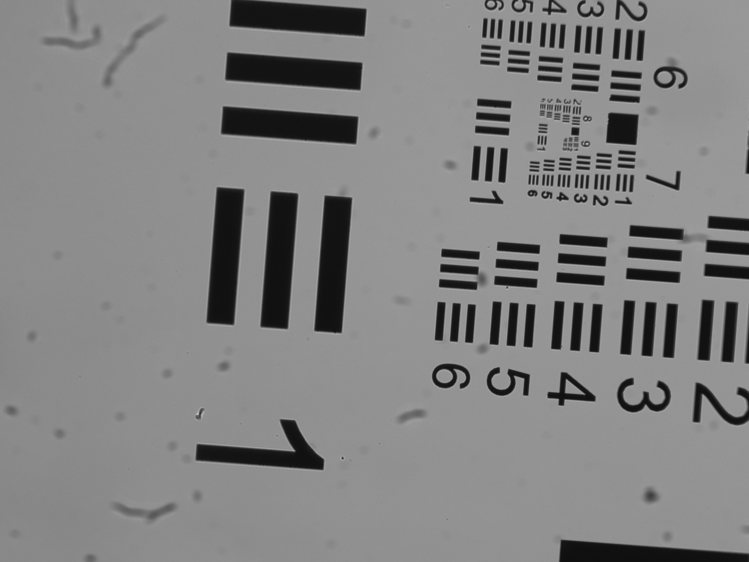
Calculations/USAF test map/Sample 8/Chart 8.bmp
