Thommie0208/TURTLE/Calculations/USAF test map/Sample 9/chart 9.bmp

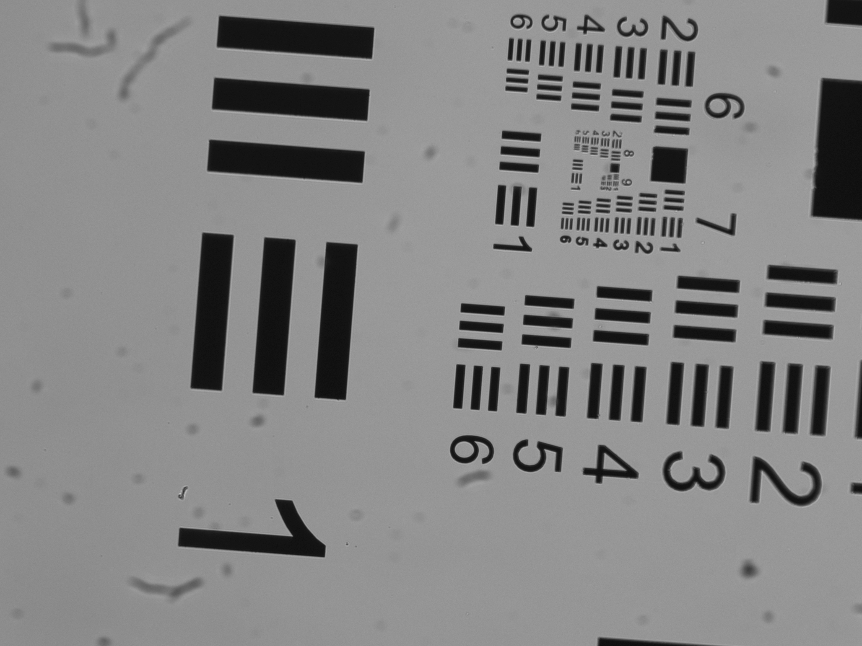
Calculations/USAF test map/Sample 9/chart 9.bmp
