Thommie0208/TURTLE/Calculations/USAF test map/Sample 10/Chart 10 (not the best).bmp

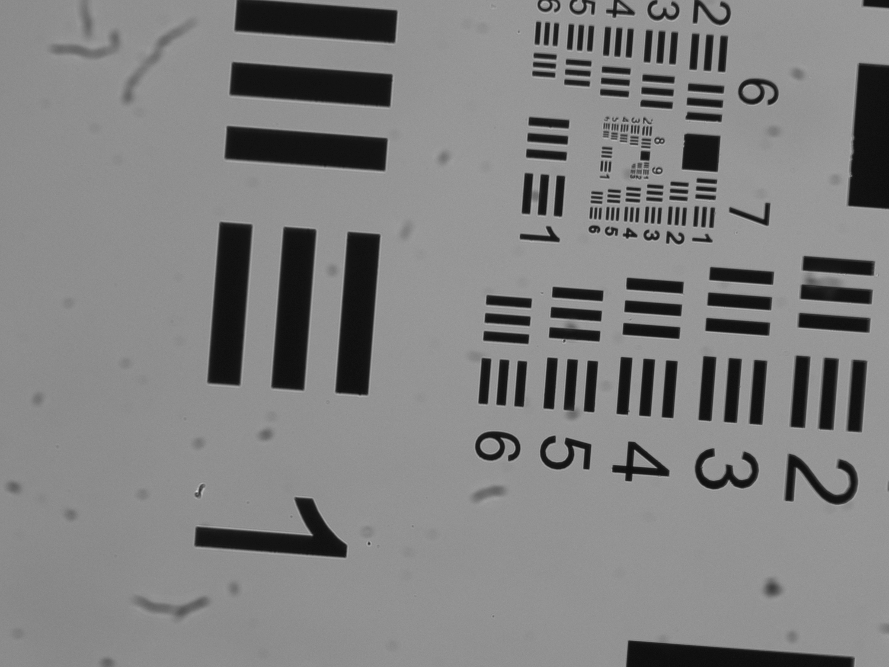
Calculations/USAF test map/Sample 10/Chart 10 (not the best).bmp
