Thommie0208/TURTLE/(commit log)

2026-04-21 Thorlabs lens en openflexure
2026-05-12 Added calculation file for holding torque of z-axis
2026-05-15 alles gechecked en nu de UC2 camera gebruikt
2026-05-22 Updated parameters holding torque
2026-05-27 Script for making photo's on Raspberry Pi
2026-05-28 Moved the console down for camera space
2026-05-28 Linked capture button to the correct place in app.py
    [app.py]
2026-05-28 System now deletes livestream picture at the end. Also added failsafe for when an empty string is inputted
    [ImageGrabAndSave.py, app.py]
2026-05-28 Added buttons to set points for image stitching
2026-05-29 Removed z-axis from points for image stitching
2026-05-29 Added start stitching button
2026-05-29 Added buttons to start stitching and reset button renamed
2026-06-01 Fixed overlap being a % instead of a fraction. Also added final catch all for pico commandline
    [CleanMain.py, app.py]
2026-06-01 Image stitching working for moto/camera control
2026-06-01 Fixed file extention required for Image Stitching
    [Image_Stitcher.py, app.py]
2026-06-01 Solved a +1 issue on the tile count
    [Image_Stitcher.py, app.py]
2026-06-01 Fixed how the tiles are made for image stitching
    [app.py]
2026-06-01 Fixed folder not getting created (hopefully)
    [app.py]
2026-06-01 Camera FoV now calculated by parameters
2026-06-02 Attempted fix for error 500
    [app.py]
2026-06-02 Increased the time the pico waits
2026-06-02 Fixed the holding button staying down too long
2026-06-02 Added servo control
2026-06-15 Added CAD files
    [1x10mm Steel Pin.SLDPRT, 28BYJ-48.SLDPRT, 3d-printed motor-spindle.SLDPRT, 3mmx6 pin.SLDPRT, 5mm Steel Ball.SLDPRT, 6mm-as.SLDPRT, ACL1512U-A-Solidworks.sldprt, Assem1.SLDASM]
2026-06-17 Added script and images to determine resolvability for USAF
    [Group 6 Element 1 (hor).csv, Group 6 Element 1 (vert).csv, Group 8 Element 5 (hor).csv, Group 8 Element 5 (vert).csv, Group 8 Element 6 (hor).csv, Group 8 Element 6 (vert).csv, Group 9 Element 1 (hor).csv, Group 9 Element 1 (vert).csv]
2026-06-17 Modified the script to automatically run all samples (1-5)
2026-06-19 Added mirror mounts to the cad files
    [1 Inch Backplate - Gimbal Mount - Thor Adapted.SLDPRT, 1x10mm Steel Pin.SLDPRT, 28BYJ-48.SLDPRT, 3d-printed motor-spindle.SLDPRT, 3mmx6 pin.SLDPRT, 5mm Steel Ball.SLDPRT, 6mm-as.SLDPRT, ACL1512U-A-Solidworks.sldprt]
